VerivoltDev/test_board/modules/footprint/ESP32C3_super_mini.step

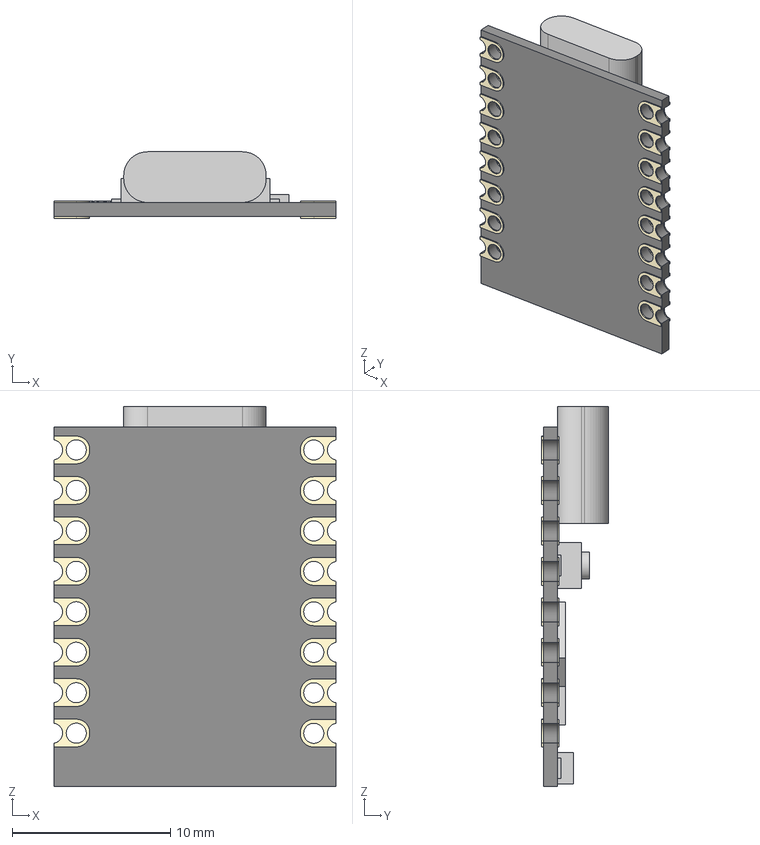
[picture p1: CAD file, 2025-04-20]
modules/footprint/ESP32C3_super_mini.step
17.8 x 4.20 x 24.0 mm
