VerivoltDev/test_board/modules/Symbol/ESP32-C3_SUPERMINI_TH.step

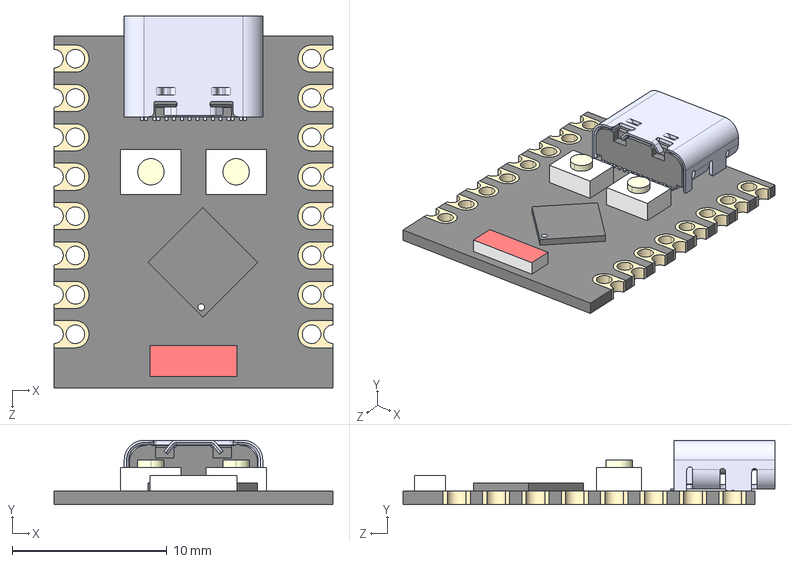
[picture p2: CAD file, 2025-04-15]
modules/Symbol/ESP32-C3_SUPERMINI_TH.step
18.0 x 4.16 x 24.0 mm
Board c3mini
USB C
components (other)^ESP32-C3 SuperMini
