VerivoltDev/test_board/test_board/kicad-modules/shapes3d/D3V3F8U9LP3810-7.stp

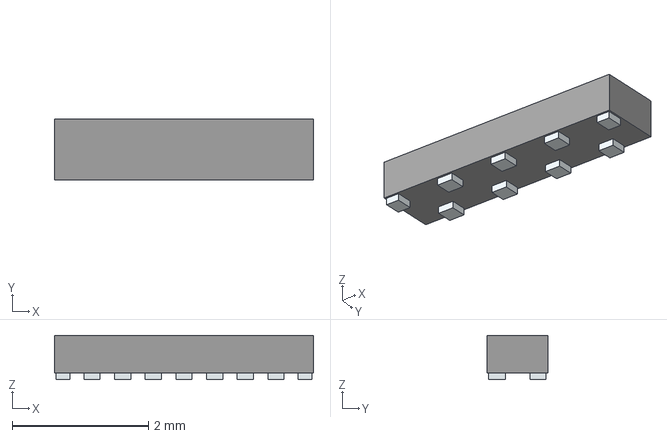
[picture p3: CAD file, 2025-04-15]
test_board/kicad-modules/shapes3d/D3V3F8U9LP3810-7.stp
3.80 x 0.9 x 0.65 mm
Pins
