VerivoltDev/test_board/modules/footprint/QFN50P450X350X100-21N.step

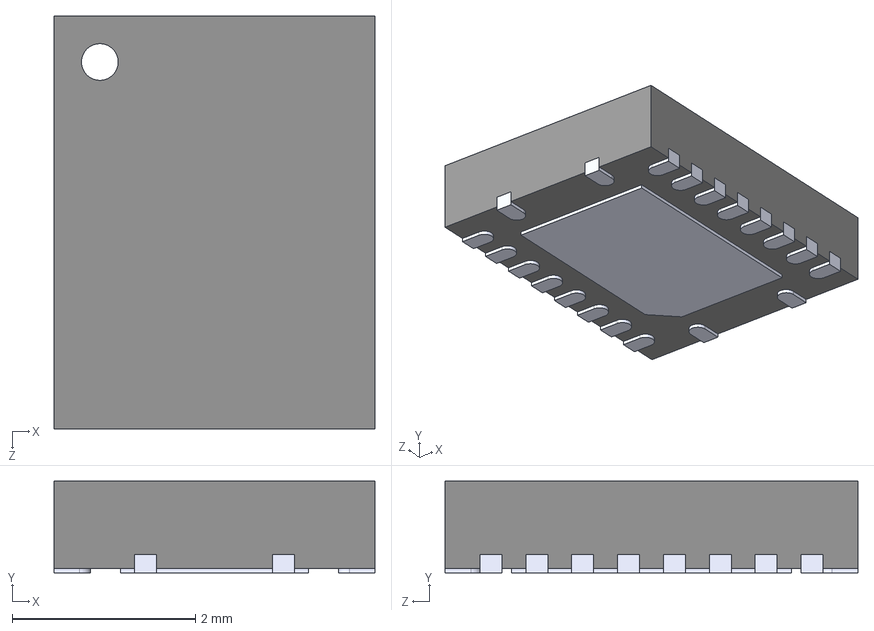
[picture p4: CAD file, 2025-04-15]
modules/footprint/QFN50P450X350X100-21N.step
3.50 x 1.00 x 4.50 mm
