VerivoltDev/test_board/test_board/kicad-modules/shapes3d/S_5_ADI.step

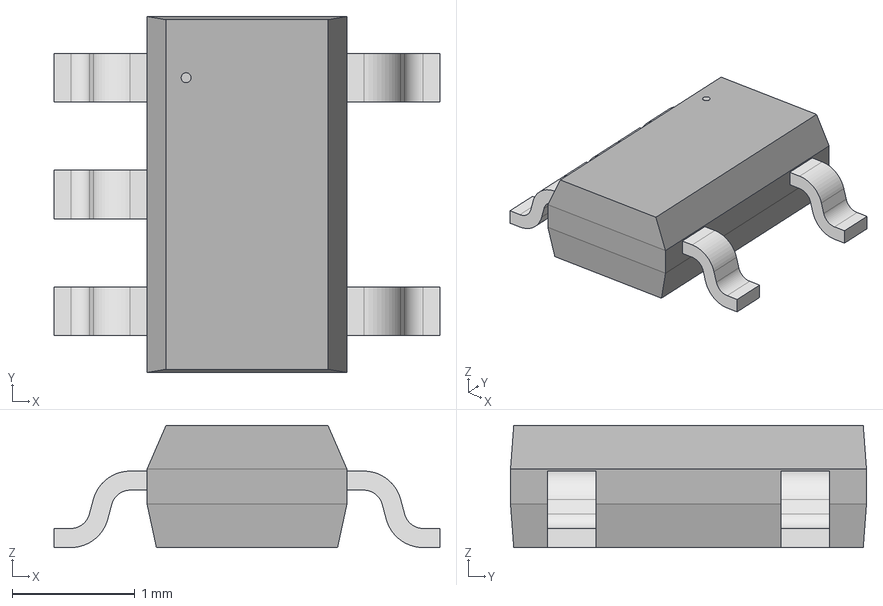
[picture p5: CAD file, 2025-04-15]
test_board/kicad-modules/shapes3d/S_5_ADI.step
3.14 x 2.90 x 0.993 mm
