VerivoltDev/test_board/modules/footprint/LPJ4011ABNL.STEP

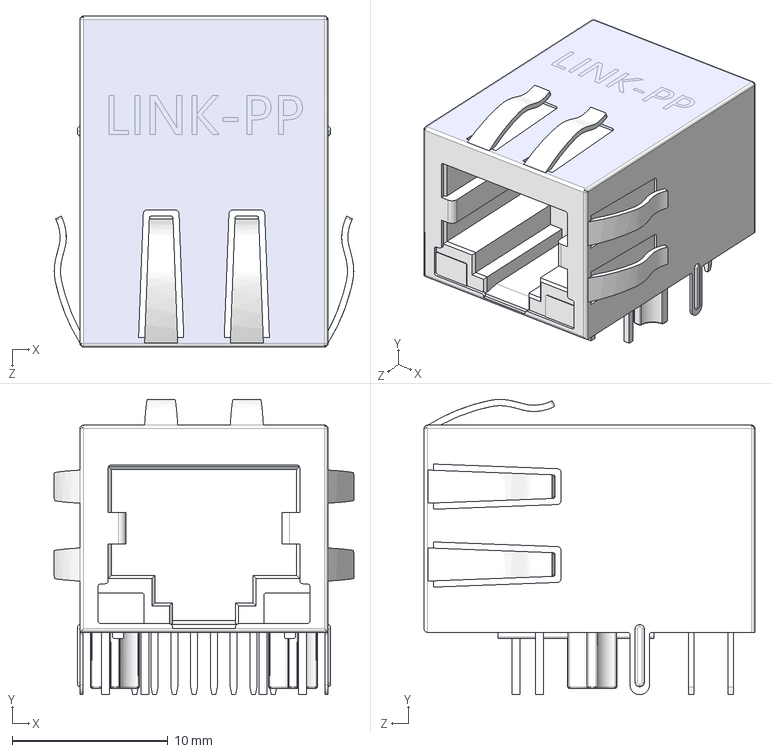
[picture p6: CAD file, 2025-04-15]
modules/footprint/LPJ4011ABNL.STEP
19.2 x 18.9 x 21.3 mm
