VerivoltDev/test_board/test_board/kicad-modules/shapes3d/PWP0020A_LM5116MH.stp

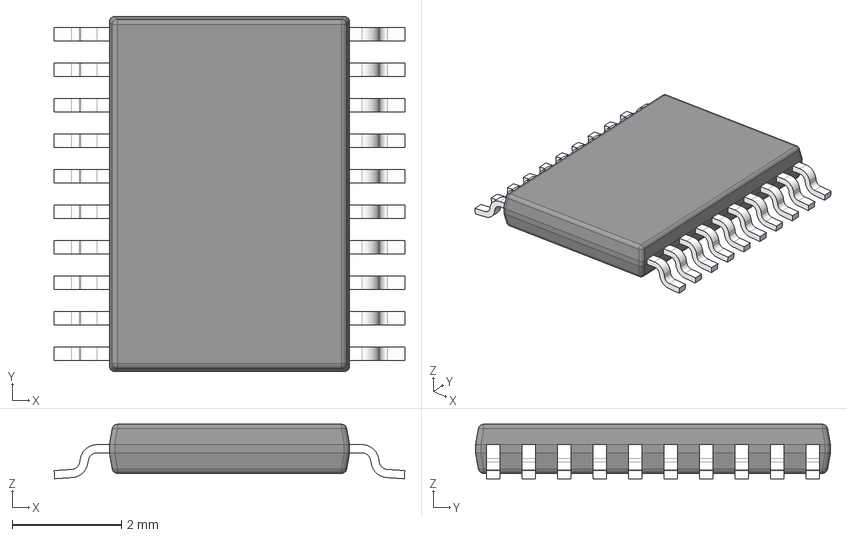
[picture p7: CAD file, 2025-04-15]
test_board/kicad-modules/shapes3d/PWP0020A_LM5116MH.stp
6.42 x 6.50 x 1.00 mm
BODY-SO
LEAD-SO x 20
THERMALPAD-SO
PIN1-ID
