VerivoltDev/test_board/modules/footprint/HD3SS3212IRKSR.step

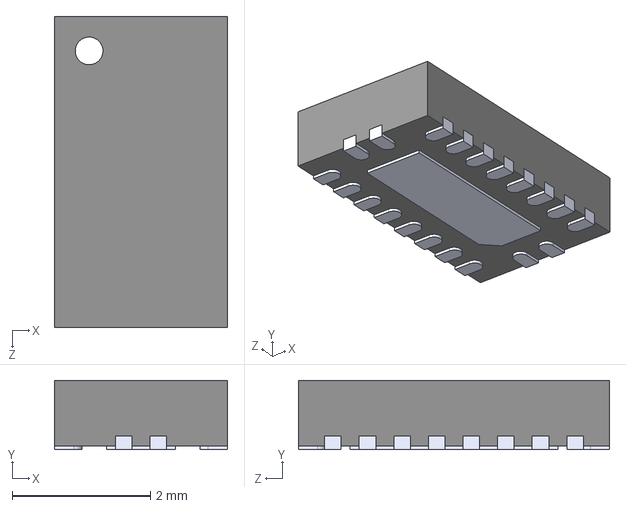
[picture p8: CAD file, 2025-04-15]
modules/footprint/HD3SS3212IRKSR.step
2.50 x 1.00 x 4.50 mm
