VerivoltDev/test_board/test_board/kicad-modules/shapes3d/PJS008U-3000-0.stp

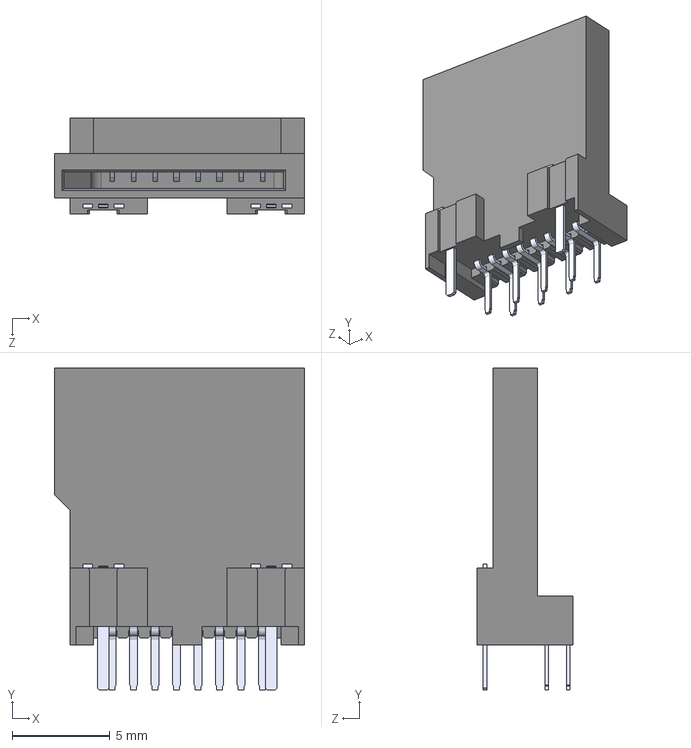
[picture p9: CAD file, 2025-04-15]
test_board/kicad-modules/shapes3d/PJS008U-3000-0.stp
12.8 x 16.5 x 4.90 mm
