VerivoltDev/test_board/test_board/kicad-modules/shapes3d/IND_MCZ1210AH_TDK.step

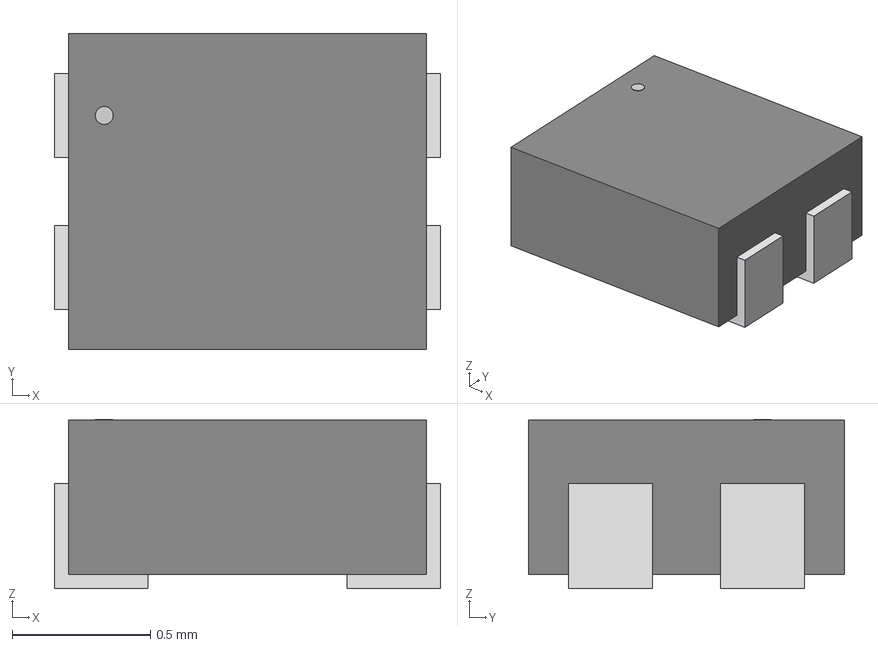
[picture p10: CAD file, 2025-04-15]
test_board/kicad-modules/shapes3d/IND_MCZ1210AH_TDK.step
1.40 x 1.14 x 0.612 mm
