VerivoltDev/test_board/modules/footprint/NX3225SA v2.step

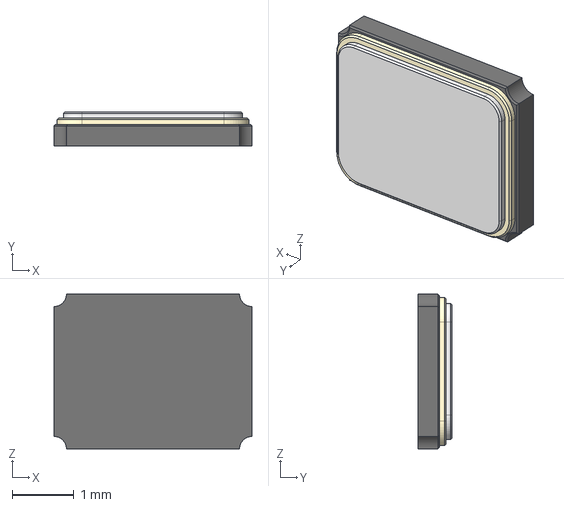
[picture p11: CAD file, 2025-04-15]
modules/footprint/NX3225SA v2.step
3.20 x 0.55 x 2.50 mm
