VerivoltDev/test_board/test_board/kicad-modules/shapes3d/SWR204-NRTN-D02-ST-GA.STEP

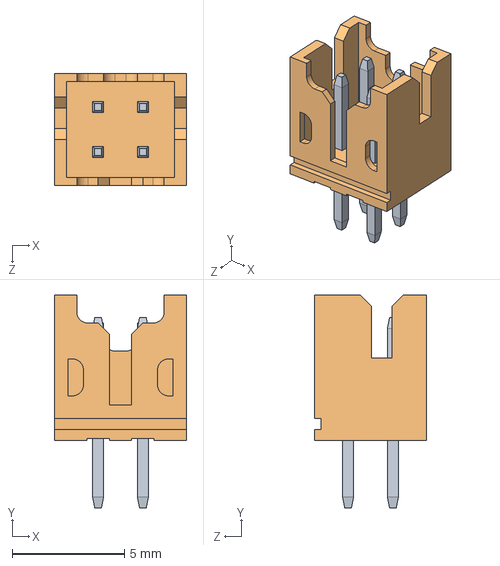
[picture p12: CAD file, 2025-04-15]
test_board/kicad-modules/shapes3d/SWR204-NRTN-D02-ST-GA.STEP
5.90 x 9.50 x 5.00 mm
