VerivoltDev/test_board/modules/footprint/SOT-23.step

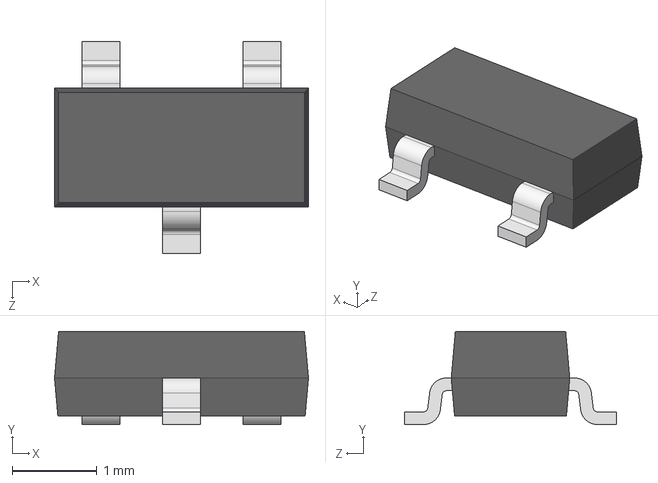
[picture p13: CAD file, 2025-04-15]
modules/footprint/SOT-23.step
3.00 x 1.10 x 2.50 mm
