VerivoltDev/test_board/test_board/kicad-modules/shapes3d/PJS008-2003-1.STEP

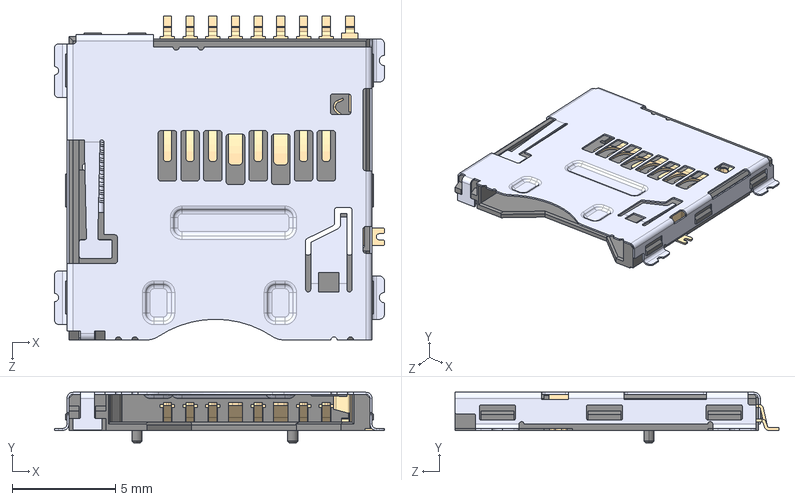
[picture p14: CAD file, 2025-04-15]
test_board/kicad-modules/shapes3d/PJS008-2003-1.STEP
16.0 x 2.45 x 15.7 mm
