VerivoltDev/test_board/modules/footprint/QFN-88_L9.0-W9.0-P0.35.step

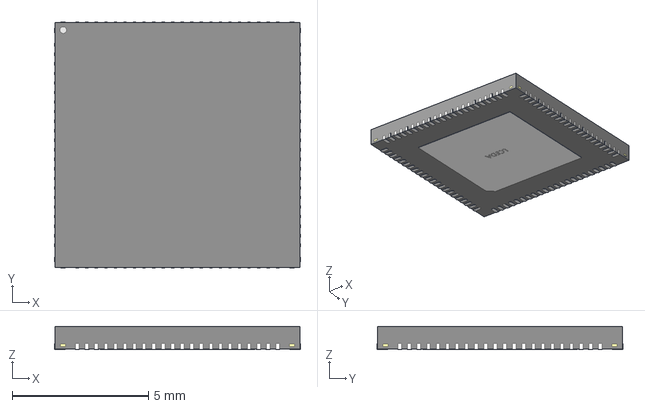
[picture p15: CAD file, 2025-04-15]
modules/footprint/QFN-88_L9.0-W9.0-P0.35.step
9.02 x 9.02 x 0.85 mm
