VerivoltDev/test_board/test_board/kicad-modules/shapes3d/DVE0016A_UCC12050DVER.stp

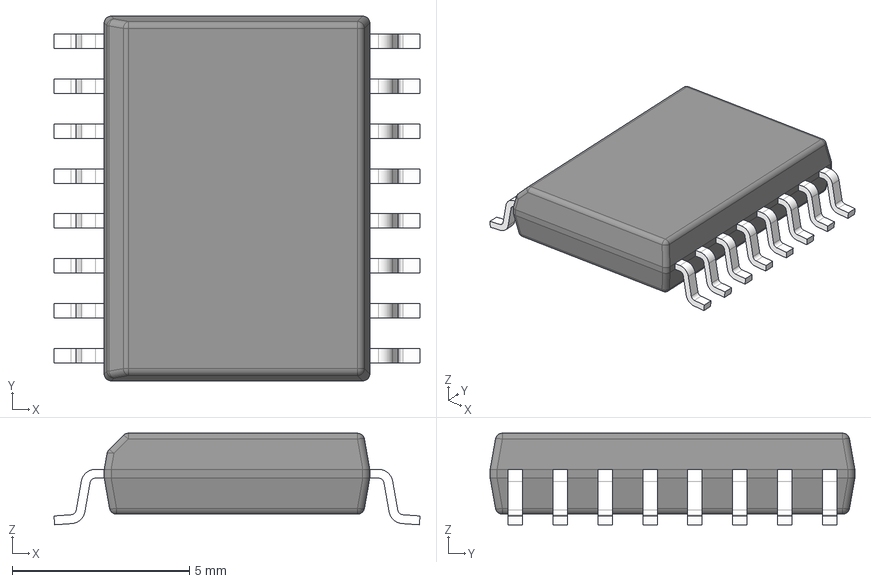
[picture p16: CAD file, 2025-04-15]
test_board/kicad-modules/shapes3d/DVE0016A_UCC12050DVER.stp
10.3 x 10.3 x 2.59 mm
BODY-DVE0016A
LEAD-DVE0016A x 16
