VerivoltDev/test_board/test_board/kicad-modules/shapes3d/2604-1101_000-023.stp

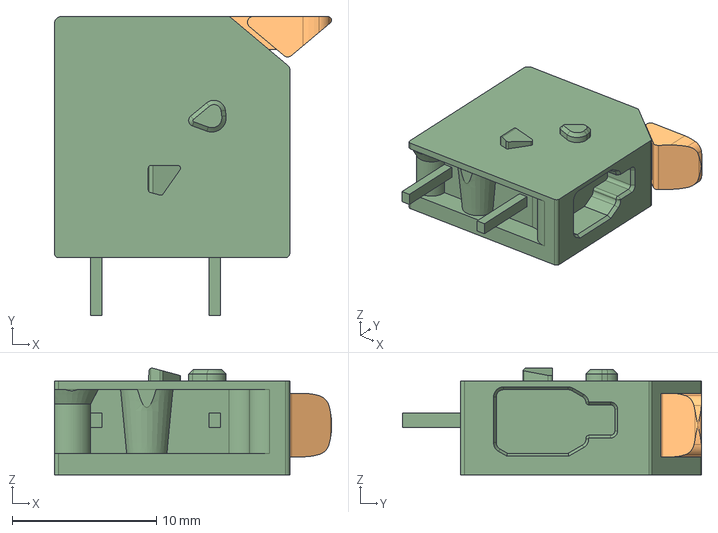
[picture p17: CAD file, 2025-04-15]
test_board/kicad-modules/shapes3d/2604-1101_000-023.stp
19.2 x 20.7 x 7.40 mm
