VerivoltDev/test_board/modules/footprint/JXS32.step

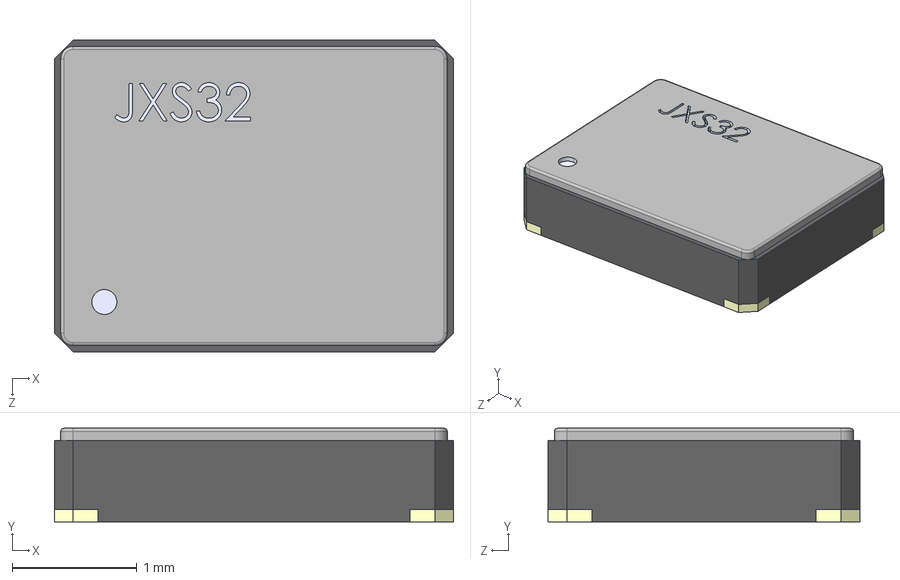
[picture p18: CAD file, 2025-04-15]
modules/footprint/JXS32.step
3.20 x 0.75 x 2.50 mm
