VerivoltDev/test_board/test_board/kicad-modules/shapes3d/WFBGA49_DDP_WIN.step

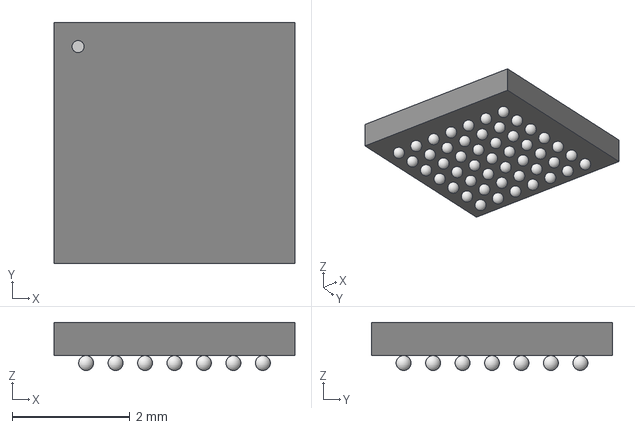
[picture p19: CAD file, 2025-04-15]
test_board/kicad-modules/shapes3d/WFBGA49_DDP_WIN.step
4.09 x 4.09 x 0.815 mm
