VerivoltDev/test_board/test_board/kicad-modules/shapes3d/VLP1-D-3.stp

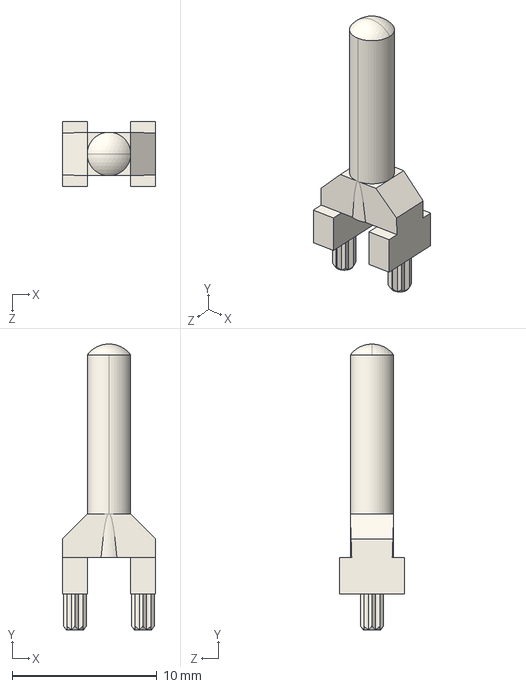
[picture p20: CAD file, 2025-04-15]
test_board/kicad-modules/shapes3d/VLP1-D-3.stp
6.40 x 19.8 x 4.50 mm
