VerivoltDev/test_board/test_board/kicad-modules/shapes3d/DFN-12_DD_LIT.step

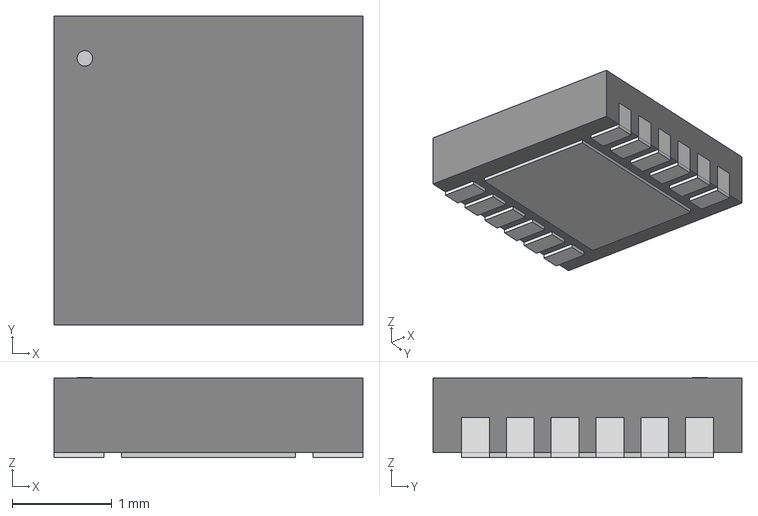
[picture p21: CAD file, 2025-04-15]
test_board/kicad-modules/shapes3d/DFN-12_DD_LIT.step
3.10 x 3.10 x 0.803 mm
