VerivoltDev/test_board/test_board/kicad-modules/shapes3d/Coilcraft-LPD5030V.STEP

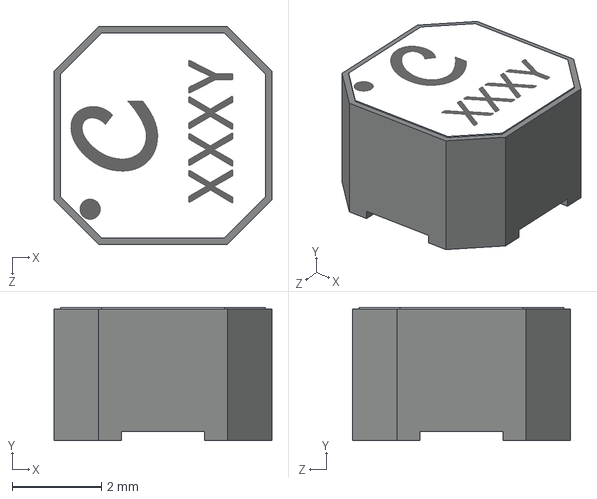
[picture p22: CAD file, 2025-04-15]
test_board/kicad-modules/shapes3d/Coilcraft-LPD5030V.STEP
4.88 x 2.98 x 4.88 mm
