VerivoltDev/test_board/test_board/kicad-modules/shapes3d/BGA38_11P25X9_ADI.step

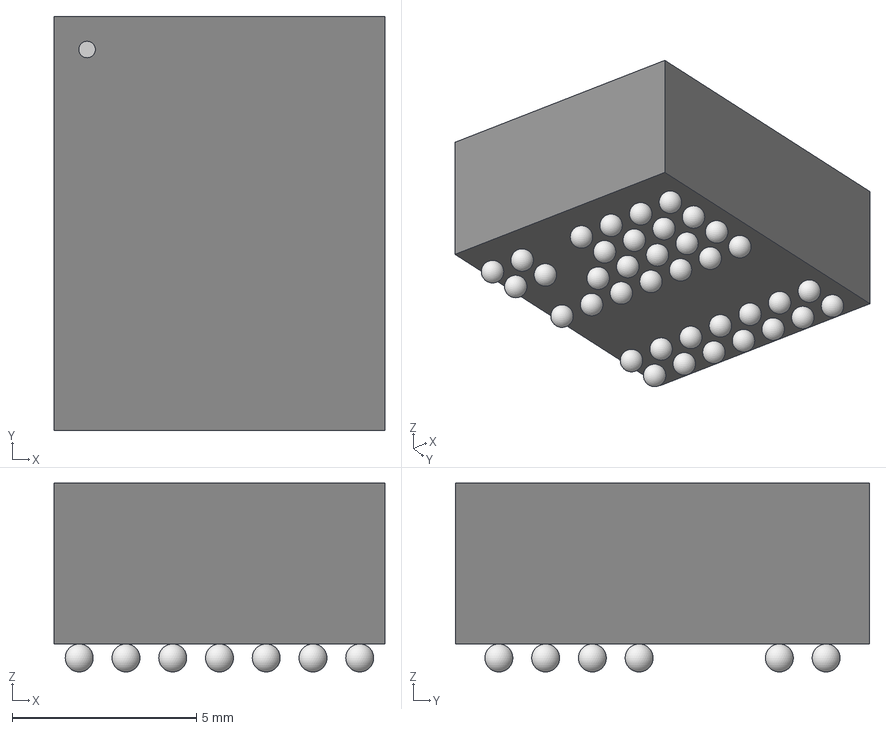
[picture p23: CAD file, 2025-04-15]
test_board/kicad-modules/shapes3d/BGA38_11P25X9_ADI.step
8.99 x 11.3 x 5.13 mm
