VerivoltDev/test_board/test_board/kicad-modules/shapes3d/SIS407DN-T1-GE3.STEP

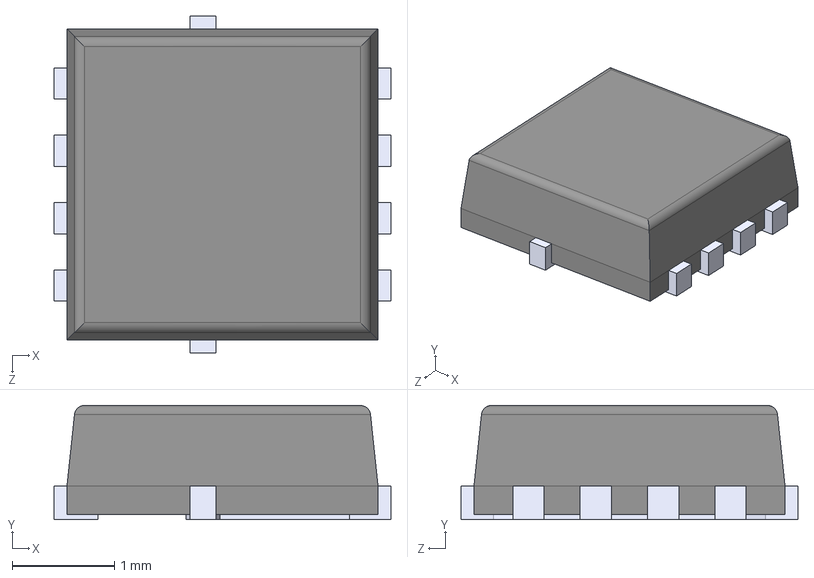
[picture p24: CAD file, 2025-04-15]
test_board/kicad-modules/shapes3d/SIS407DN-T1-GE3.STEP
3.30 x 1.12 x 3.30 mm
