VerivoltDev/test_board/test_board/kicad-modules/shapes3d/ECS-2520MV-480-BN-TR.step

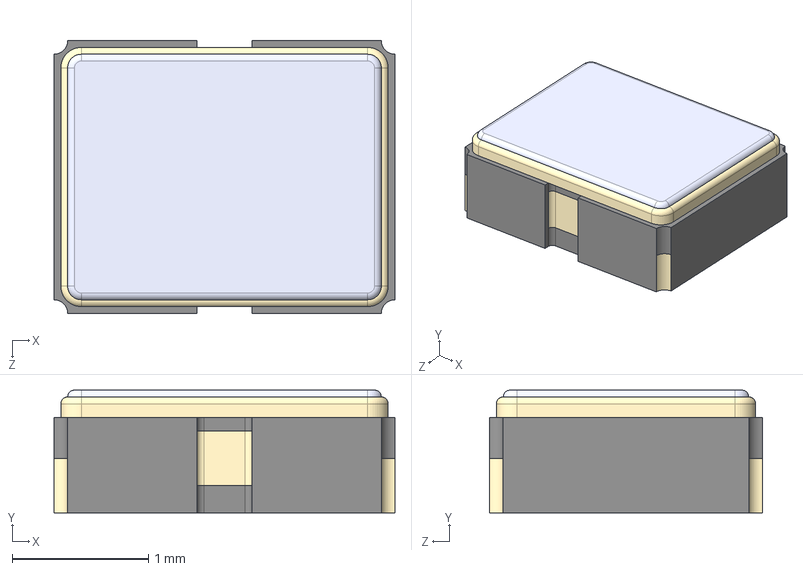
[picture p25: CAD file, 2025-04-15]
test_board/kicad-modules/shapes3d/ECS-2520MV-480-BN-TR.step
2.50 x 0.9 x 2.00 mm
