VerivoltDev/test_board/test_board/kicad-modules/shapes3d/TDA01H0SB1R.step

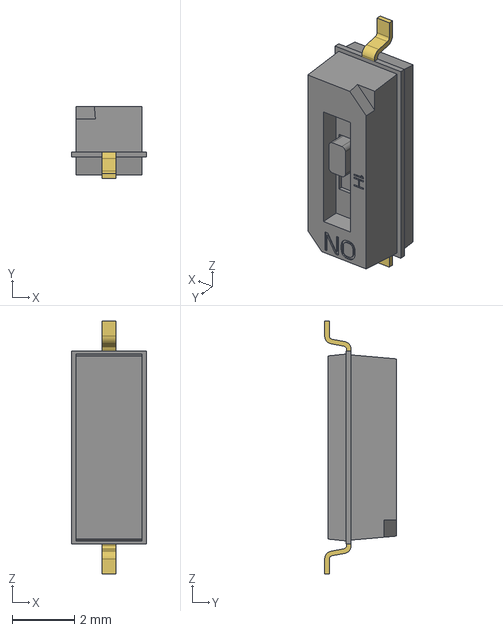
[picture p26: CAD file, 2025-04-15]
test_board/kicad-modules/shapes3d/TDA01H0SB1R.step
2.40 x 2.30 x 8.12 mm
