VerivoltDev/test_board/test_board/kicad-modules/shapes3d/c-2438987-1-1-USB_A.stp

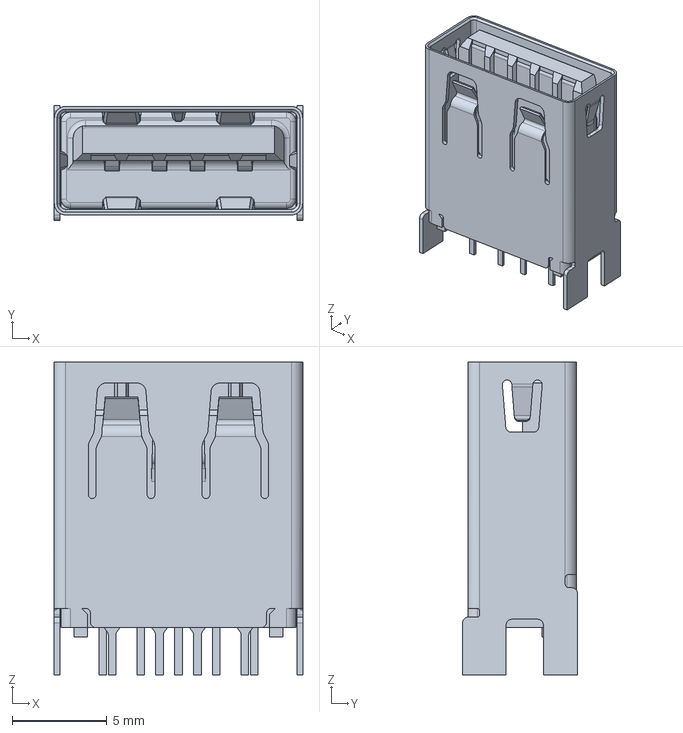
[picture p27: CAD file, 2025-04-15]
test_board/kicad-modules/shapes3d/c-2438987-1-1-USB_A.stp
13.1 x 6.06 x 16.5 mm
