VerivoltDev/test_board/test_board/kicad-modules/shapes3d/RGE0024C.stp

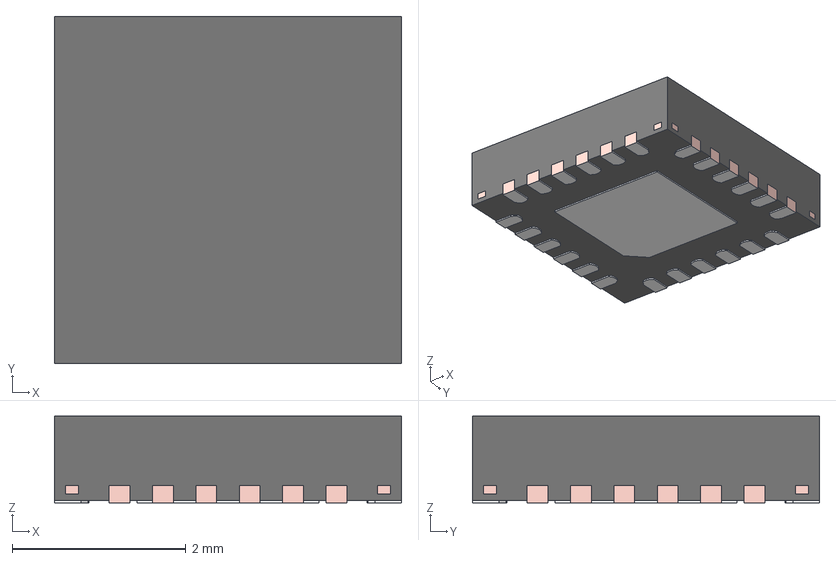
[picture p28: CAD file, 2025-04-15]
test_board/kicad-modules/shapes3d/RGE0024C.stp
4.00 x 4.00 x 1.00 mm
FRAME
