VerivoltDev/test_board/test_board/kicad-modules/shapes3d/TL7702BCDR.stp

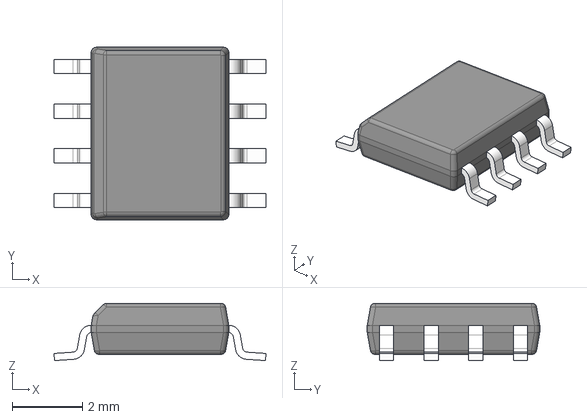
[picture p29: CAD file, 2025-04-15]
test_board/kicad-modules/shapes3d/TL7702BCDR.stp
6.02 x 4.90 x 1.63 mm
BODY-SO
LEAD-D0008A x 8
