VerivoltDev/test_board/test_board/kicad-modules/shapes3d/NGU0008B.stp

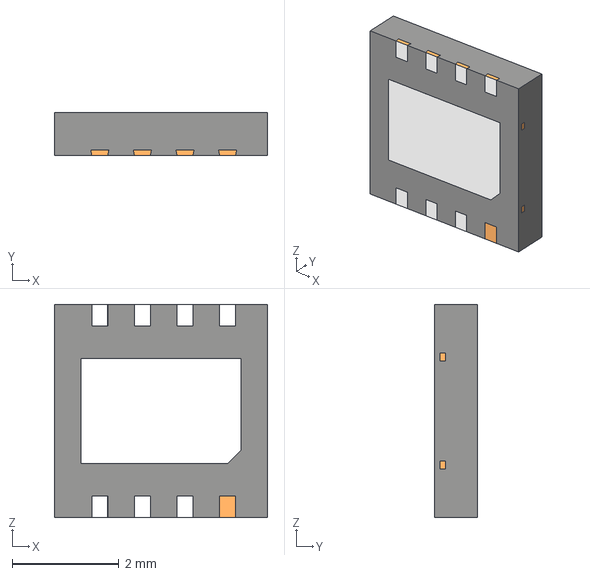
[picture p30: CAD file, 2025-04-15]
test_board/kicad-modules/shapes3d/NGU0008B.stp
4.00 x 0.8 x 4.00 mm
BODY_SDC08B
FRAME_SDC08B
