VerivoltDev/test_board/test_board/kicad-modules/shapes3d/QTH-040-04-X-D-DP-A.step

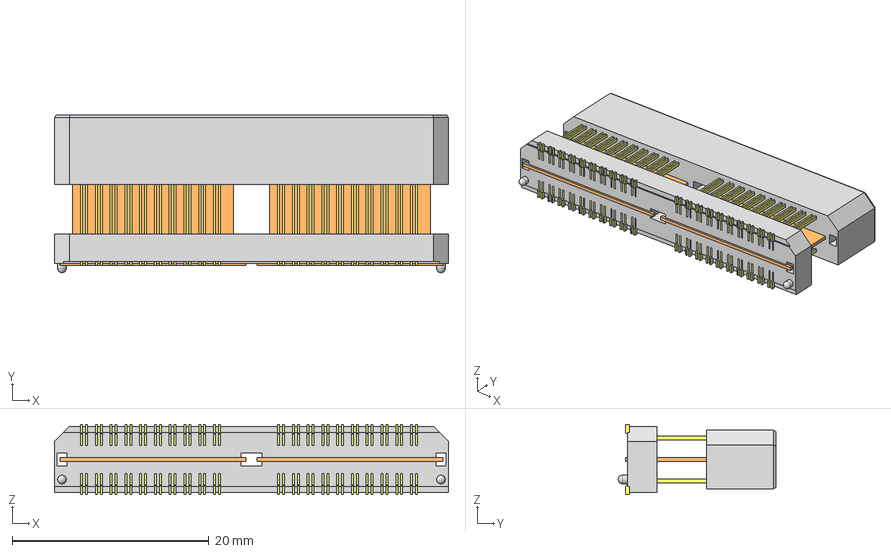
[picture p31: CAD file, 2025-04-15]
test_board/kicad-modules/shapes3d/QTH-040-04-X-D-DP-A.step
40.0 x 16.0 x 7.11 mm
LTQTH-040-04-L-D-DP-A_lower_terminal
T-1G1-04_imp x 2
T-1S60-04(-040-04-D-DP)_pin x 2
TQTH-040-04-L-D-DP-A_terminal
