VerivoltDev/test_board/test_board/kicad-modules/shapes3d/User Library-Countersunk_M2,5x12_H_real_thread.step

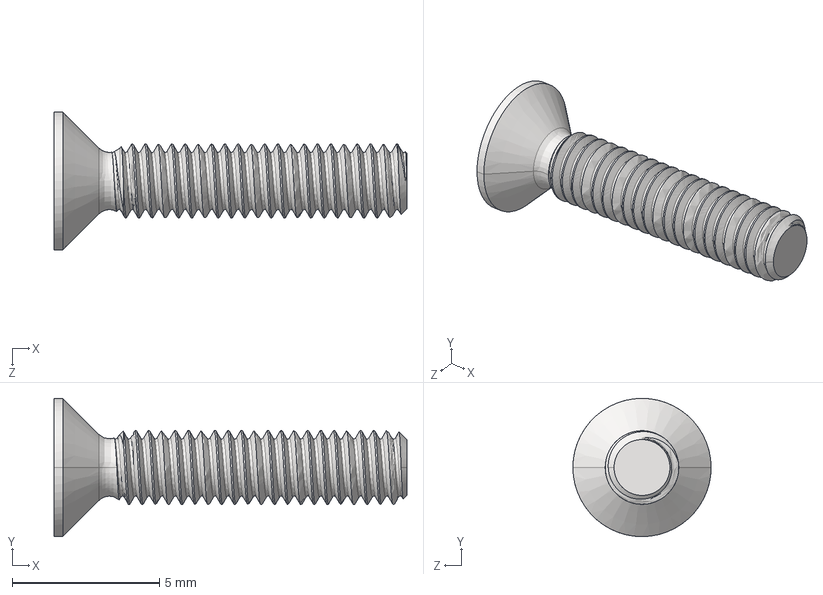
[picture p32: CAD file, 2025-04-15]
test_board/kicad-modules/shapes3d/User Library-Countersunk_M2,5x12_H_real_thread.step
12.0 x 4.70 x 4.70 mm
