VerivoltDev/test_board/test_board/kicad-modules/shapes3d/SCMR14C474PRBA0.stp

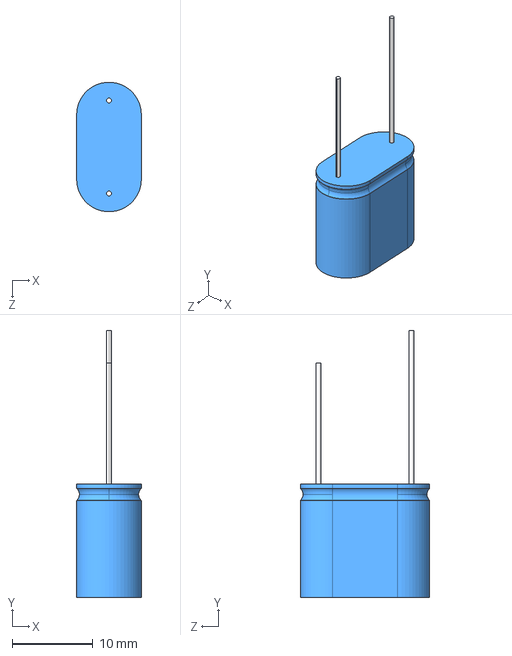
[picture p33: CAD file, 2025-04-15]
test_board/kicad-modules/shapes3d/SCMR14C474PRBA0.stp
8.00 x 33.0 x 16.0 mm
