VerivoltDev/test_board/test_board/kicad-modules/shapes3d/PDQE20-Q24-S5-D.step

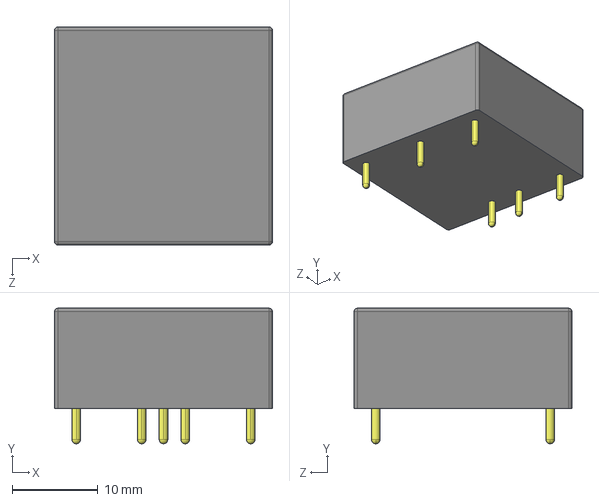
[picture p34: CAD file, 2025-04-15]
test_board/kicad-modules/shapes3d/PDQE20-Q24-S5-D.step
25.4 x 15.8 x 25.4 mm
