VerivoltDev/test_board/test_board/kicad-modules/shapes3d/ARJ-146.STEP

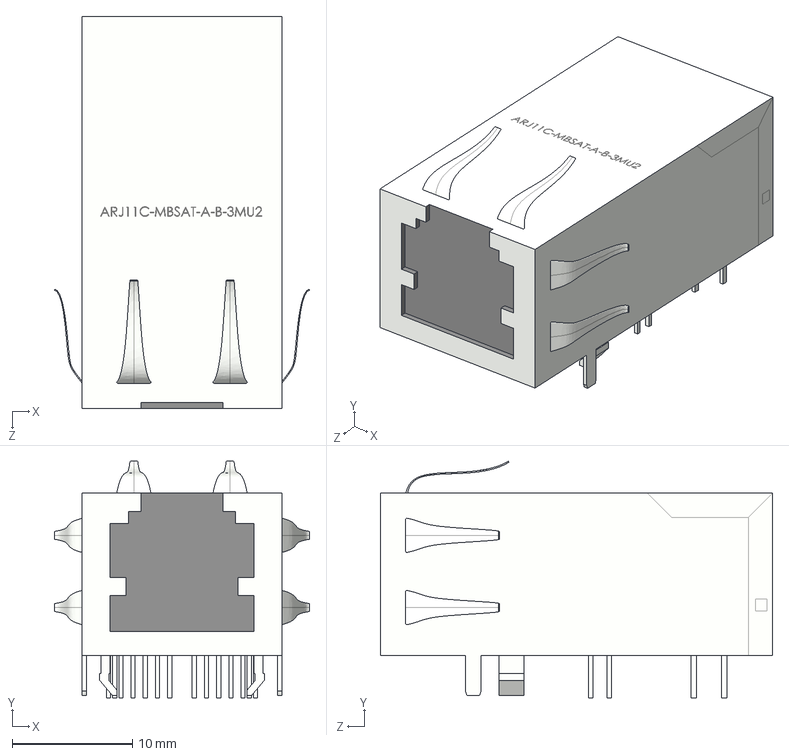
[picture p35: CAD file, 2025-04-15]
test_board/kicad-modules/shapes3d/ARJ-146.STEP
21.2 x 19.7 x 32.6 mm
