VerivoltDev/test_board/test_board/kicad-modules/shapes3d/RCU-0C.step

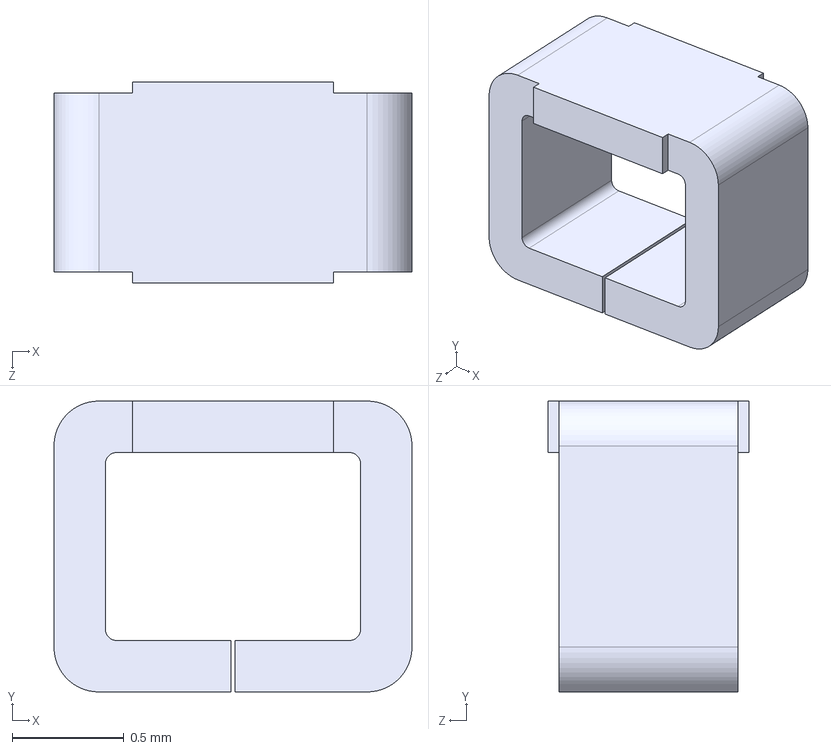
[picture p36: CAD file, 2025-04-15]
test_board/kicad-modules/shapes3d/RCU-0C.step
1.60 x 1.30 x 0.9 mm
