VerivoltDev/test_board/test_board/kicad-modules/shapes3d/B8B-PHDSS(LF)(SN).stp

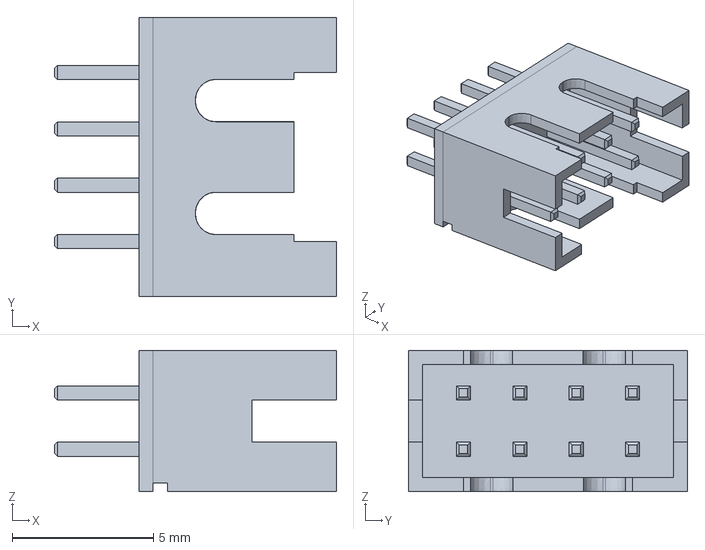
[picture p37: CAD file, 2025-04-15]
test_board/kicad-modules/shapes3d/B8B-PHDSS(LF)(SN).stp
10.0 x 9.90 x 5.00 mm
