VerivoltDev/test_board/test_board/kicad-modules/shapes3d/BGA-25_6P25X6P25_LIT.step

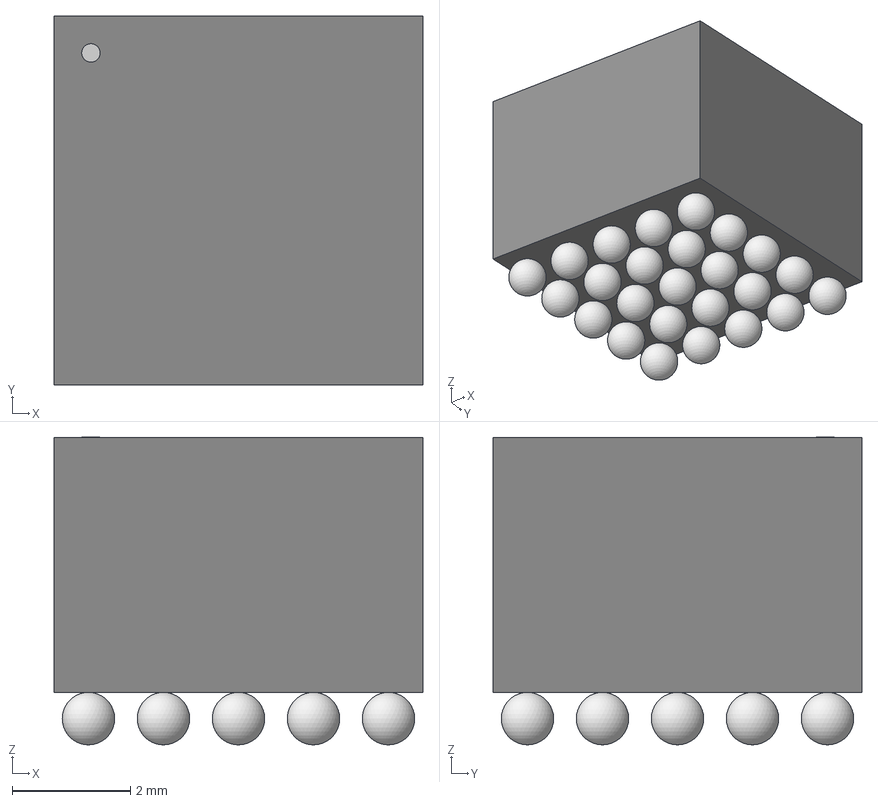
[picture p38: CAD file, 2025-04-15]
test_board/kicad-modules/shapes3d/BGA-25_6P25X6P25_LIT.step
6.25 x 6.25 x 5.21 mm
