VerivoltDev/test_board/test_board/kicad-modules/shapes3d/DFN_2PU50R_STM.step

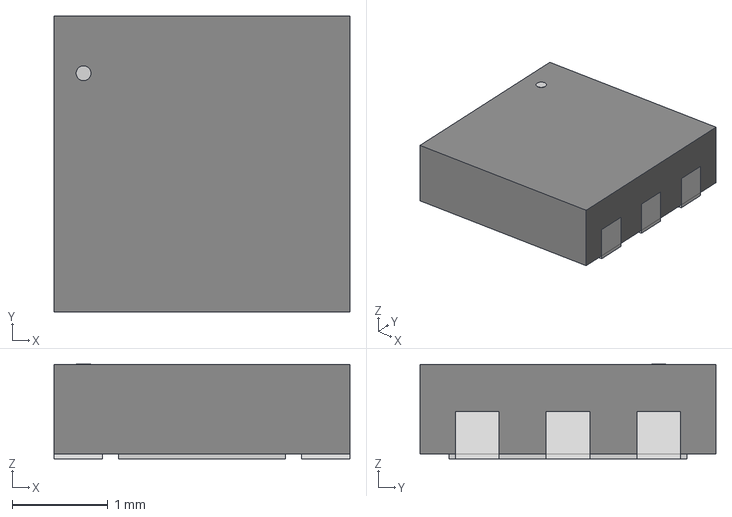
[picture p39: CAD file, 2025-04-15]
test_board/kicad-modules/shapes3d/DFN_2PU50R_STM.step
3.10 x 3.10 x 0.993 mm
