VerivoltDev/test_board/test_board/kicad-modules/shapes3d/WA-SMSI_9774XXX243.step

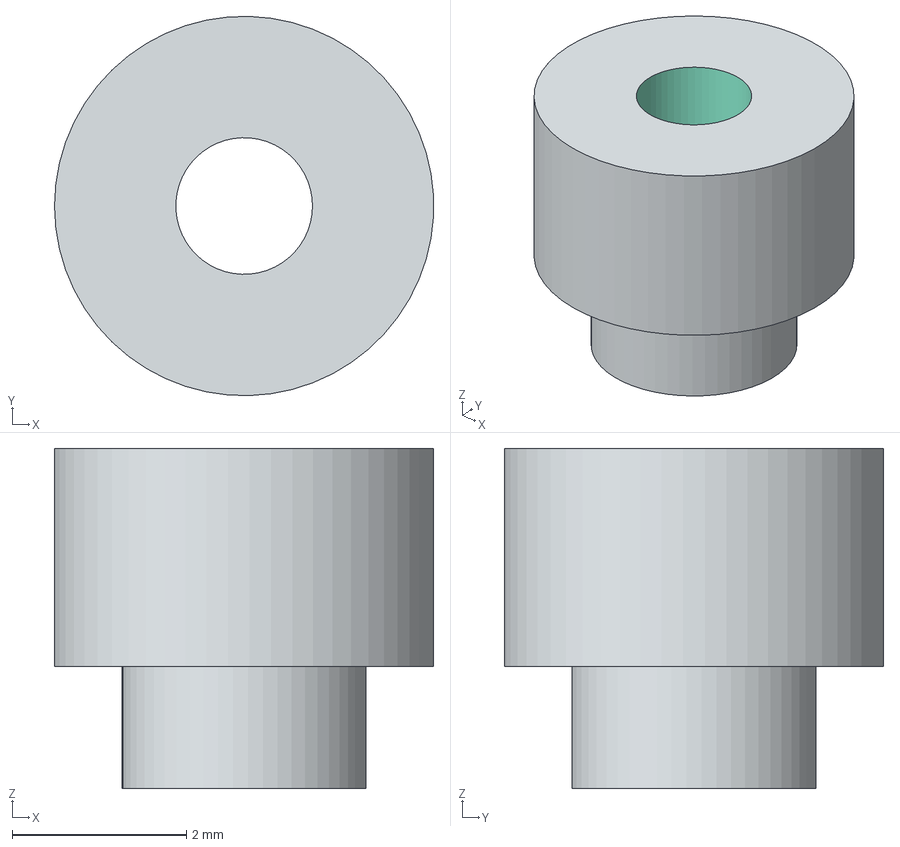
[picture p40: CAD file, 2025-04-15]
test_board/kicad-modules/shapes3d/WA-SMSI_9774XXX243.step
4.35 x 4.35 x 3.90 mm
