VerivoltDev/test_board/test_board/kicad-modules/shapes3d/ST_64_2_ADI.step

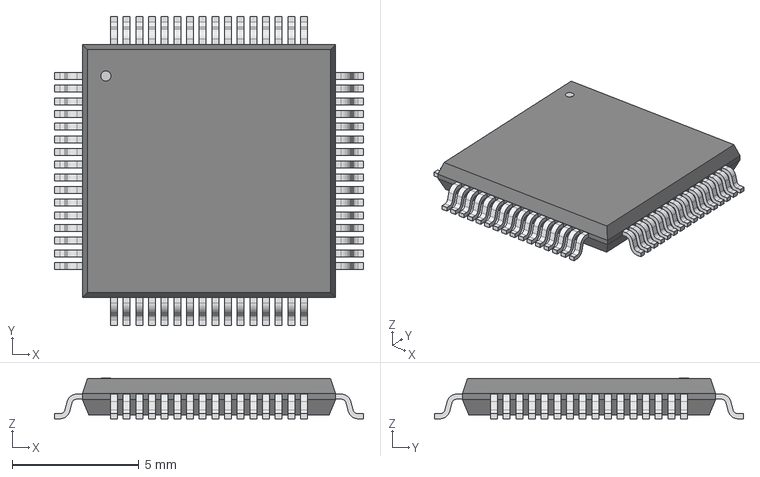
[picture p41: CAD file, 2025-04-15]
test_board/kicad-modules/shapes3d/ST_64_2_ADI.step
12.2 x 12.2 x 1.60 mm
