VerivoltDev/test_board/test_board/kicad-modules/shapes3d/RGZ0048B.stp

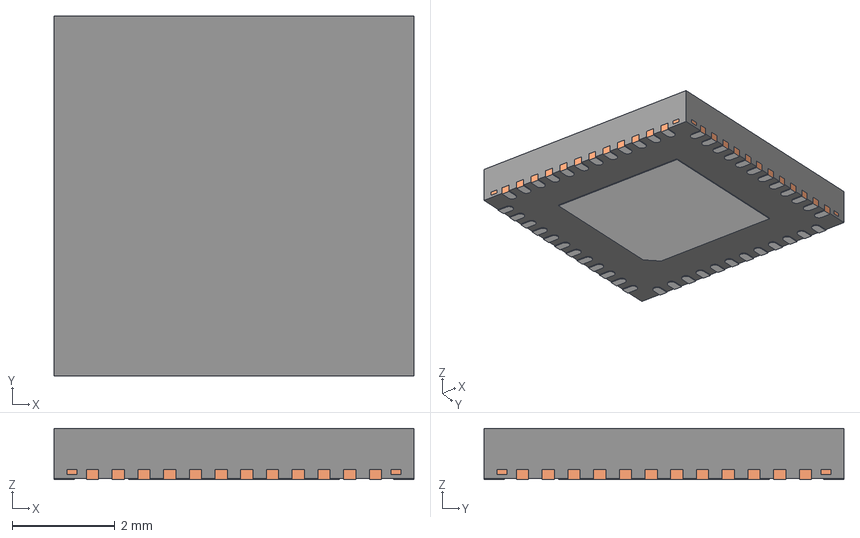
[picture p42: CAD file, 2025-04-15]
test_board/kicad-modules/shapes3d/RGZ0048B.stp
7.00 x 7.00 x 1.00 mm
BODY-QFN
FRAME-RGZ0048B
PIN1-ID
