VerivoltDev/test_board/test_board/kicad-modules/shapes3d/SKRTLAE010.STEP

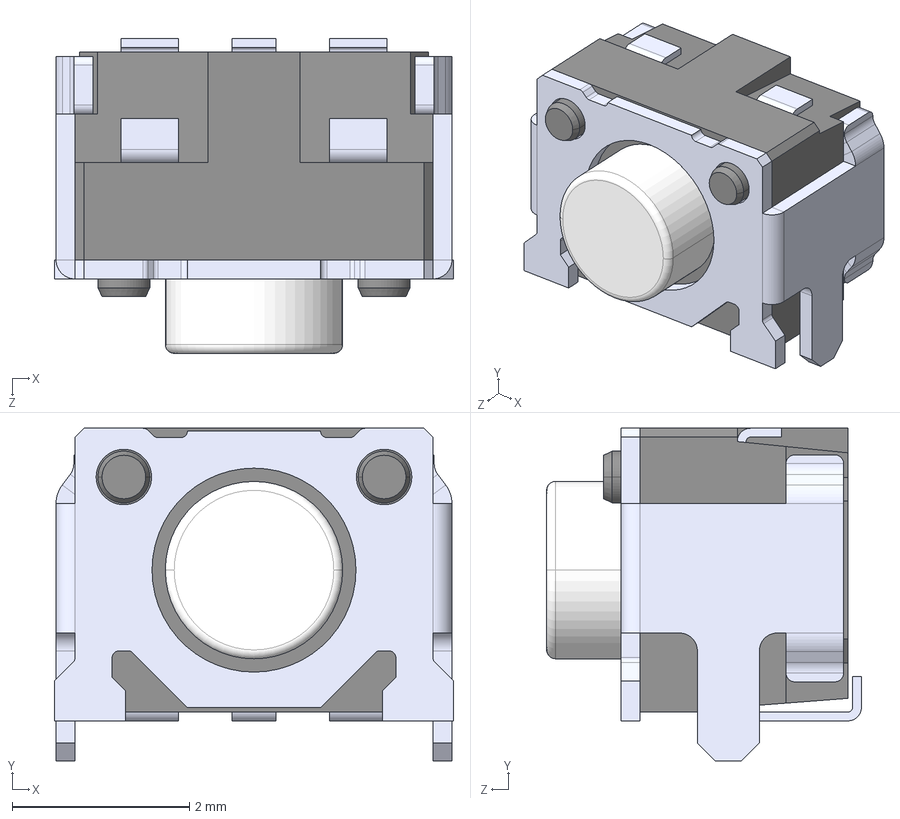
[picture p43: CAD file, 2025-04-15]
test_board/kicad-modules/shapes3d/SKRTLAE010.STEP
4.50 x 3.75 x 3.55 mm
