VerivoltDev/test_board/test_board/kicad-modules/shapes3d/2242_B_M.step

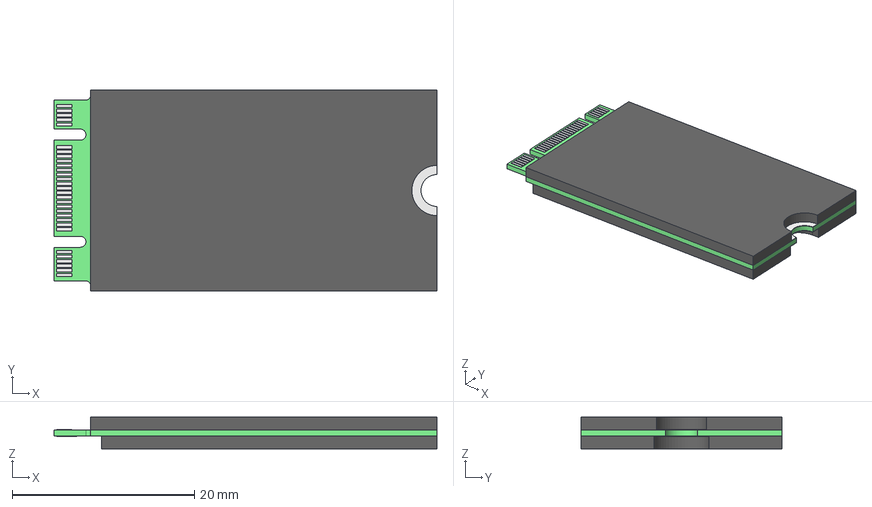
[picture p44: CAD file, 2025-04-15]
test_board/kicad-modules/shapes3d/2242_B_M.step
42.0 x 22.0 x 3.50 mm
PCB
Pin_TOP
GND_TOP
GND_BOTTOM
Pin_Bottom
Component_Area_TOP
Component_Area_BOTTOM
