VerivoltDev/test_board/test_board/kicad-modules/shapes3d/SMBJ6.0CA.step

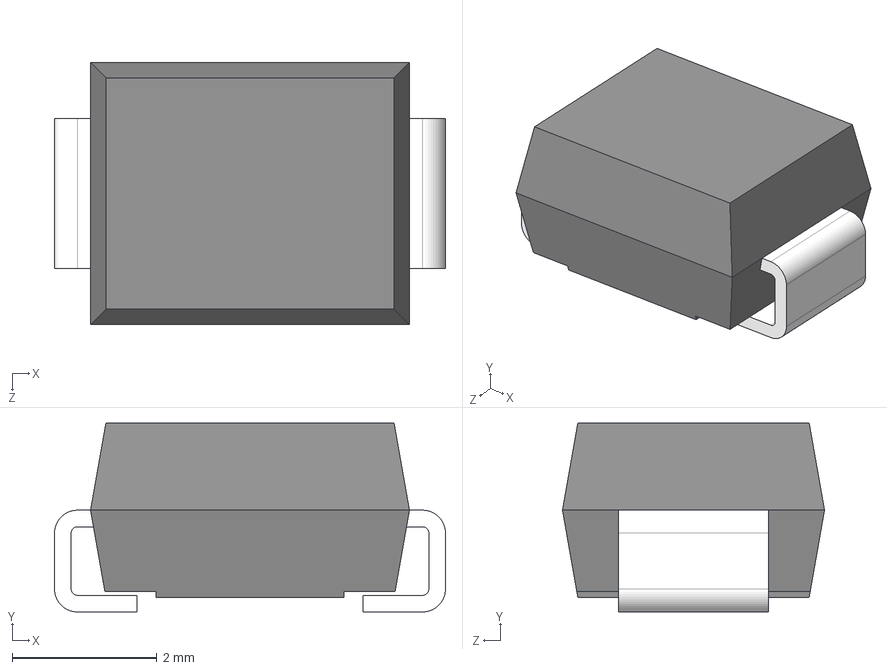
[picture p45: CAD file, 2025-04-15]
test_board/kicad-modules/shapes3d/SMBJ6.0CA.step
5.40 x 2.61 x 3.62 mm
