VerivoltDev/test_board/test_board/kicad-modules/shapes3d/cu_sbrio-9651.dxf

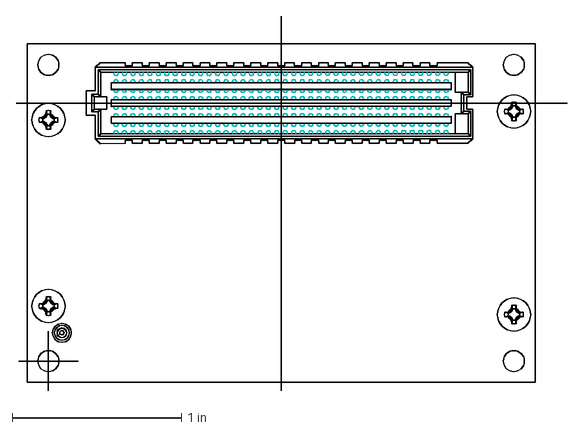
[picture p46: CAD file, 2025-04-15]
test_board/kicad-modules/shapes3d/cu_sbrio-9651.dxf
3.26 x 2.21 in
