VerivoltDev/test_board/test_board/kicad-modules/shapes3d/18_SIZE_CODE_K16.stp

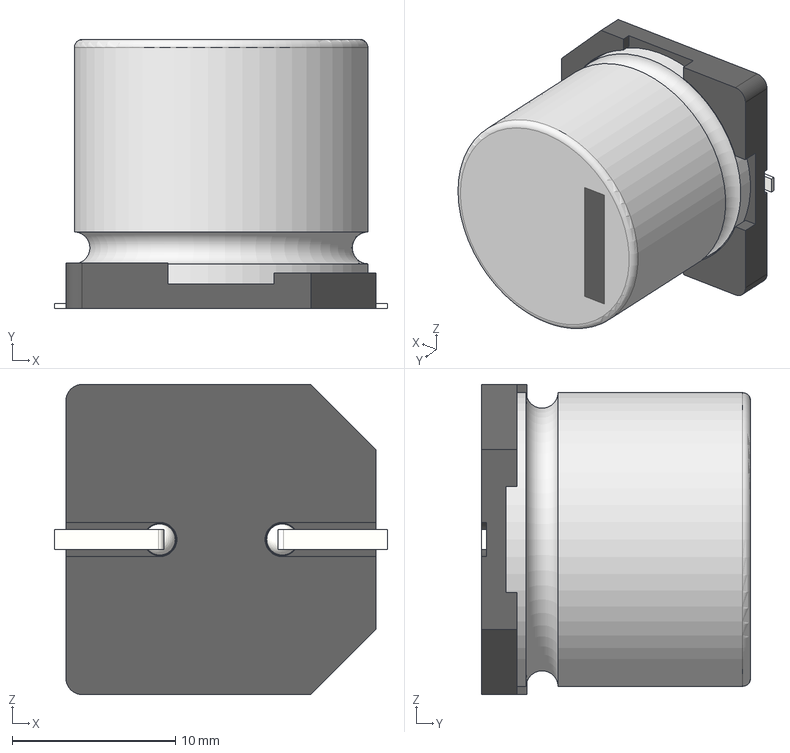
[picture p47: CAD file, 2025-04-15]
test_board/kicad-modules/shapes3d/18_SIZE_CODE_K16.stp
20.4 x 16.5 x 19.0 mm
標準品ケースΦ18x15L SIDE CODE K1 6
標準品座版Φ18 SIZE CODE K16
標準品リード線Φ18 SIZE CODE K1 6 x 2
