VerivoltDev/test_board/test_board/kicad-modules/shapes3d/070-6052 (rev1).STEP

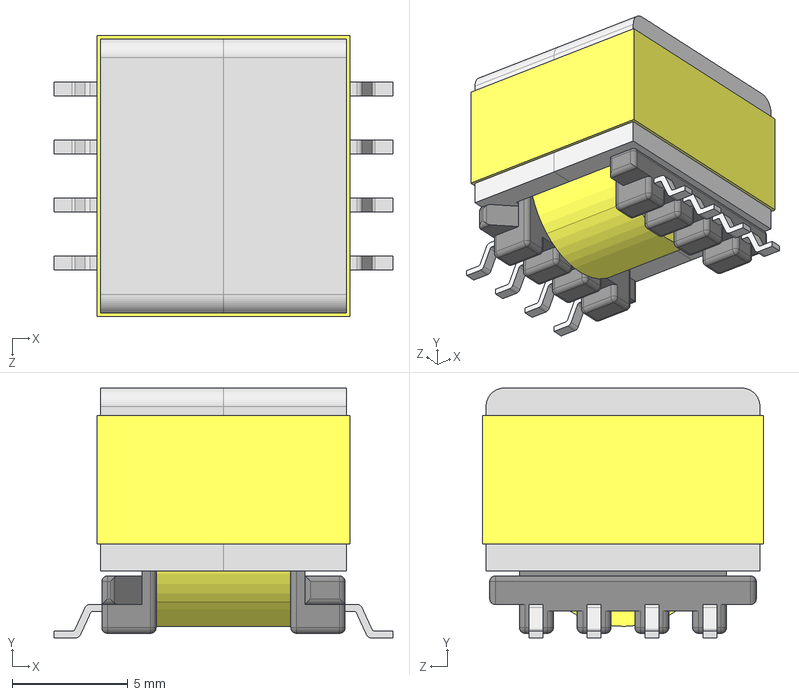
[picture p48: CAD file, 2025-04-15]
test_board/kicad-modules/shapes3d/070-6052 (rev1).STEP
14.6 x 10.8 x 12.1 mm
070-6052_6A
070-6052_coil
150-2361_6A x 2
