VerivoltDev/test_board/test_board/kicad-modules/shapes3d/QFN36_6X6_MCH.step

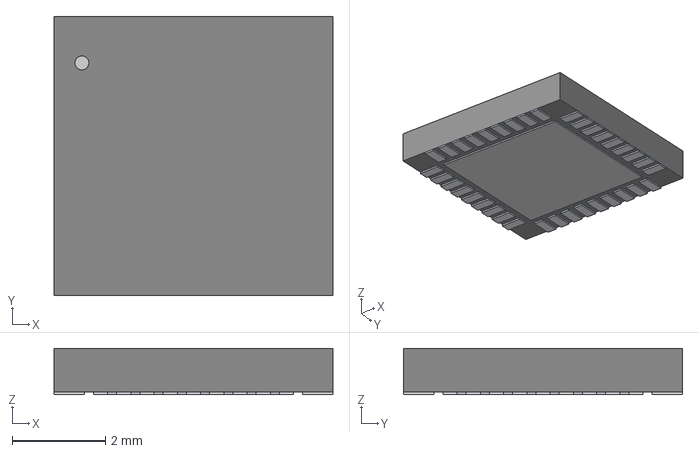
[picture p49: CAD file, 2025-04-15]
test_board/kicad-modules/shapes3d/QFN36_6X6_MCH.step
5.99 x 5.99 x 0.993 mm
