VerivoltDev/test_board/test_board/kicad-modules/shapes3d/QFN32_SLB9670VQ20FW785XTMA1_INF.step

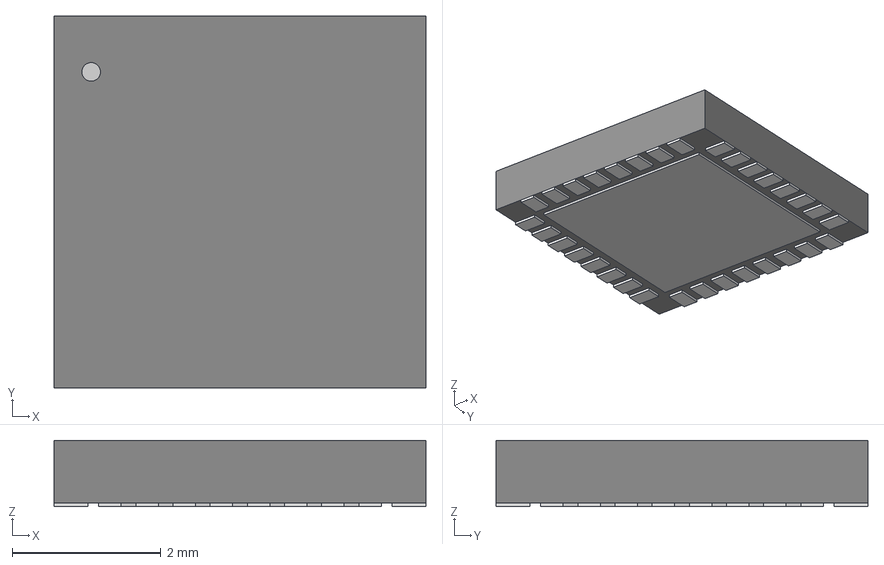
[picture p50: CAD file, 2025-04-15]
test_board/kicad-modules/shapes3d/QFN32_SLB9670VQ20FW785XTMA1_INF.step
5.00 x 5.00 x 0.892 mm
