VerivoltDev/test_board/test_board/kicad-modules/shapes3d/LTM8024EY#PBF.stp

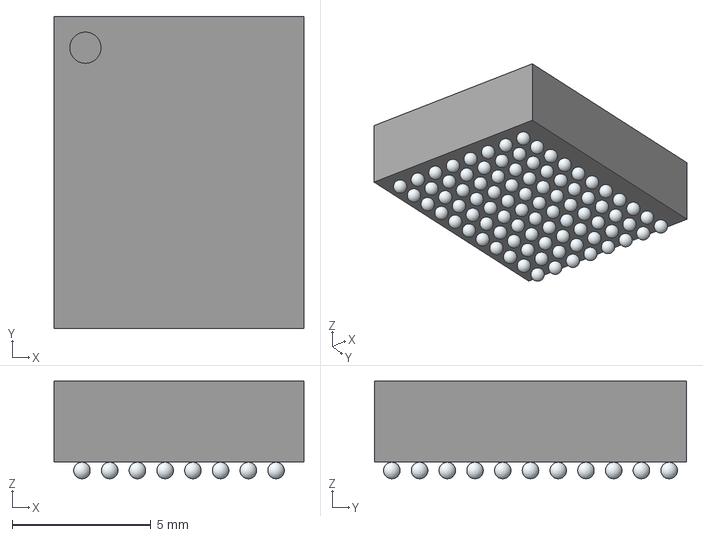
[picture p51: CAD file, 2025-04-15]
test_board/kicad-modules/shapes3d/LTM8024EY#PBF.stp
9.00 x 11.2 x 3.52 mm
