VerivoltDev/test_board/test_board/kicad-modules/shapes3d/USB4120-03-C_REVA.step

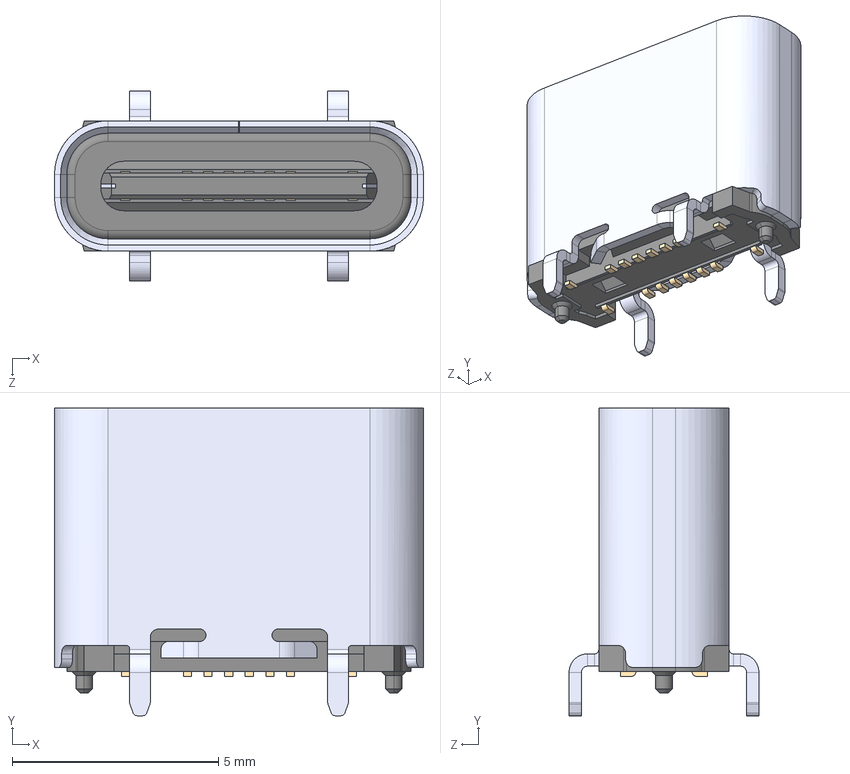
[picture p52: CAD file, 2025-04-15]
test_board/kicad-modules/shapes3d/USB4120-03-C_REVA.step
8.94 x 7.45 x 4.60 mm
