VerivoltDev/test_board/test_board/kicad-modules/shapes3d/SN74AUP1G32DPWR.stp

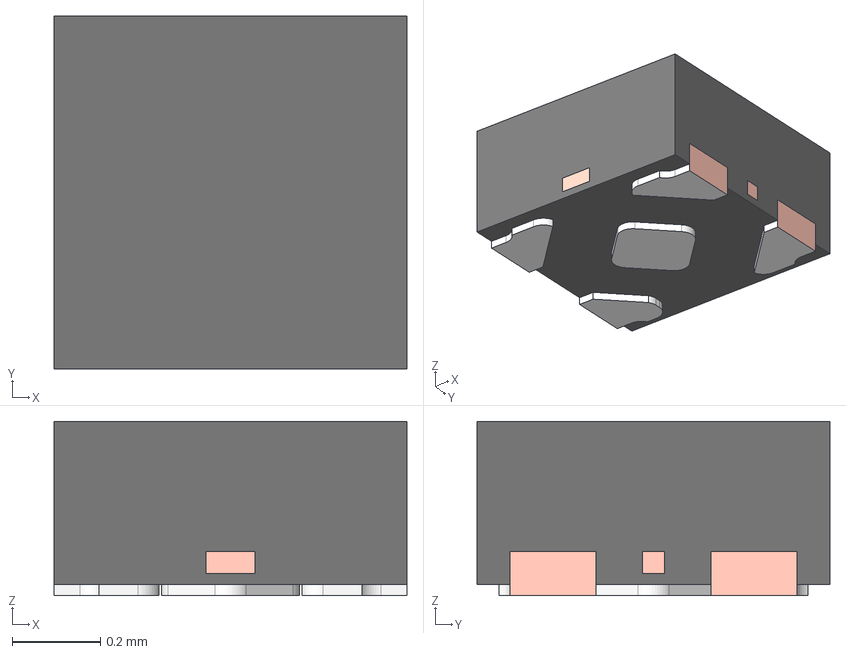
[picture p53: CAD file, 2025-04-15]
test_board/kicad-modules/shapes3d/SN74AUP1G32DPWR.stp
0.8 x 0.8 x 0.395 mm
BODY-SON
FRAME-DPW0005A
PIN1-ID
