VerivoltDev/test_board/test_board/kicad-modules/shapes3d/DBV0005A.stp

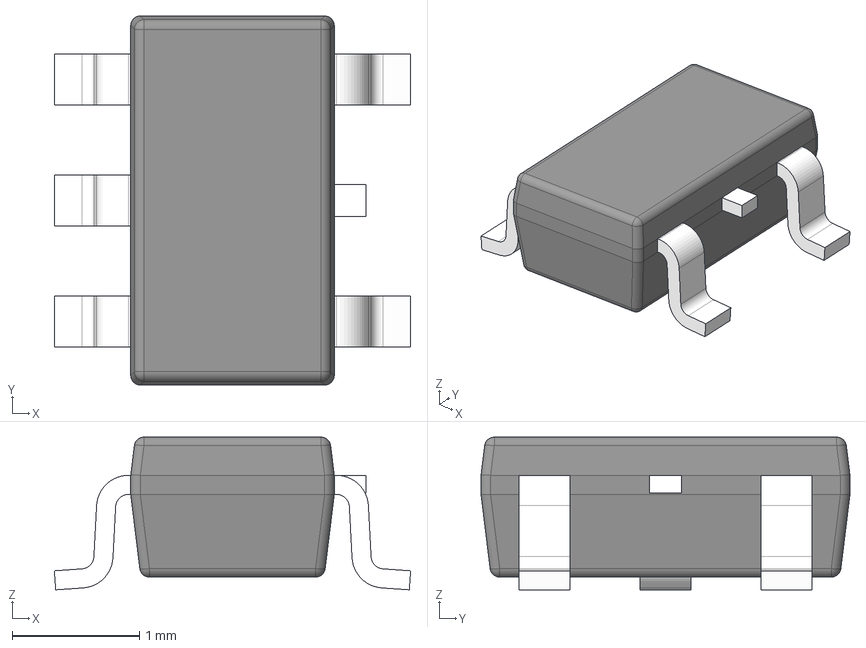
[picture p54: CAD file, 2025-04-15]
test_board/kicad-modules/shapes3d/DBV0005A.stp
2.80 x 2.90 x 1.20 mm
BODY-SOT
LEAD-SOT x 5
LEAD-DUMMY
