VerivoltDev/test_board/test_board/kicad-modules/shapes3d/EMI8142MUTAG.step

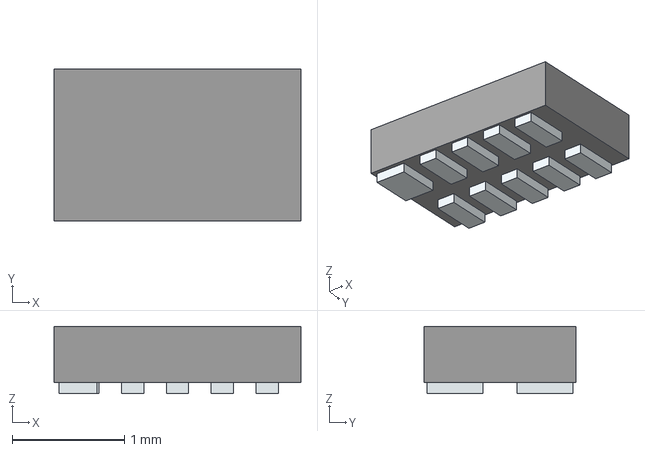
[picture p55: CAD file, 2025-04-15]
test_board/kicad-modules/shapes3d/EMI8142MUTAG.step
2.20 x 1.35 x 0.6 mm
Pins
