VerivoltDev/test_board/test_board/kicad-modules/shapes3d/pxc_1149611_00_01_CUC-SP-J1ST-S-R4LT-SMD_3D.stp

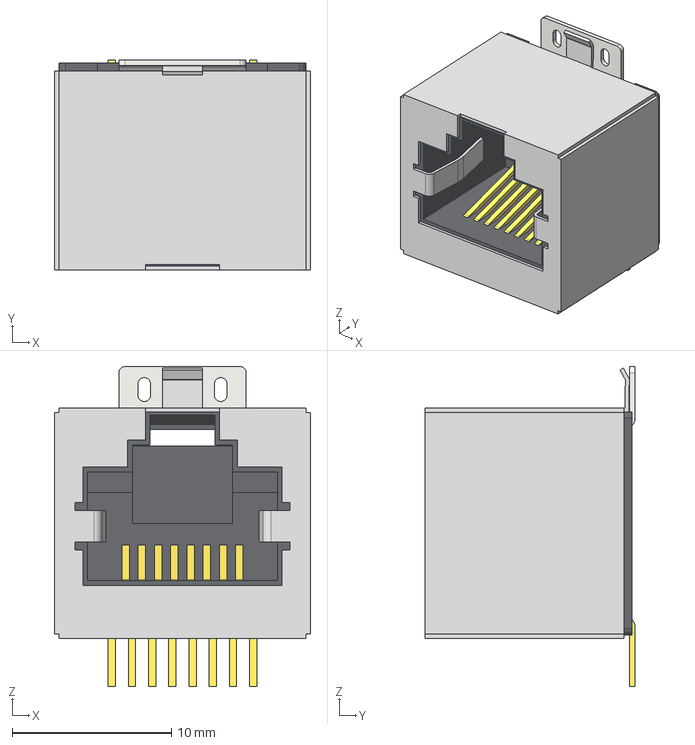
[picture p56: CAD file, 2025-04-15]
test_board/kicad-modules/shapes3d/pxc_1149611_00_01_CUC-SP-J1ST-S-R4LT-SMD_3D.stp
16.1 x 13.2 x 20.1 mm
