VerivoltDev/test_board/test_board/kicad-modules/shapes3d/pxc_1149871_00_00_CUC-SP-J1ST-S-R4LT-LED_3D.stp

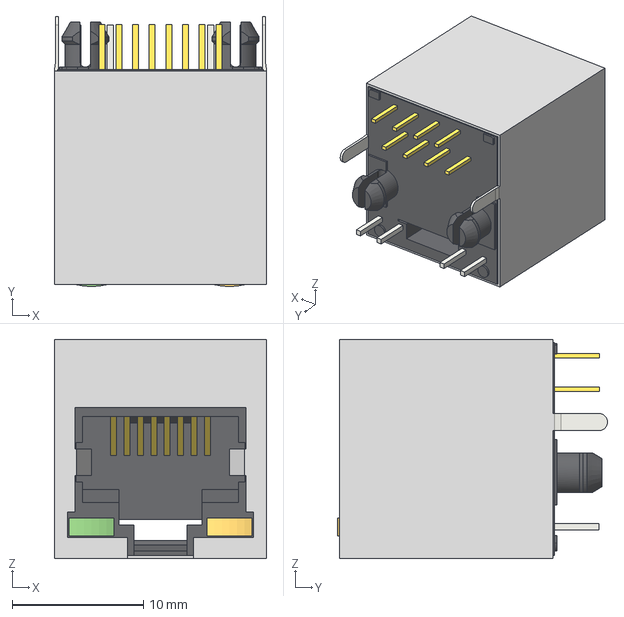
[picture p57: CAD file, 2025-04-15]
test_board/kicad-modules/shapes3d/pxc_1149871_00_00_CUC-SP-J1ST-S-R4LT-LED_3D.stp
16.2 x 20.6 x 16.7 mm
