VerivoltDev/test_board/test_board/kicad-modules/shapes3d/DFN6_2X2X0P5_STM.step

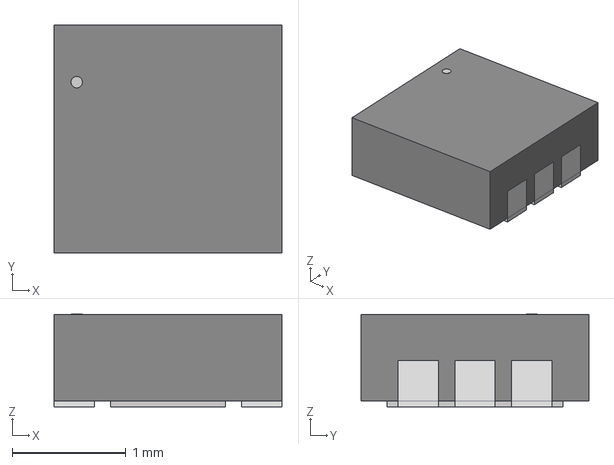
[picture p58: CAD file, 2025-04-15]
test_board/kicad-modules/shapes3d/DFN6_2X2X0P5_STM.step
2.01 x 2.01 x 0.815 mm
