VerivoltDev/test_board/test_board/kicad-modules/shapes3d/BM02B-SURS-TF_LF__SN_.stp

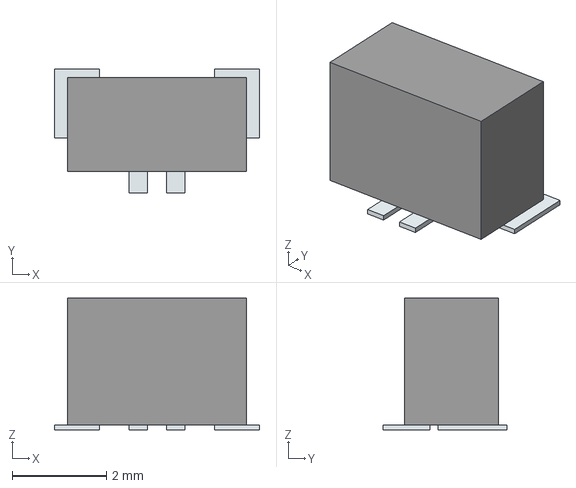
[picture p59: CAD file, 2025-04-15]
test_board/kicad-modules/shapes3d/BM02B-SURS-TF_LF__SN_.stp
4.36 x 2.63 x 2.80 mm
Pins
