VerivoltDev/test_board/test_board/kicad-modules/shapes3d/DHVQFN24_3P5X5P5_NEX.step

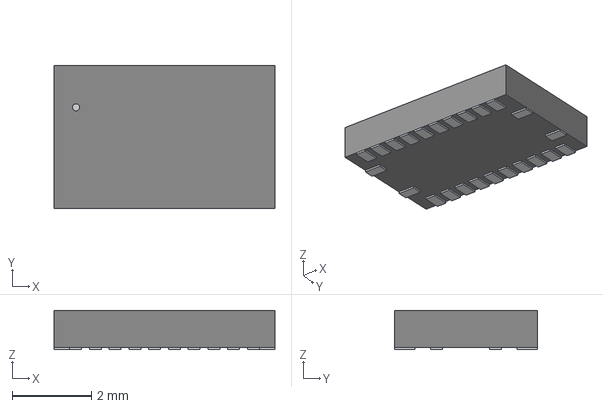
[picture p60: CAD file, 2025-04-15]
test_board/kicad-modules/shapes3d/DHVQFN24_3P5X5P5_NEX.step
5.59 x 3.61 x 0.993 mm
