VerivoltDev/test_board/test_board/kicad-modules/shapes3d/Q24.0-JXS32-8-10_15-T1-FU-WA-LF.stp

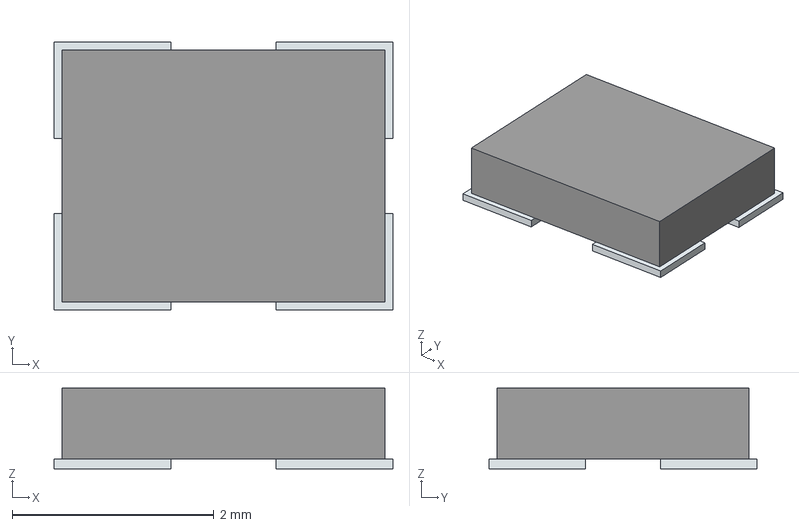
[picture p61: CAD file, 2025-04-15]
test_board/kicad-modules/shapes3d/Q24.0-JXS32-8-10_15-T1-FU-WA-LF.stp
3.36 x 2.66 x 0.8 mm
Pins
