VerivoltDev/test_board/test_board/kicad-modules/shapes3d/PCA9535RGER.step

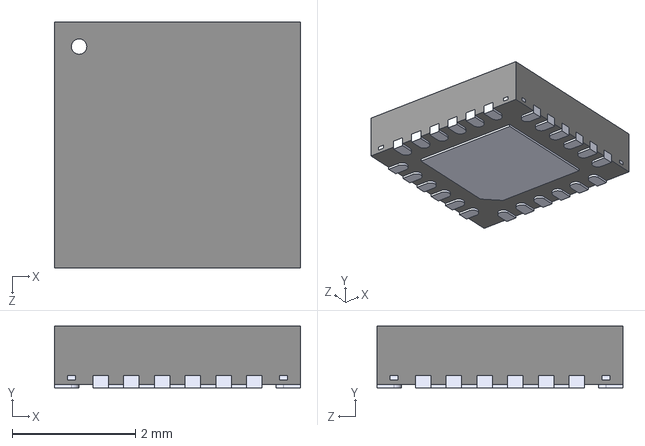
[picture p62: CAD file, 2025-04-15]
test_board/kicad-modules/shapes3d/PCA9535RGER.step
4.00 x 1.00 x 4.00 mm
