VerivoltDev/test_board/test_board/kicad-modules/shapes3d/RCT-0C.step

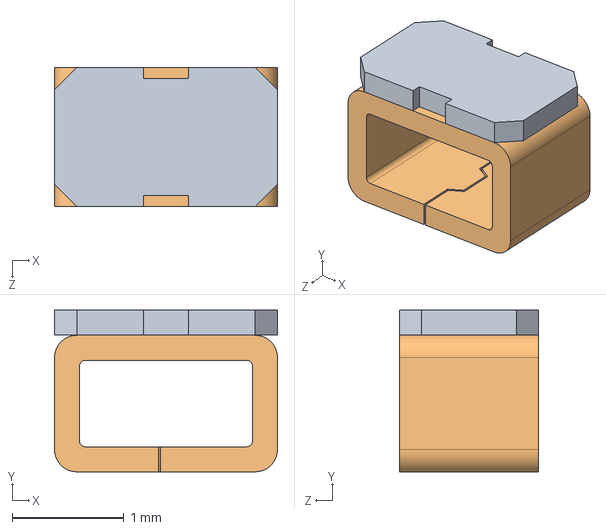
[picture p63: CAD file, 2025-04-15]
test_board/kicad-modules/shapes3d/RCT-0C.step
2.00 x 1.45 x 1.25 mm
