VerivoltDev/test_board/test_board/kicad-modules/shapes3d/SOT23-3-L_3P04X1P4X1P9_STM.step

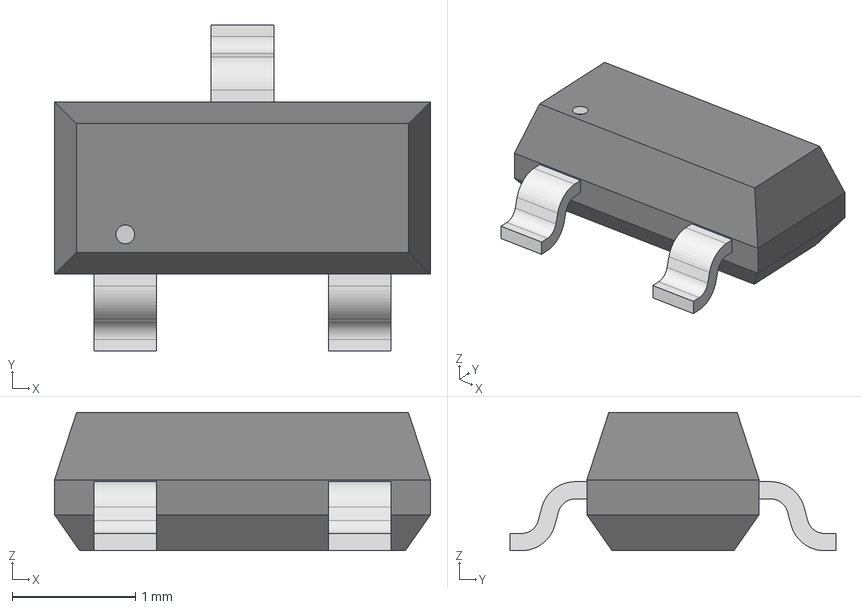
[picture p64: CAD file, 2025-04-15]
test_board/kicad-modules/shapes3d/SOT23-3-L_3P04X1P4X1P9_STM.step
3.05 x 2.64 x 1.12 mm
