VerivoltDev/test_board/test_board/kicad-modules/shapes3d/SMD4_ECS-3225MV_ECS.step

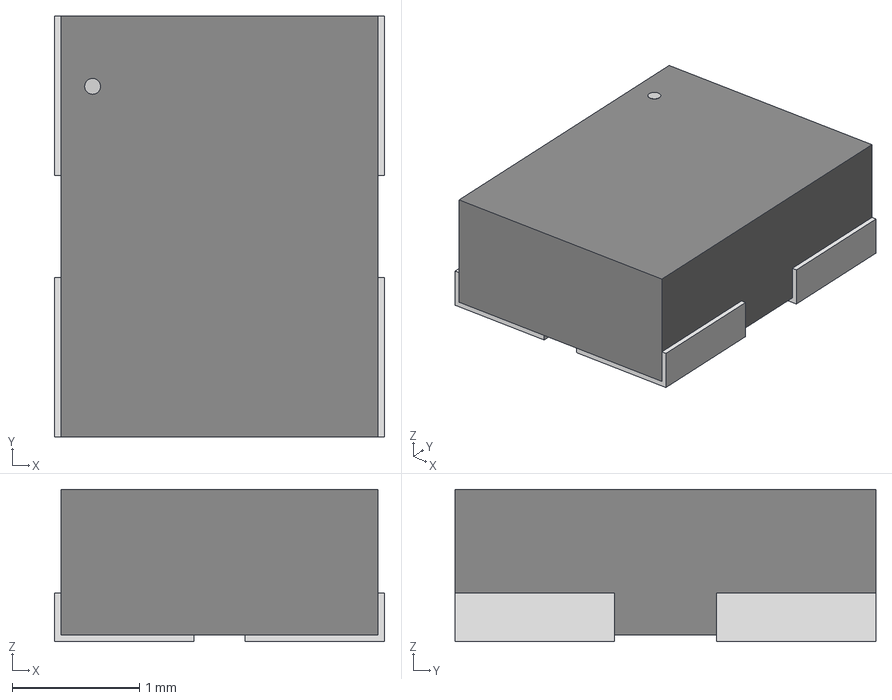
[picture p65: CAD file, 2025-04-15]
test_board/kicad-modules/shapes3d/SMD4_ECS-3225MV_ECS.step
2.59 x 3.30 x 1.20 mm
