VerivoltDev/test_board/test_board/kicad-modules/shapes3d/CS-4-12XTA.stp

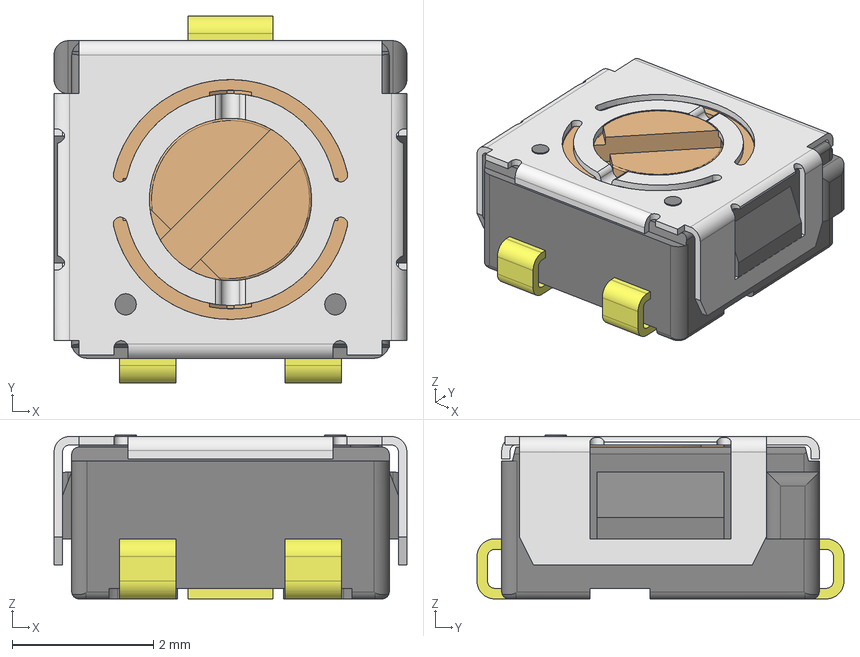
[picture p66: CAD file, 2025-04-15]
test_board/kicad-modules/shapes3d/CS-4-12XTA.stp
5.00 x 5.20 x 2.32 mm
CS-4-12XA1 Dial
CS-4-12XA Body
