VerivoltDev/test_board/test_board/kicad-modules/shapes3d/NV24M01MUW3VTBG.stp

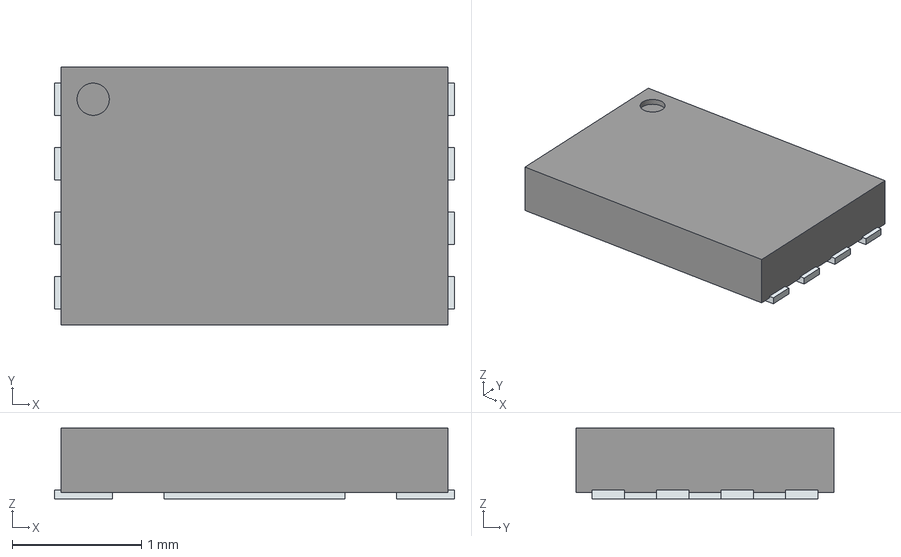
[picture p67: CAD file, 2025-04-15]
test_board/kicad-modules/shapes3d/NV24M01MUW3VTBG.stp
3.10 x 2.00 x 0.55 mm
ThermalPin
PinsArrayLR
