VerivoltDev/test_board/test_board/kicad-modules/shapes3d/SOIC16W.stp

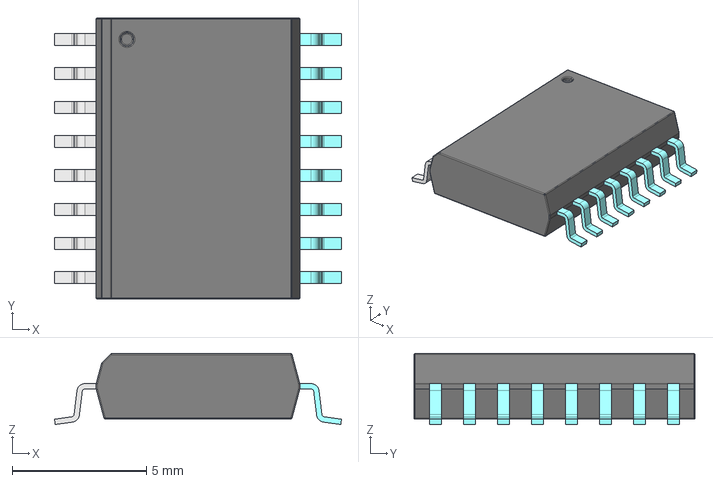
[picture p68: CAD file, 2025-04-15]
test_board/kicad-modules/shapes3d/SOIC16W.stp
10.7 x 10.5 x 2.65 mm
