VerivoltDev/test_board/test_board/kicad-modules/shapes3d/DG9422EDV-T1-GE3.stp

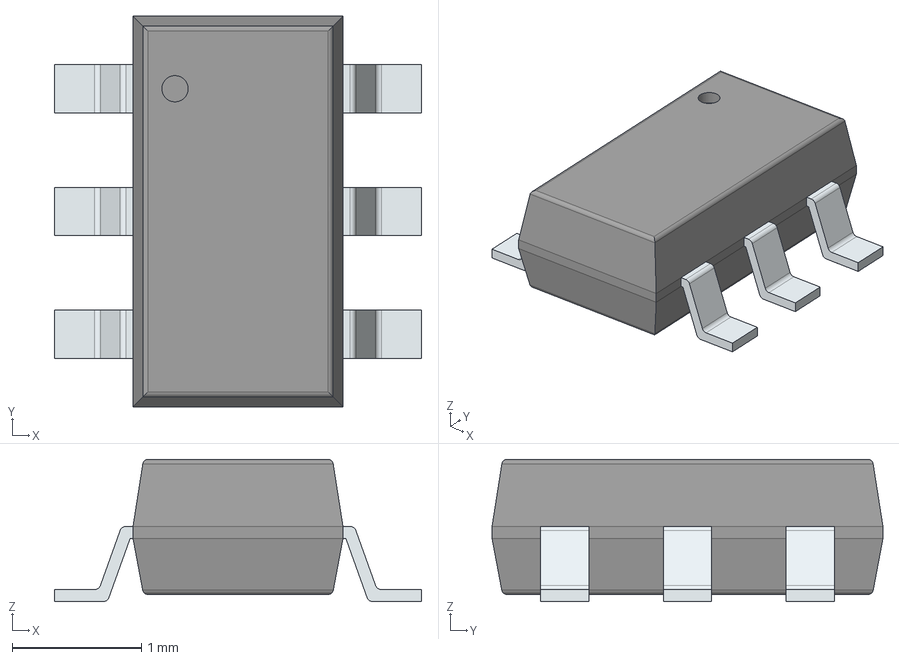
[picture p69: CAD file, 2025-04-15]
test_board/kicad-modules/shapes3d/DG9422EDV-T1-GE3.stp
2.84 x 3.02 x 1.10 mm
PinsArrayLR
