VerivoltDev/test_board/test_board/kicad-modules/shapes3d/SON4_CD-HD2004_BRN.step

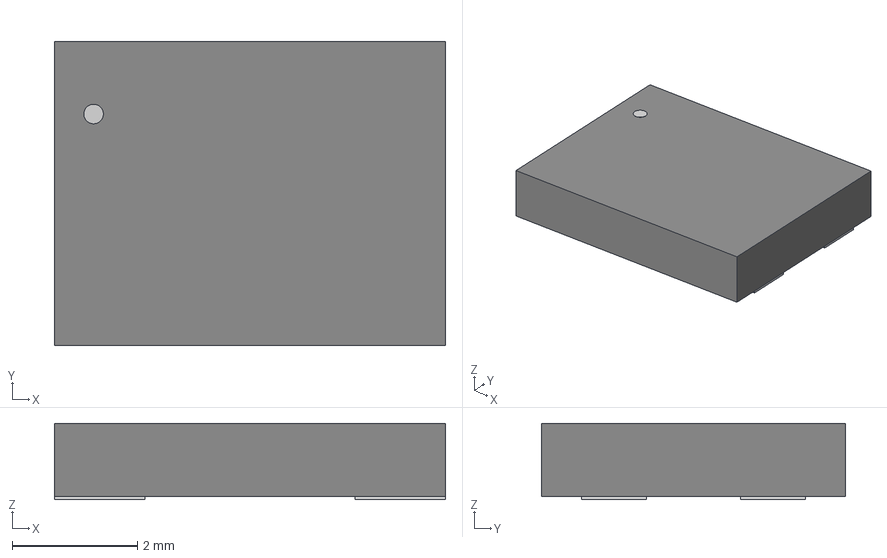
[picture p70: CAD file, 2025-04-15]
test_board/kicad-modules/shapes3d/SON4_CD-HD2004_BRN.step
6.25 x 4.85 x 1.22 mm
