VerivoltDev/test_board/test_board/kicad-modules/shapes3d/PCM-072_1565-1_heatsink_v1-0.step

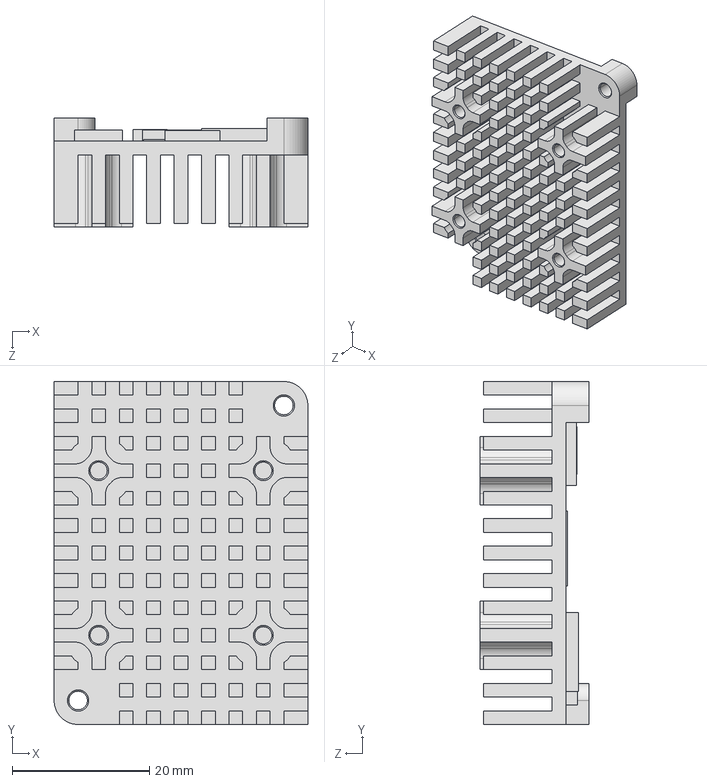
[picture p71: CAD file, 2025-04-15]
test_board/kicad-modules/shapes3d/PCM-072_1565-1_heatsink_v1-0.step
37.0 x 50.0 x 15.8 mm
