VerivoltDev/test_board/test_board/kicad-modules/shapes3d/BTH-070-02-L-D-A-TR.stp

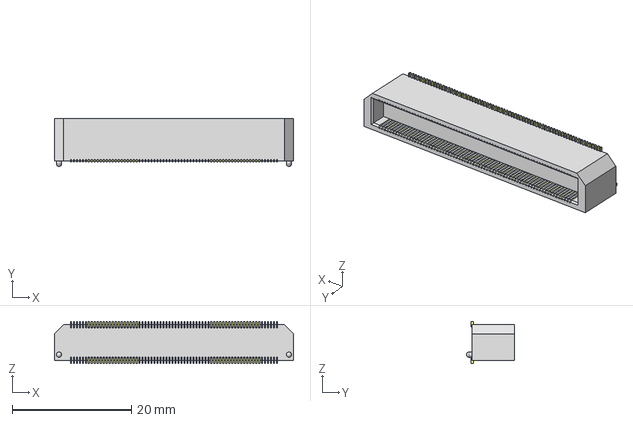
[picture p72: CAD file, 2025-04-15]
test_board/kicad-modules/shapes3d/BTH-070-02-L-D-A-TR.stp
40.0 x 8.02 x 7.11 mm
T-1S59-02-070
BTH-070-02-D-A_terminal
