VerivoltDev/test_board/test_board/kicad-modules/shapes3d/CAP_A750-MV_KEM.step

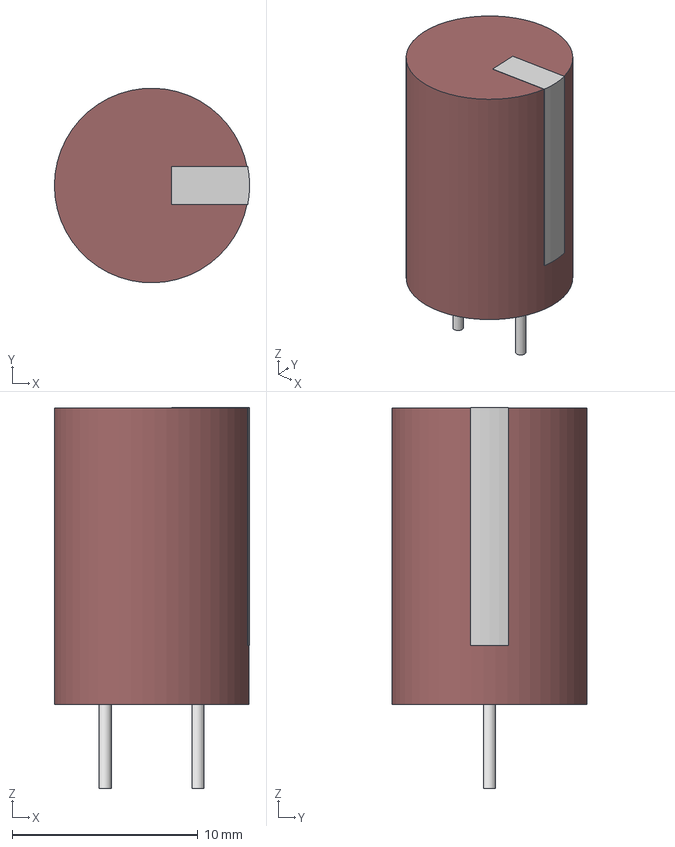
[picture p73: CAD file, 2025-04-15]
test_board/kicad-modules/shapes3d/CAP_A750-MV_KEM.step
10.5 x 10.5 x 20.5 mm
