VerivoltDev/test_board/test_board/kicad-modules/shapes3d/IND_7332_WE-PD_SHIELDED_SMT_WRE.step

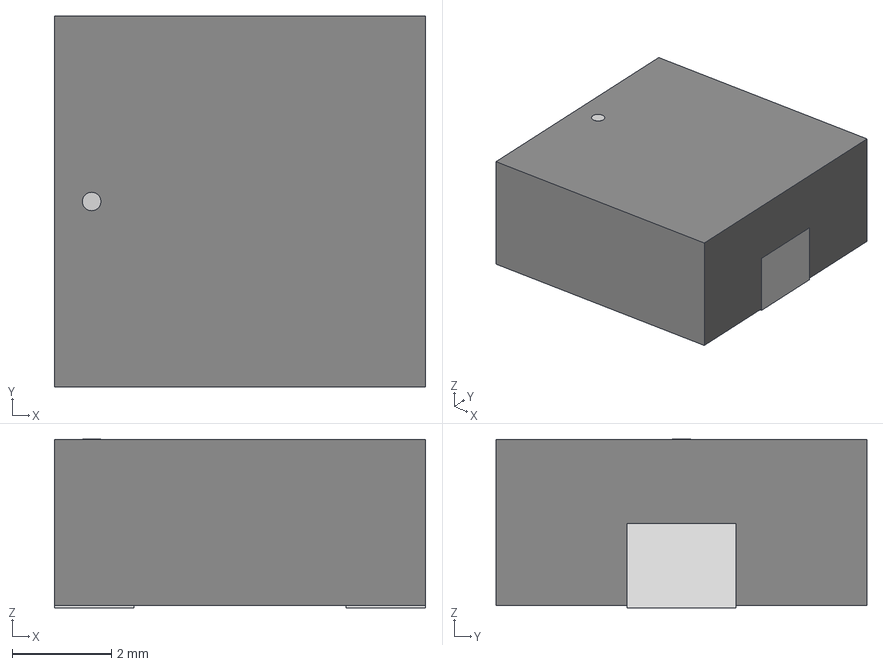
[picture p74: CAD file, 2025-04-15]
test_board/kicad-modules/shapes3d/IND_7332_WE-PD_SHIELDED_SMT_WRE.step
7.49 x 7.49 x 3.41 mm
