VerivoltDev/test_board/test_board/kicad-modules/shapes3d/QTH-060-04-X-D-DP-A.step

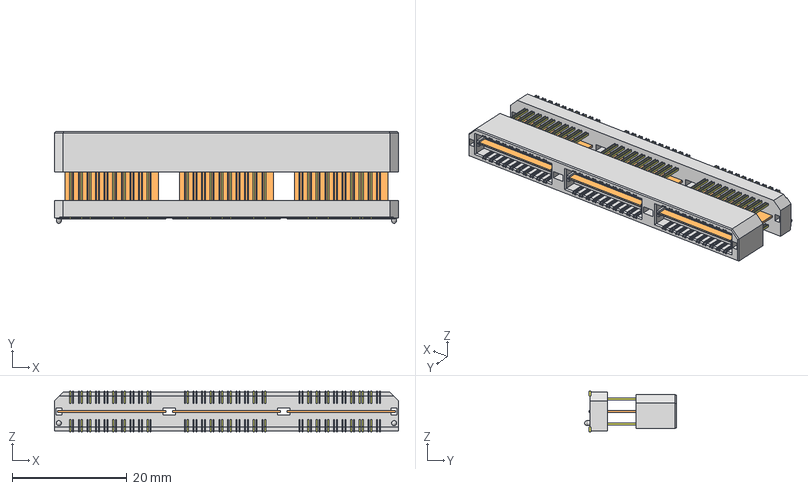
[picture p75: CAD file, 2025-04-15]
test_board/kicad-modules/shapes3d/QTH-060-04-X-D-DP-A.step
60.0 x 16.0 x 7.11 mm
LTQTH-060-04-L-D-DP-A_lower_terminal
T-1G1-04_imp x 3
T-1S60-04(-060-04-D-DP)_pin x 3
TQTH-060-04-L-D-DP-A_terminal
