VerivoltDev/test_board/test_board/kicad-modules/shapes3d/PW0008A.stp

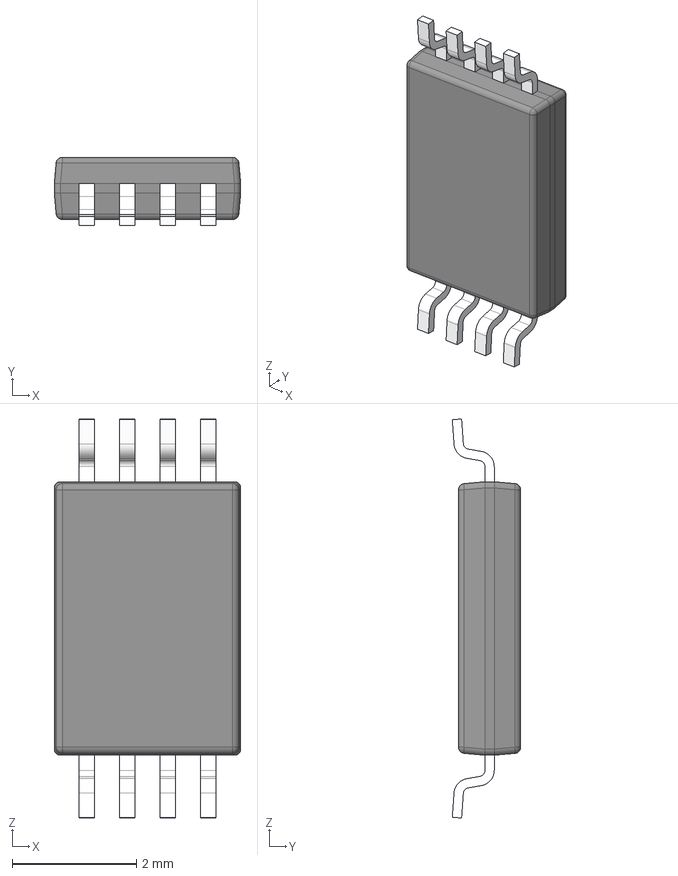
[picture p76: CAD file, 2025-04-15]
test_board/kicad-modules/shapes3d/PW0008A.stp
3.00 x 1.10 x 6.42 mm
BODY-SO
LEAD-SO x 8
PIN1-ID
