VerivoltDev/test_board/test_board/kicad-modules/shapes3d/RGC0064G.stp

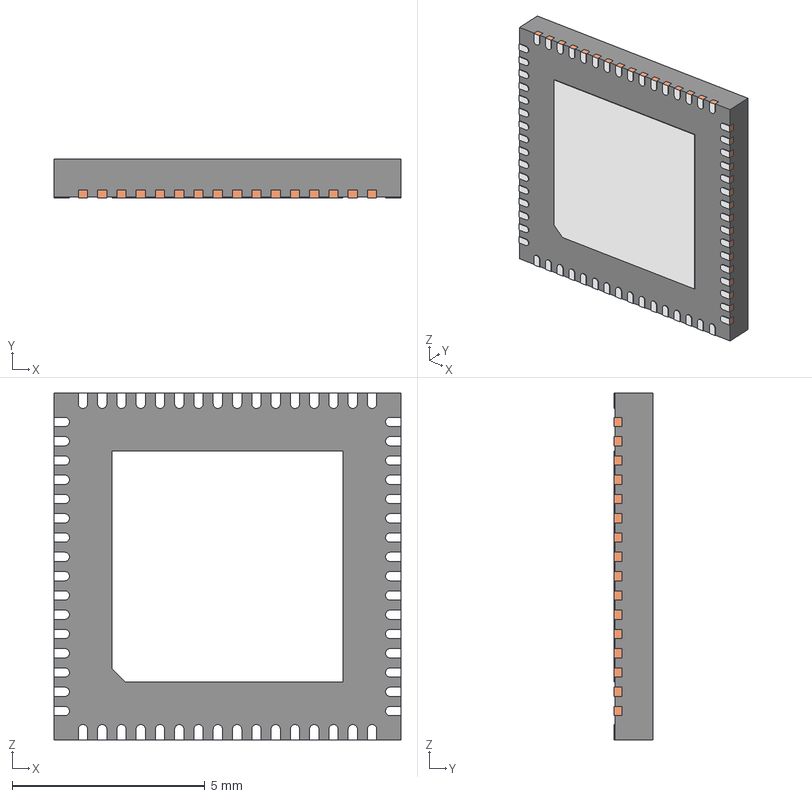
[picture p77: CAD file, 2025-04-15]
test_board/kicad-modules/shapes3d/RGC0064G.stp
9.00 x 1.00 x 9.00 mm
BODY-QFN
FRAME-AAA00XXA
PIN1-ID
