VerivoltDev/test_board/test_board/kicad-modules/shapes3d/1206SFF800F&slash_24-2.step

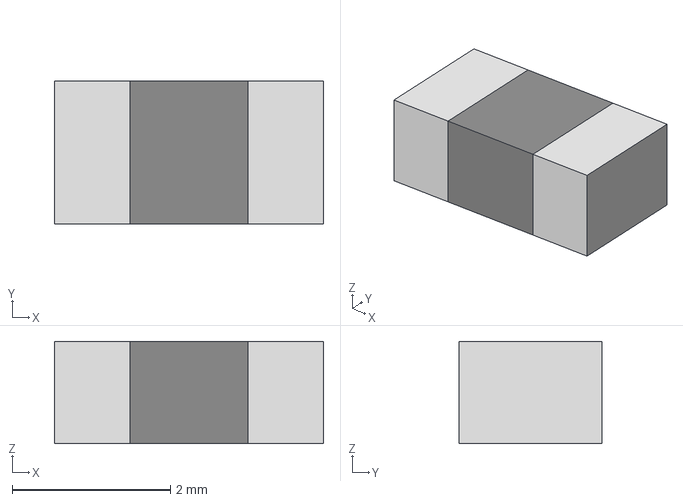
[picture p78: CAD file, 2025-04-15]
test_board/kicad-modules/shapes3d/1206SFF800F&slash_24-2.step
3.40 x 1.80 x 1.29 mm
