VerivoltDev/test_board/test_board/kicad-modules/shapes3d/SOIC8_DDA_TEX.step

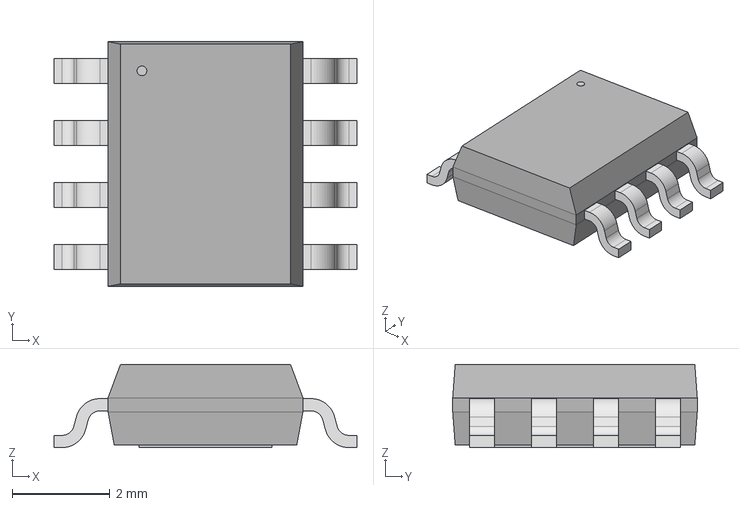
[picture p79: CAD file, 2025-04-15]
test_board/kicad-modules/shapes3d/SOIC8_DDA_TEX.step
6.20 x 5.00 x 1.70 mm
