VerivoltDev/test_board/test_board/kicad-modules/shapes3d/DIODE_DO214AA_SMBJ26CA.step

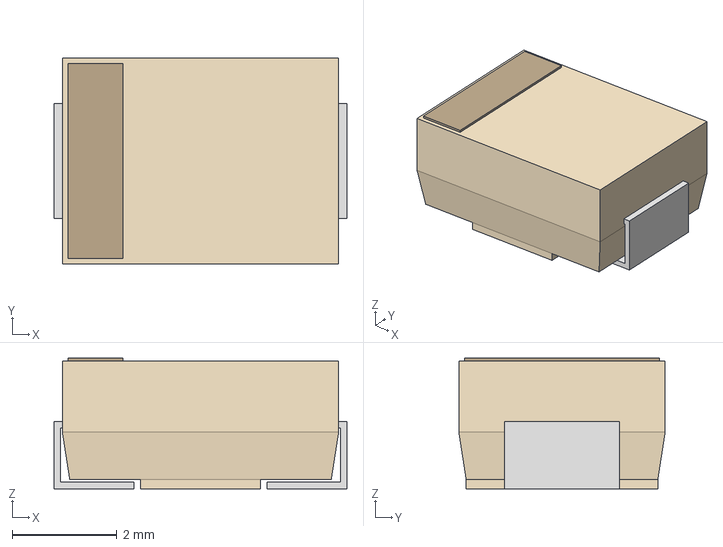
[picture p80: CAD file, 2025-04-15]
test_board/kicad-modules/shapes3d/DIODE_DO214AA_SMBJ26CA.step
5.59 x 3.94 x 2.49 mm
