VerivoltDev/test_board/test_board/kicad-modules/shapes3d/HD3SS3212IRKSR.stp

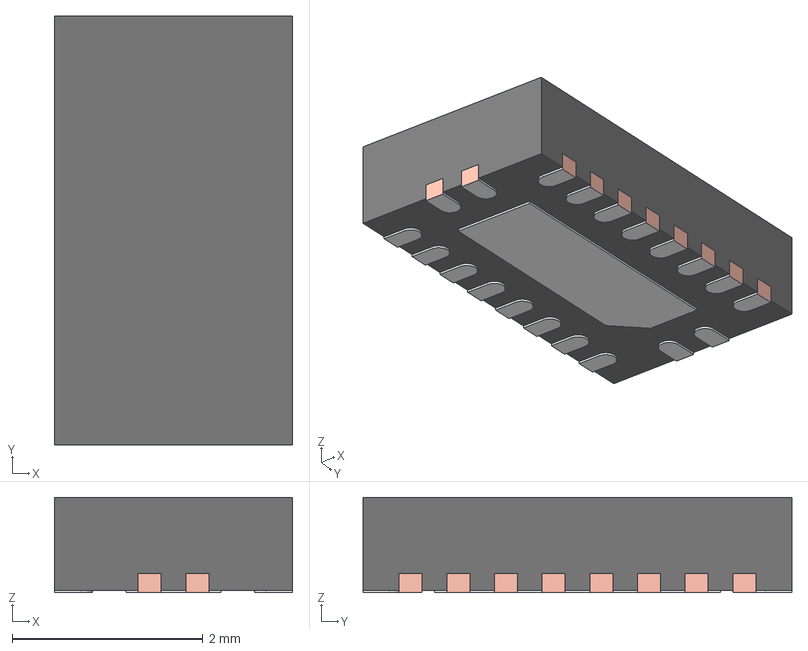
[picture p81: CAD file, 2025-04-15]
test_board/kicad-modules/shapes3d/HD3SS3212IRKSR.stp
2.50 x 4.50 x 1.00 mm
BODY-QFN
FRAME-RKS0020A
PIN1-ID
