VerivoltDev/test_board/test_board/kicad-modules/shapes3d/EDS224Z3R6H.stp

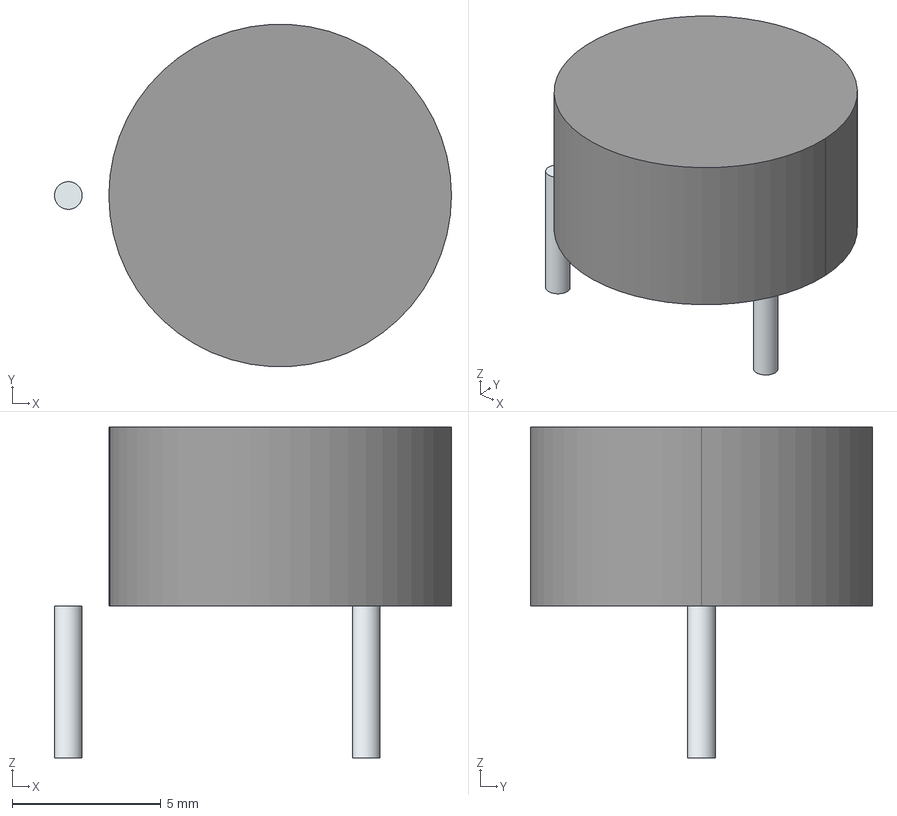
[picture p82: CAD file, 2025-04-15]
test_board/kicad-modules/shapes3d/EDS224Z3R6H.stp
13.3 x 11.5 x 11.1 mm
Leads x 2
