VerivoltDev/test_board/test_board/kicad-modules/shapes3d/conn_sd_47219-2001.step

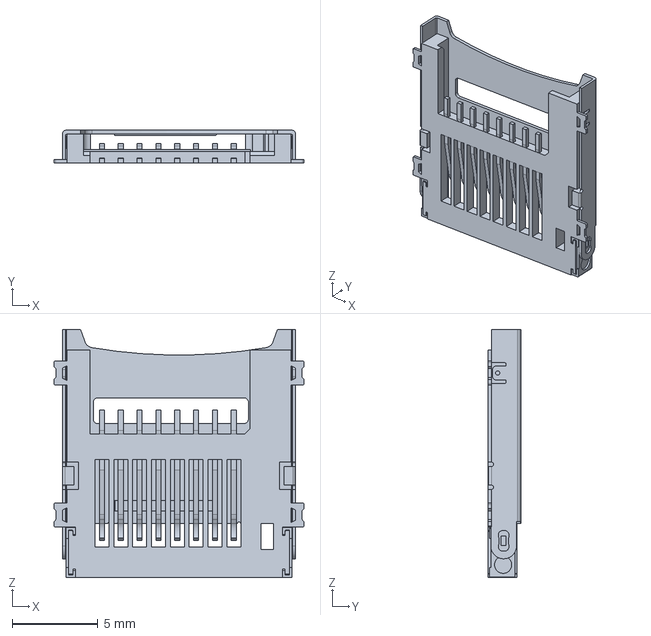
[picture p83: CAD file, 2025-04-15]
test_board/kicad-modules/shapes3d/conn_sd_47219-2001.step
14.6 x 1.90 x 14.5 mm
