VerivoltDev/test_board/test_board/kicad-modules/shapes3d/TDN_5-2419WI.step

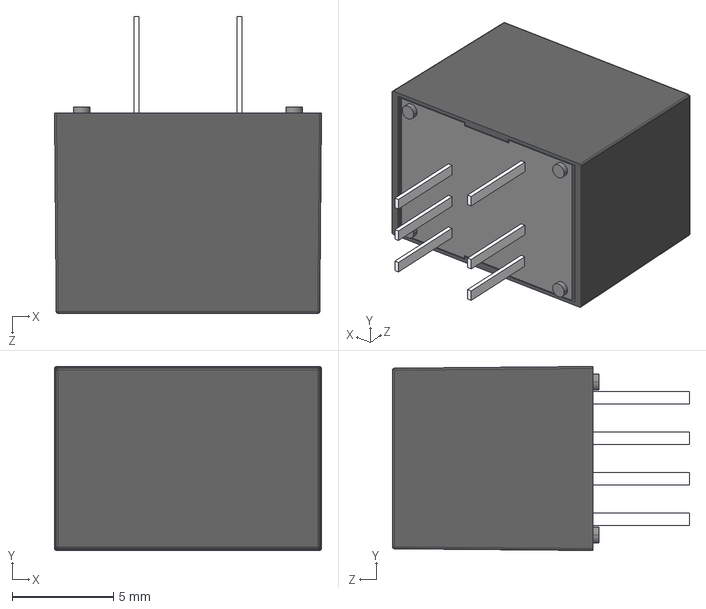
[picture p84: CAD file, 2025-04-15]
test_board/kicad-modules/shapes3d/TDN_5-2419WI.step
13.2 x 9.10 x 14.7 mm
