VerivoltDev/test_board/test_board/kicad-modules/shapes3d/USON8_3X2X0_45_GDV.step

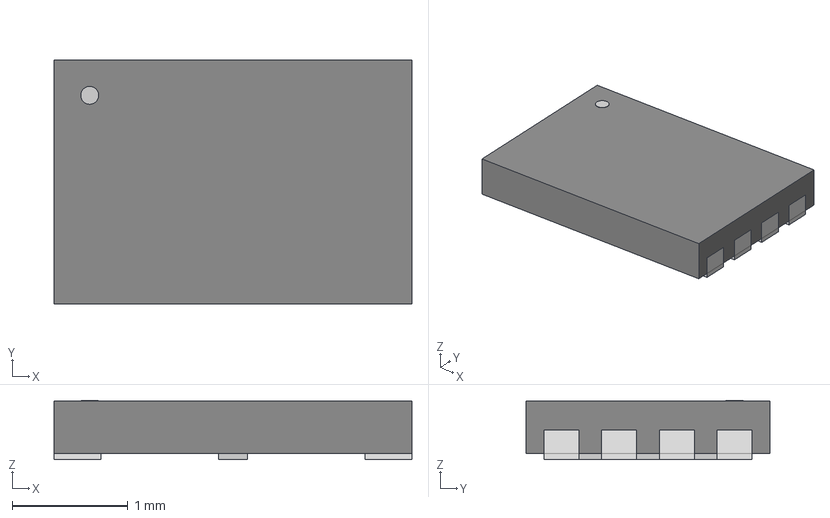
[picture p85: CAD file, 2025-04-15]
test_board/kicad-modules/shapes3d/USON8_3X2X0_45_GDV.step
3.10 x 2.11 x 0.511 mm
