VerivoltDev/test_board/test_board/kicad-modules/shapes3d/WE_Inductor_4020.STEP

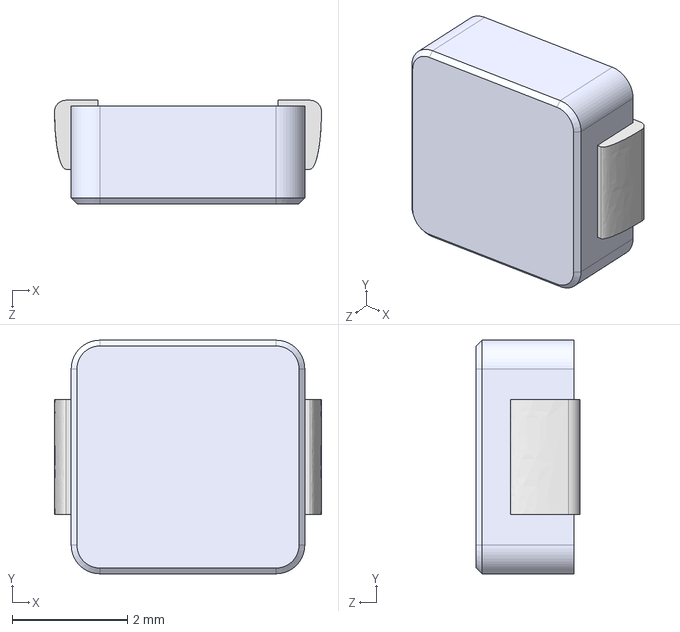
[picture p86: CAD file, 2025-04-15]
test_board/kicad-modules/shapes3d/WE_Inductor_4020.STEP
4.64 x 4.06 x 1.80 mm
