VerivoltDev/test_board/test_board/kicad-modules/shapes3d/VLP-600-R.IGS

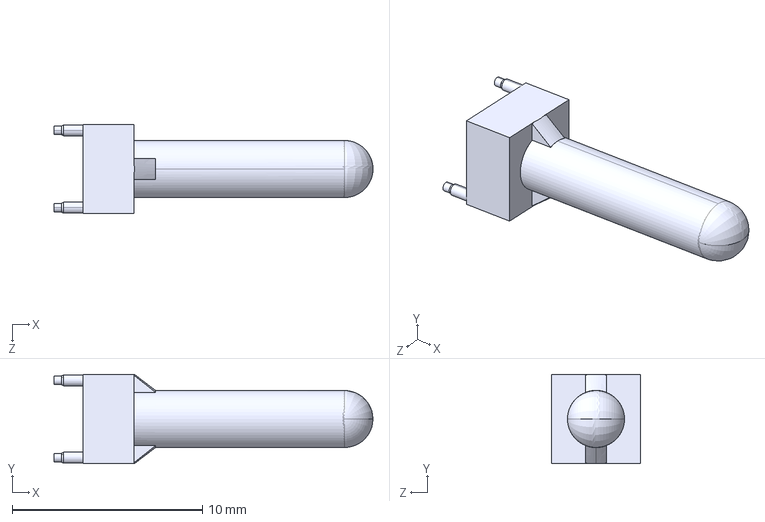
[picture p87: CAD file, 2025-04-15]
test_board/kicad-modules/shapes3d/VLP-600-R.IGS
16.8 x 4.70 x 4.70 mm
