VerivoltDev/test_board/test_board/kicad-modules/shapes3d/ZSS-112-02-L-D-540.stp

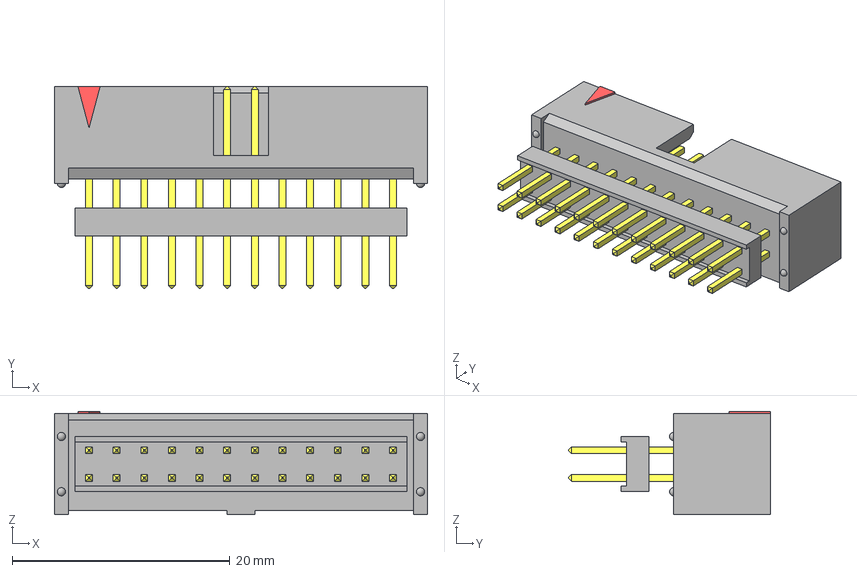
[picture p88: CAD file, 2025-04-15]
test_board/kicad-modules/shapes3d/ZSS-112-02-L-D-540.stp
34.3 x 18.5 x 9.47 mm
ZSS-112--D_indicator
ZSS-112-02-L-D-540_bsocket
ZSS-112-02-L-D-540_pins
ZSS-112-02-L-D-540_socket
