VerivoltDev/test_board/test_board/kicad-modules/shapes3d/MDT420E03001--3DModel-STEP-269445.STEP

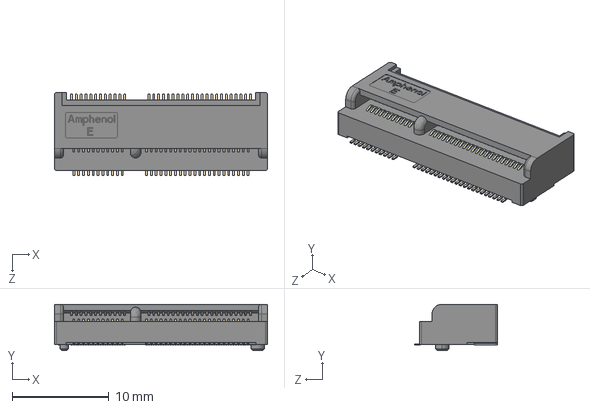
[picture p89: CAD file, 2025-04-15]
test_board/kicad-modules/shapes3d/MDT420E03001--3DModel-STEP-269445.STEP
22.0 x 4.80 x 8.55 mm
