VerivoltDev/test_board/test_board/kicad-modules/shapes3d/NCP1096PAR2G.stp

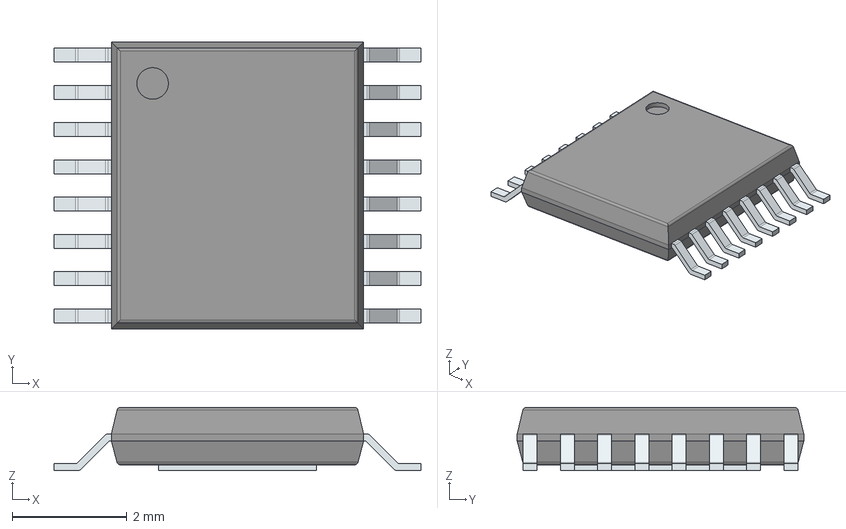
[picture p90: CAD file, 2025-04-15]
test_board/kicad-modules/shapes3d/NCP1096PAR2G.stp
6.40 x 5.00 x 1.10 mm
PinsArrayLR
ThermalPad
