VerivoltDev/test_board/test_board/kicad-modules/shapes3d/2601-1103.stp

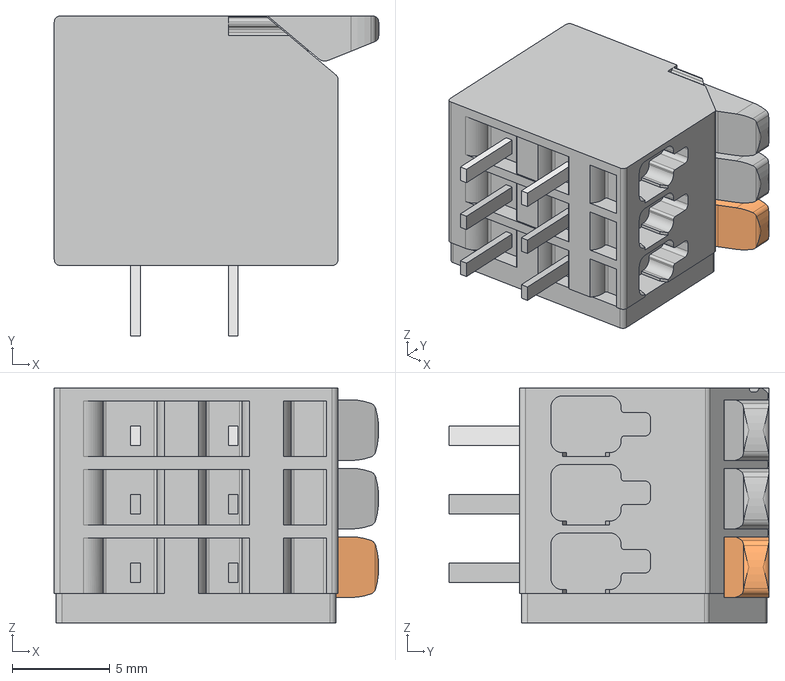
[picture p91: CAD file, 2025-04-15]
test_board/kicad-modules/shapes3d/2601-1103.stp
16.6 x 16.4 x 12.0 mm
