VerivoltDev/test_board/test_board/kicad-modules/shapes3d/QSH-060-01-L-D-DP-A-K-TR.stp

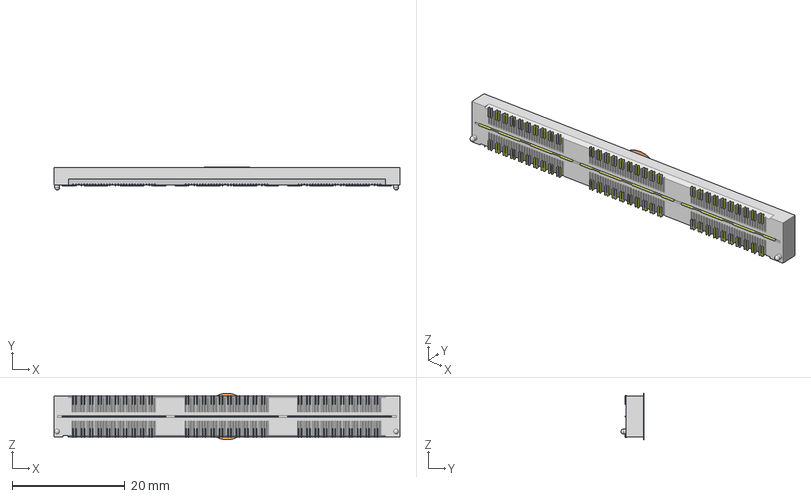
[picture p92: CAD file, 2025-04-15]
test_board/kicad-modules/shapes3d/QSH-060-01-L-D-DP-A-K-TR.stp
61.4 x 4.13 x 8.25 mm
QSHpolyimide_film
C-126-21-060-D-DP x 3
T-1G2-01-060 x 3
TQSH-060-01-D-DP-A_terminal
