VerivoltDev/test_board/test_board/kicad-modules/shapes3d/SOD123_DIO.step

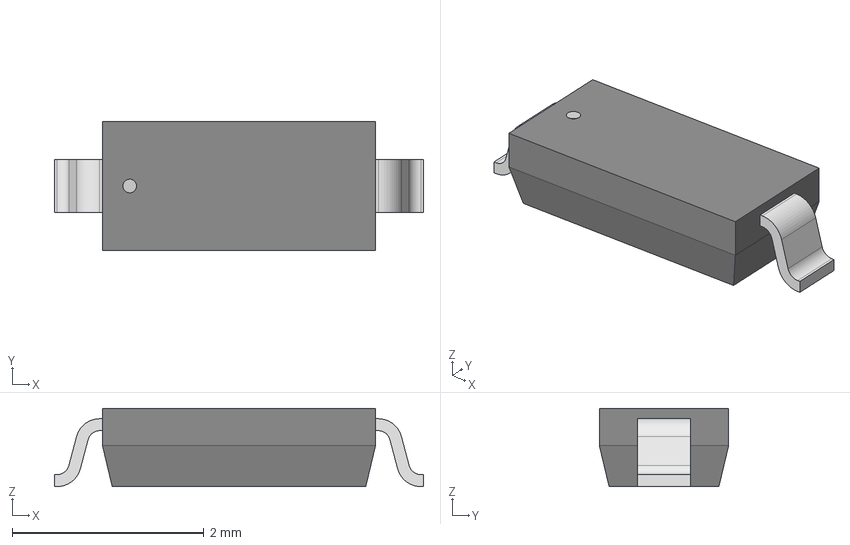
[picture p93: CAD file, 2025-04-15]
test_board/kicad-modules/shapes3d/SOD123_DIO.step
3.85 x 1.35 x 0.815 mm
