VerivoltDev/test_board/test_board/kicad-modules/shapes3d/TLV803EB42VDBZR.stp

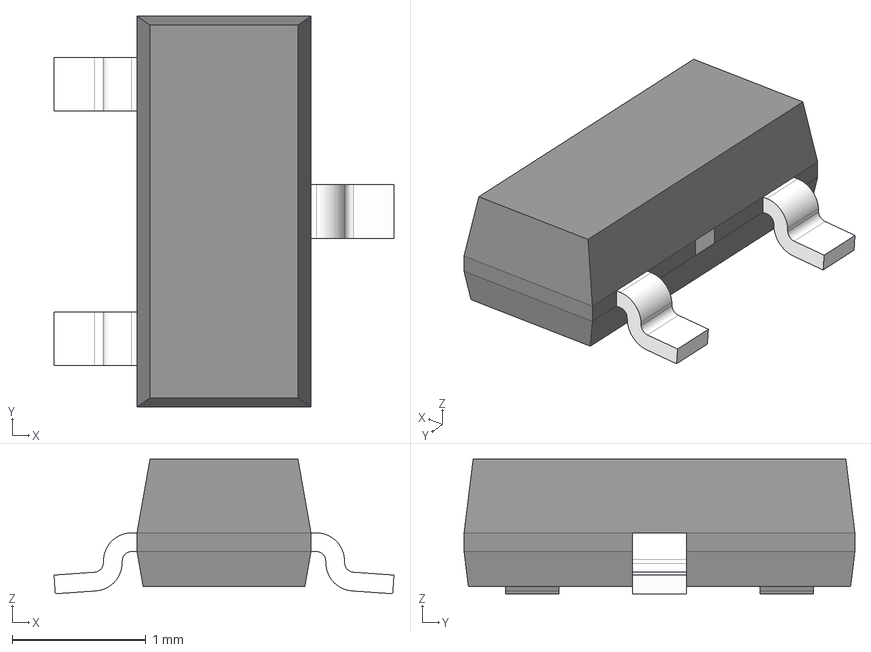
[picture p94: CAD file, 2025-04-15]
test_board/kicad-modules/shapes3d/TLV803EB42VDBZR.stp
2.54 x 2.92 x 1.01 mm
BODY-SOT
LEAD-SOT x 3
PIN1-ID
TIEBAR
