VerivoltDev/test_board/test_board/kicad-modules/shapes3d/SMBJ36A.STEP

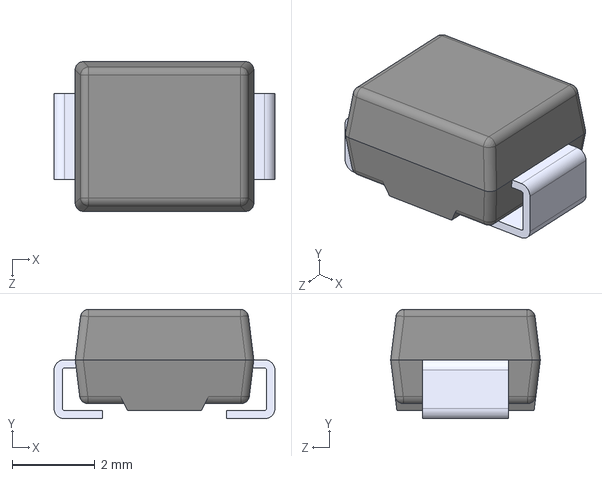
[picture p95: CAD file, 2025-04-15]
test_board/kicad-modules/shapes3d/SMBJ36A.STEP
5.35 x 2.65 x 3.63 mm
