VerivoltDev/test_board/test_board/kicad-modules/shapes3d/USB-C_UJ40-C-V-G-SMT-TR.step

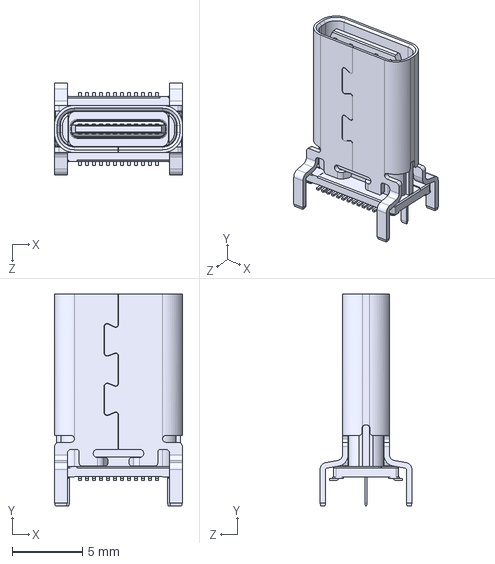
[picture p96: CAD file, 2025-04-15]
test_board/kicad-modules/shapes3d/USB-C_UJ40-C-V-G-SMT-TR.step
9.15 x 15.1 x 6.54 mm
