VerivoltDev/test_board/test_board/kicad-modules/shapes3d/MURATA_MYBSP0122BABFT.step

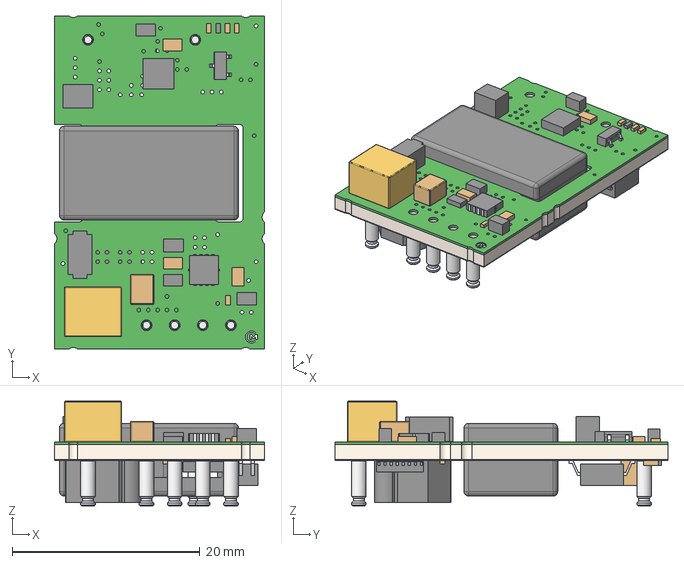
[picture p97: CAD file, 2025-04-15]
test_board/kicad-modules/shapes3d/MURATA_MYBSP0122BABFT.step
22.4 x 35.5 x 11.1 mm
