VerivoltDev/test_board/test_board/kicad-modules/shapes3d/SOT23-5_STM_TS391ILT.step

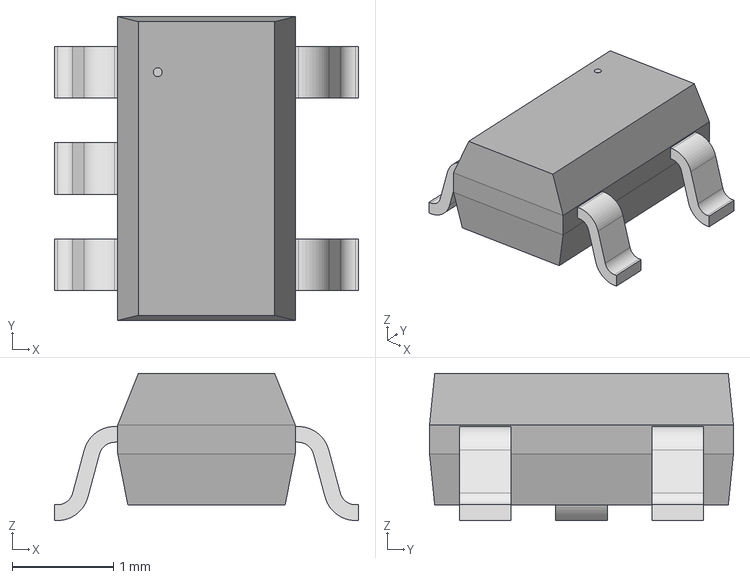
[picture p98: CAD file, 2025-04-15]
test_board/kicad-modules/shapes3d/SOT23-5_STM_TS391ILT.step
3.00 x 3.00 x 1.45 mm
