VerivoltDev/test_board/test_board/kicad-modules/shapes3d/c-5499206-5-c-3d.stp

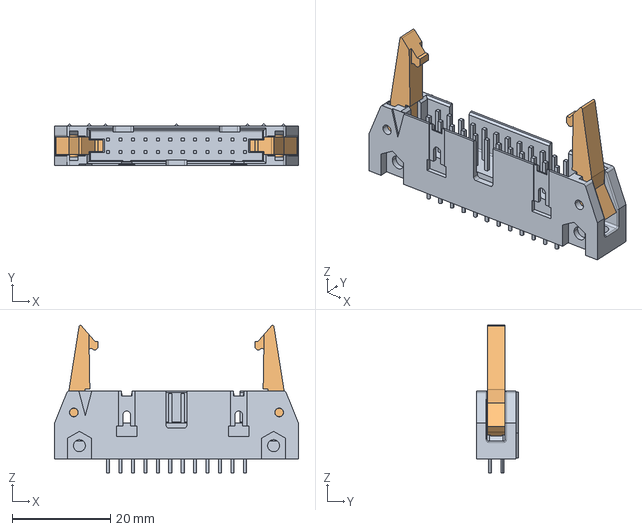
[picture p99: CAD file, 2025-04-15]
test_board/kicad-modules/shapes3d/c-5499206-5-c-3d.stp
49.8 x 8.53 x 30.1 mm
