VerivoltDev/test_board/test_board/kicad-modules/shapes3d/EXB-2HV103JV.step

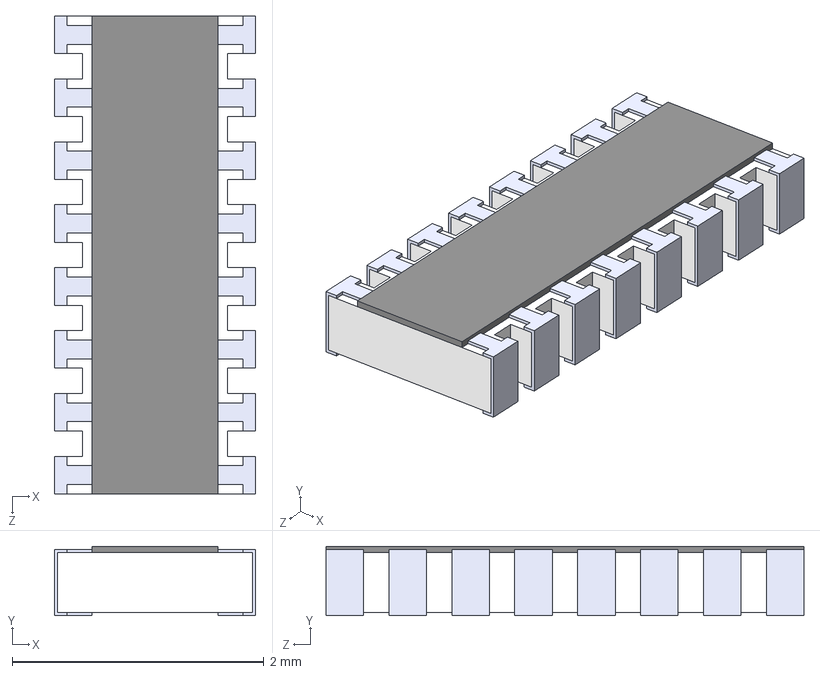
[picture p100: CAD file, 2025-04-15]
test_board/kicad-modules/shapes3d/EXB-2HV103JV.step
1.60 x 0.55 x 3.80 mm
