VerivoltDev/test_board/test_board/kicad-modules/shapes3d/LMK1C1103PWR.STEP

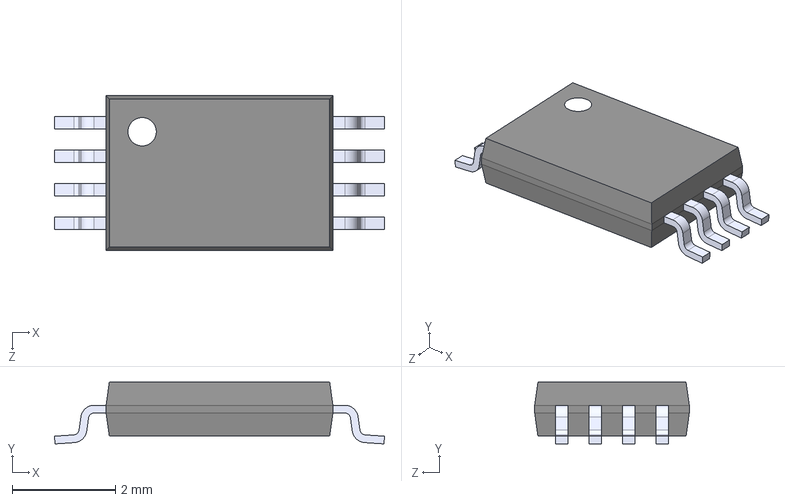
[picture p101: CAD file, 2025-04-15]
test_board/kicad-modules/shapes3d/LMK1C1103PWR.STEP
6.40 x 1.20 x 3.00 mm
