VerivoltDev/test_board/test_board/kicad-modules/shapes3d/alt4532m-201.step

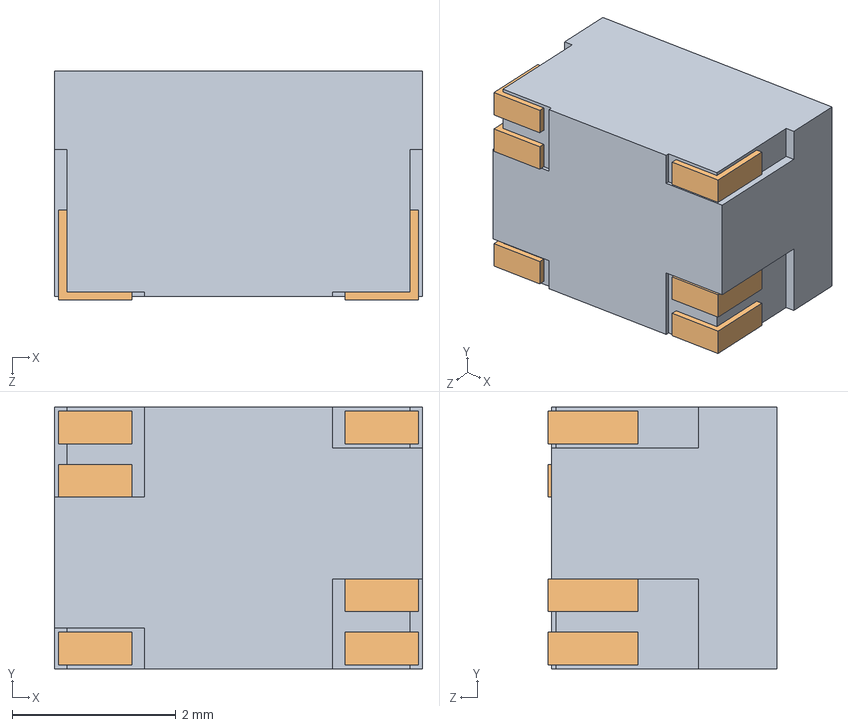
[picture p102: CAD file, 2025-04-15]
test_board/kicad-modules/shapes3d/alt4532m-201.step
4.50 x 3.20 x 2.80 mm
ALT4532M-201 DRコアブロック(typ size)
ALT4532M-201 端子ブロック(typ size) x 6
