VerivoltDev/test_board/test_board/kicad-modules/shapes3d/QFN-64_MCL.step

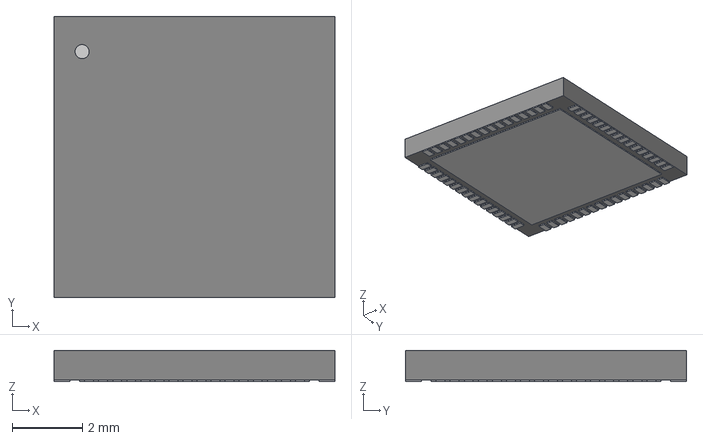
[picture p103: CAD file, 2025-04-15]
test_board/kicad-modules/shapes3d/QFN-64_MCL.step
8.00 x 8.00 x 0.892 mm
