VerivoltDev/test_board/test_board/kicad-modules/shapes3d/IND_BLM18_0603_MUR.step

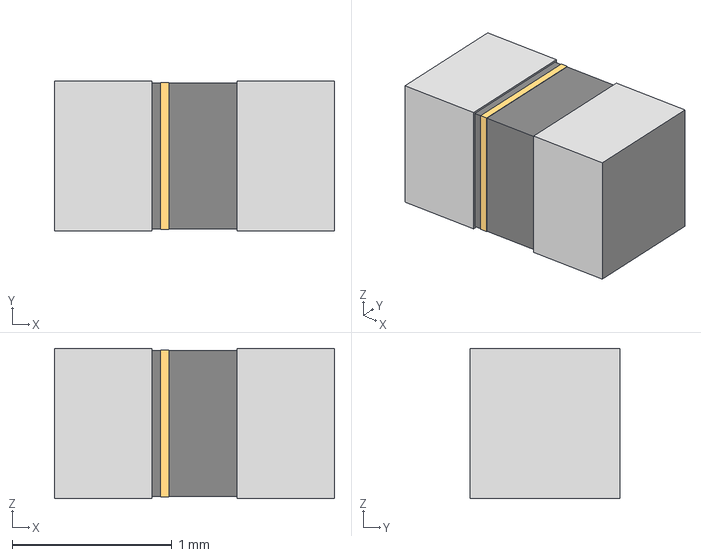
[picture p104: CAD file, 2025-04-15]
test_board/kicad-modules/shapes3d/IND_BLM18_0603_MUR.step
1.75 x 0.94 x 0.94 mm
