VerivoltDev/test_board/test_board/kicad-modules/shapes3d/DRB0008A.stp

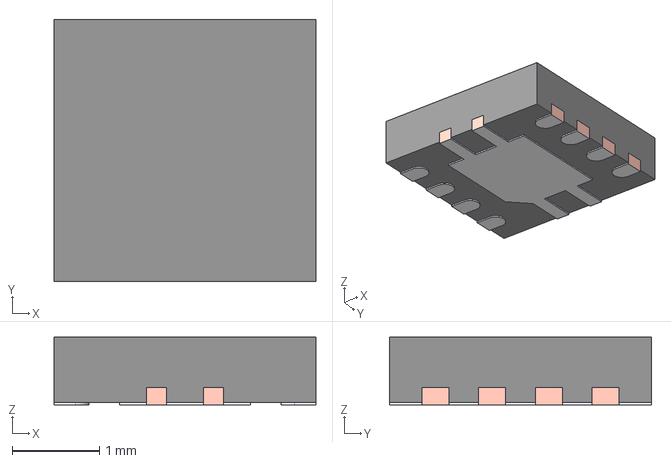
[picture p105: CAD file, 2025-04-15]
test_board/kicad-modules/shapes3d/DRB0008A.stp
3.00 x 3.00 x 0.775 mm
BODY-SON
FRAME-DRB0008A
