VerivoltDev/test_board/test_board/kicad-modules/shapes3d/MSOP8_MC_MCH.step

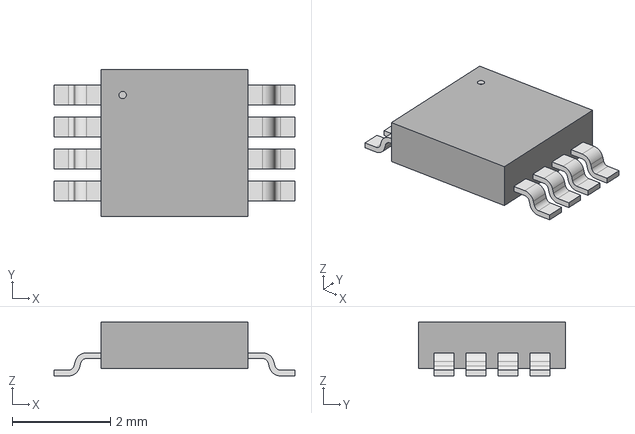
[picture p107: CAD file, 2025-04-15]
test_board/kicad-modules/shapes3d/MSOP8_MC_MCH.step
4.90 x 3.00 x 1.09 mm
