VerivoltDev/test_board/test_board/kicad-modules/shapes3d/PWP0016G.stp

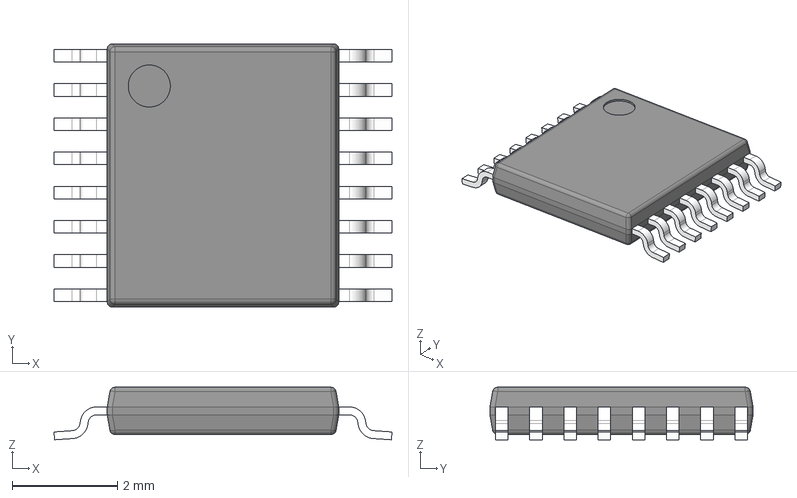
[picture p108: CAD file, 2025-04-15]
test_board/kicad-modules/shapes3d/PWP0016G.stp
6.42 x 5.00 x 1.00 mm
BODY-SO
LEAD-SO x 16
THERMALPAD-SO
