VerivoltDev/test_board/test_board/kicad-modules/shapes3d/Coilcraft-LPD8035V.STEP

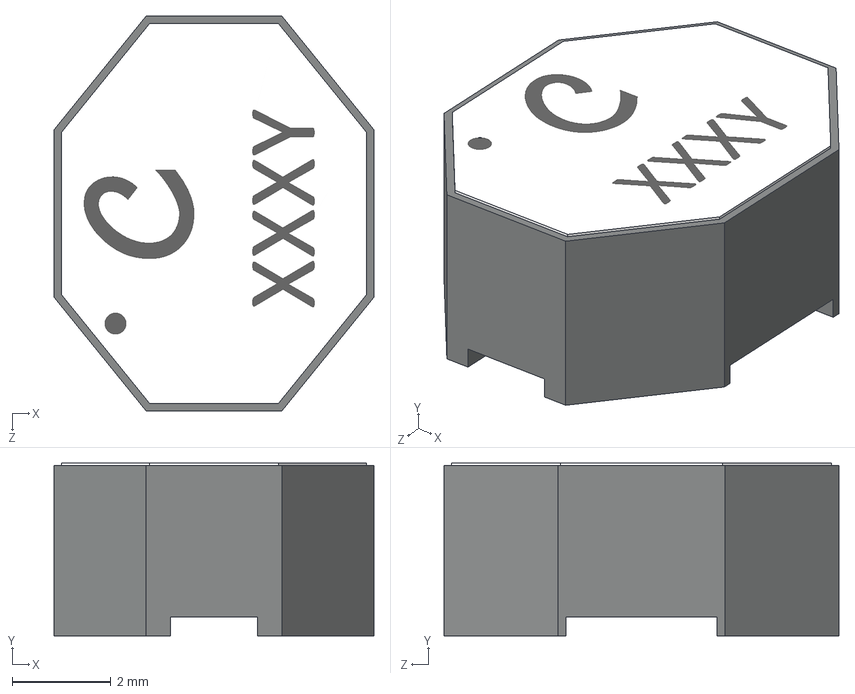
[picture p109: CAD file, 2025-04-15]
test_board/kicad-modules/shapes3d/Coilcraft-LPD8035V.STEP
6.48 x 3.50 x 8.00 mm
