VerivoltDev/test_board/test_board/kicad-modules/shapes3d/DFLS1150-7.stp

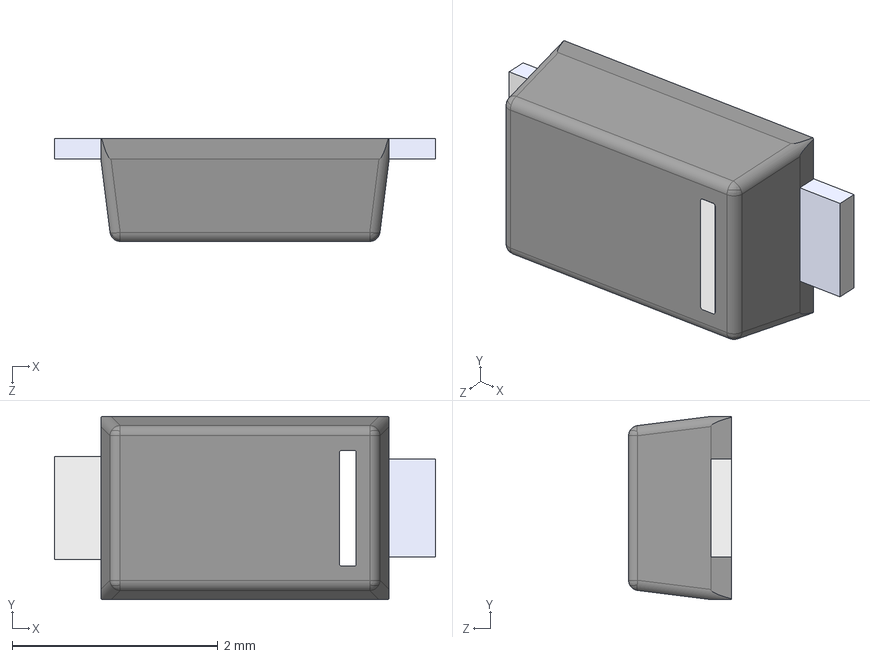
[picture p110: CAD file, 2025-04-15]
test_board/kicad-modules/shapes3d/DFLS1150-7.stp
3.70 x 1.78 x 1.00 mm
