VerivoltDev/test_board/test_board/kicad-modules/shapes3d/DCK0005A.stp

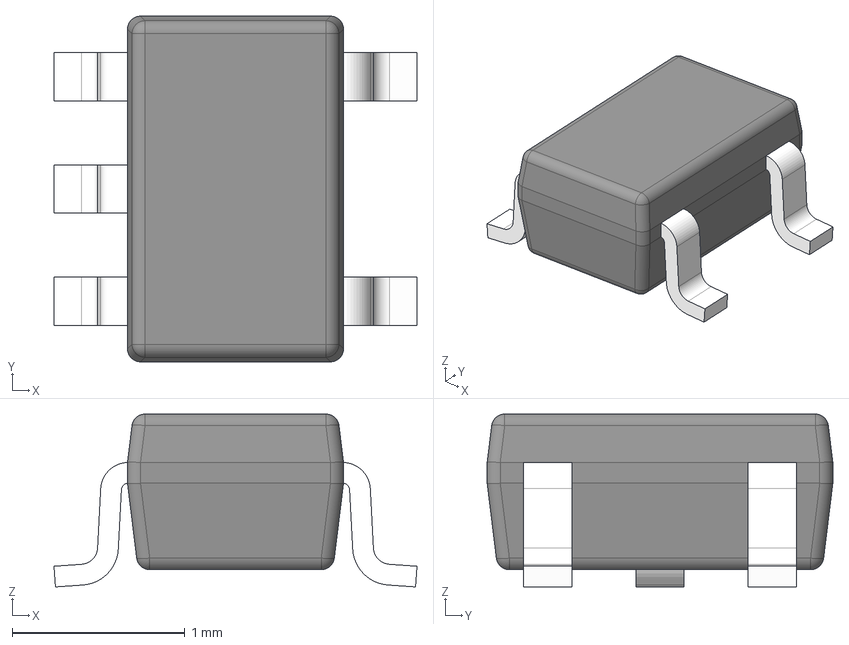
[picture p111: CAD file, 2025-04-15]
test_board/kicad-modules/shapes3d/DCK0005A.stp
2.10 x 2.00 x 1.00 mm
BODY-SOT
LEAD-SOT x 5
PIN1-ID
