VerivoltDev/test_board/test_board/kicad-modules/shapes3d/SN74LVC1G11DBVR.STEP

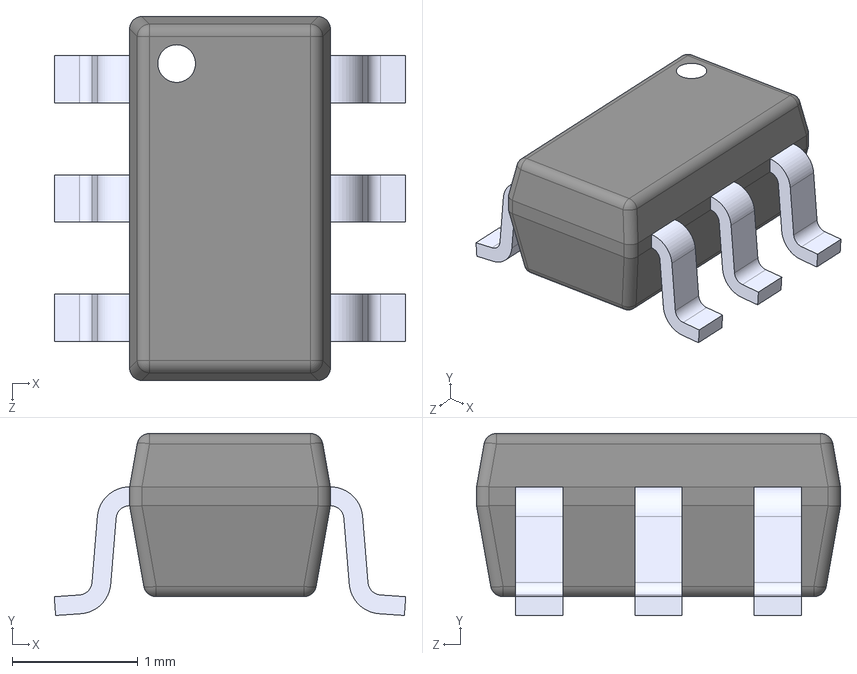
[picture p112: CAD file, 2025-04-15]
test_board/kicad-modules/shapes3d/SN74LVC1G11DBVR.STEP
2.80 x 1.45 x 2.90 mm
