VerivoltDev/test_board/test_board/kicad-modules/shapes3d/VLP-600-F.IGS

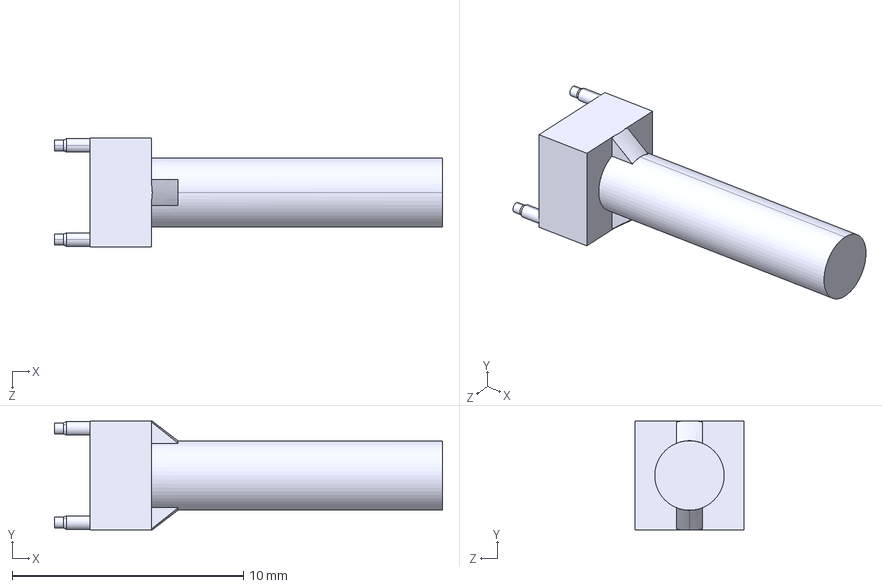
[picture p113: CAD file, 2025-04-15]
test_board/kicad-modules/shapes3d/VLP-600-F.IGS
16.8 x 4.70 x 4.70 mm
