VerivoltDev/test_board/test_board/kicad-modules/shapes3d/pxc_1792096_03_PLH-5-1-7-5_3D.stp

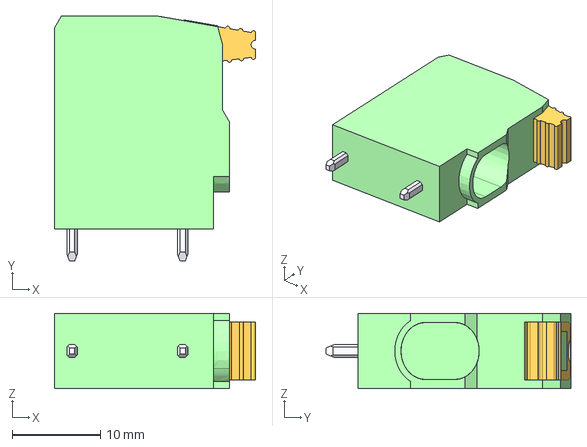
[picture p114: CAD file, 2025-04-15]
test_board/kicad-modules/shapes3d/pxc_1792096_03_PLH-5-1-7-5_3D.stp
22.8 x 27.7 x 8.50 mm
