VerivoltDev/test_board/test_board/kicad-modules/shapes3d/RLS-186.step

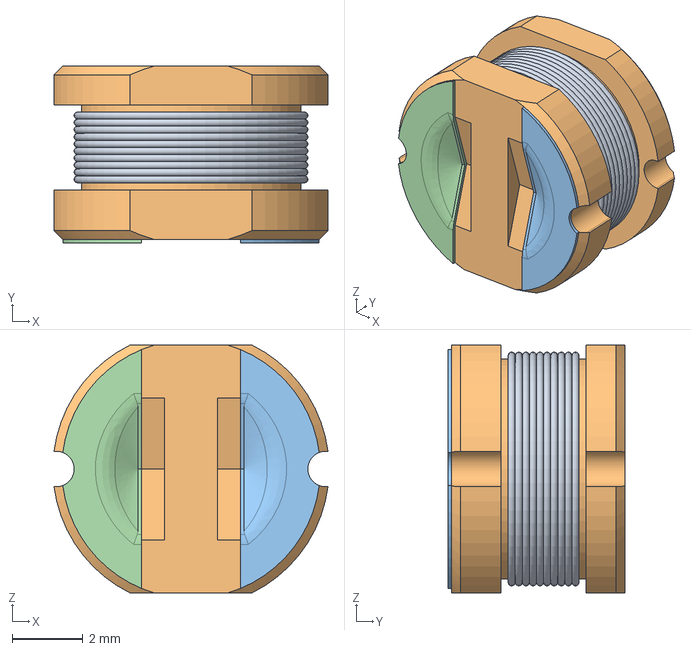
[picture p115: CAD file, 2025-04-15]
test_board/kicad-modules/shapes3d/RLS-186.step
7.74 x 5.00 x 7.00 mm
