VerivoltDev/test_board/test_board/kicad-modules/shapes3d/QFN24_4X4_SIL.step

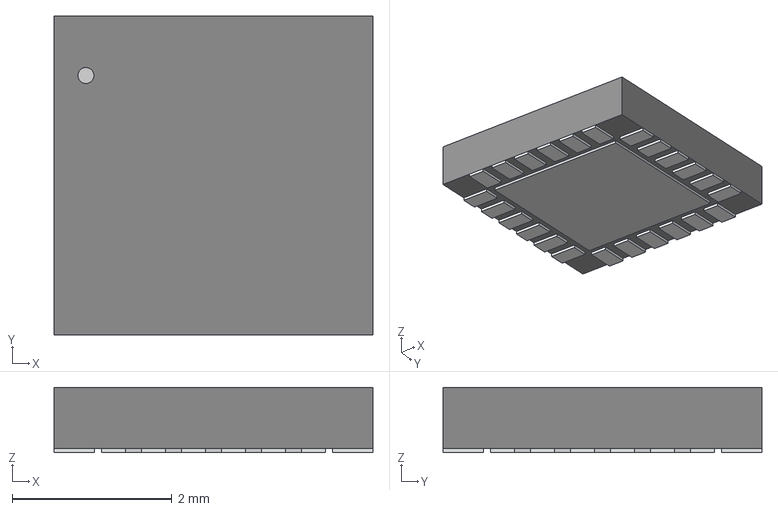
[picture p116: CAD file, 2025-04-15]
test_board/kicad-modules/shapes3d/QFN24_4X4_SIL.step
3.99 x 3.99 x 0.815 mm
