VerivoltDev/test_board/test_board/kicad-modules/shapes3d/MF-GSMF300_36X.STP

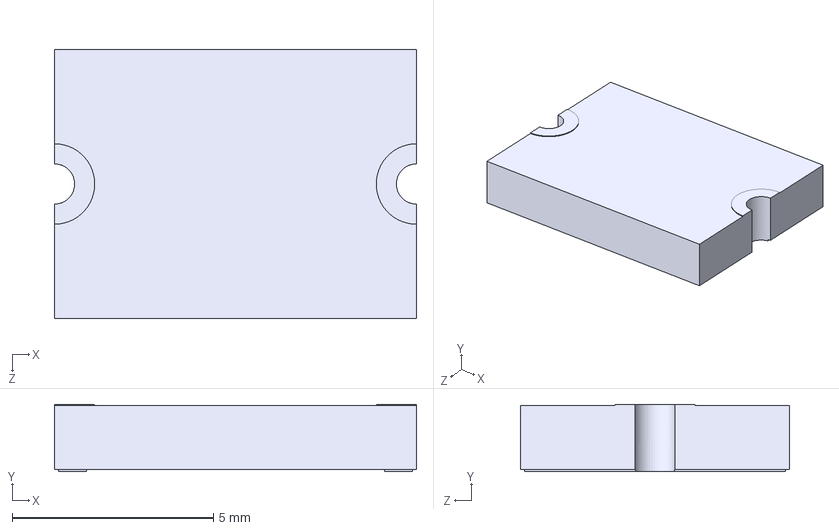
[picture p117: CAD file, 2025-04-15]
test_board/kicad-modules/shapes3d/MF-GSMF300_36X.STP
9.00 x 1.68 x 6.70 mm
