VerivoltDev/test_board/test_board/kicad-modules/shapes3d/DGK0008A.stp

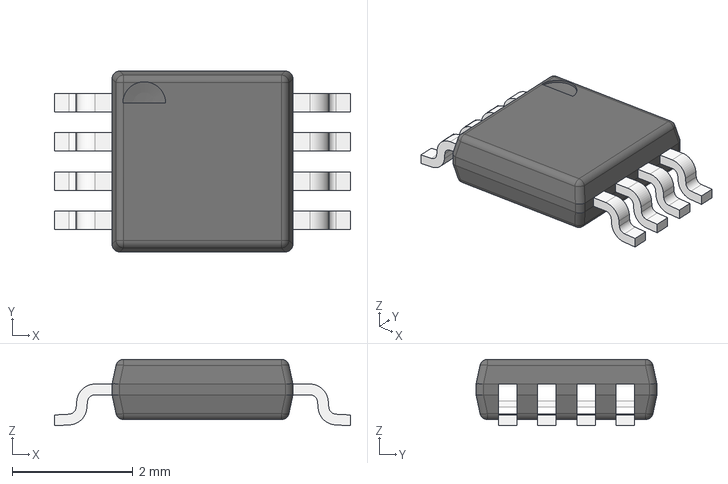
[picture p118: CAD file, 2025-04-15]
test_board/kicad-modules/shapes3d/DGK0008A.stp
4.90 x 3.00 x 1.10 mm
BODY_MUA08A
LEAD_MUA08A x 8
