VerivoltDev/test_board/test_board/kicad-modules/shapes3d/CON_505110-1692.stp

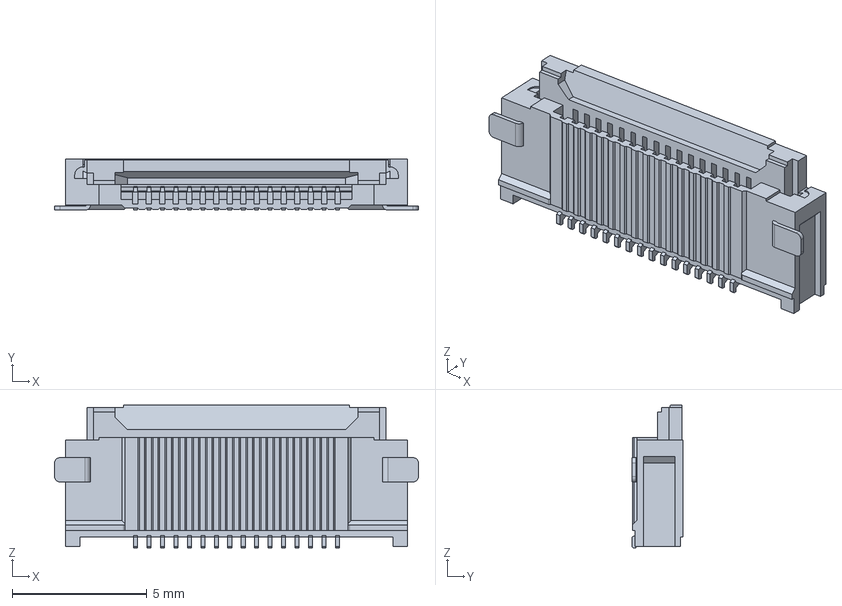
[picture p119: CAD file, 2025-04-15]
test_board/kicad-modules/shapes3d/CON_505110-1692.stp
13.5 x 1.90 x 5.30 mm
