VerivoltDev/test_board/test_board/kicad-modules/shapes3d/DMP4015SSSQ-13_SO8_DIO.step

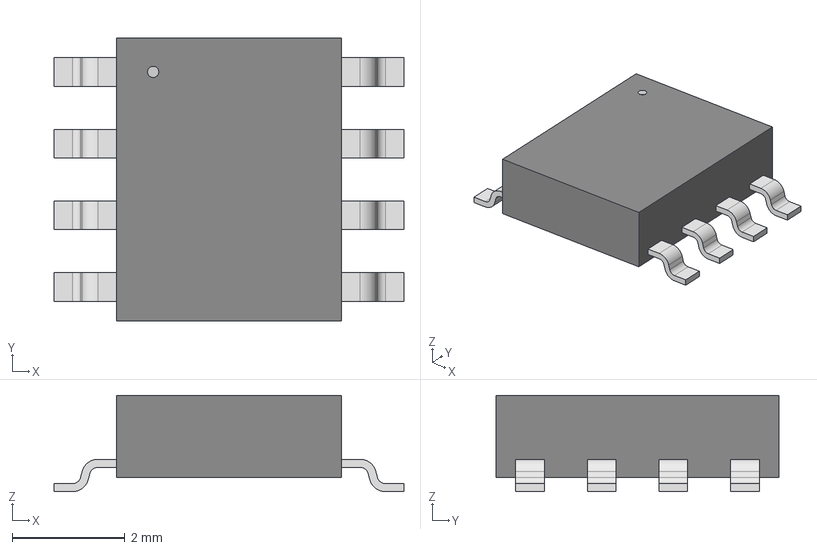
[picture p120: CAD file, 2025-04-15]
test_board/kicad-modules/shapes3d/DMP4015SSSQ-13_SO8_DIO.step
6.20 x 5.00 x 1.70 mm
