VerivoltDev/test_board/test_board/kicad-modules/shapes3d/FH12-16S-0.5SVA(54).STEP

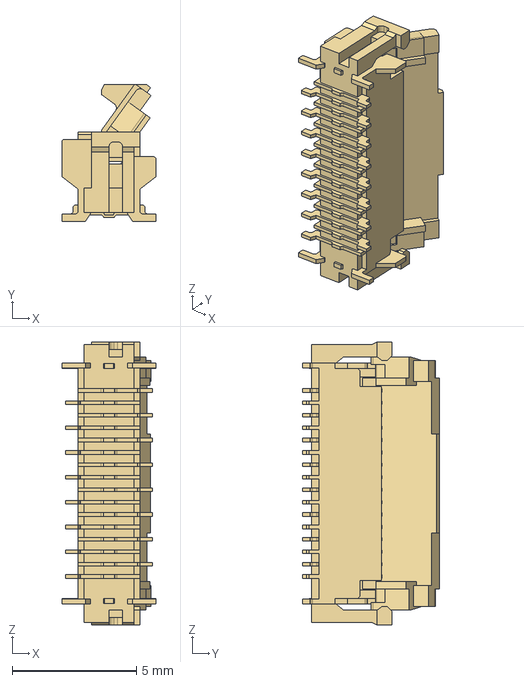
[picture p121: CAD file, 2025-04-15]
test_board/kicad-modules/shapes3d/FH12-16S-0.5SVA(54).STEP
3.80 x 5.50 x 11.4 mm
