VerivoltDev/test_board/test_board/kicad-modules/shapes3d/USB-A-S-X-X-VU.step

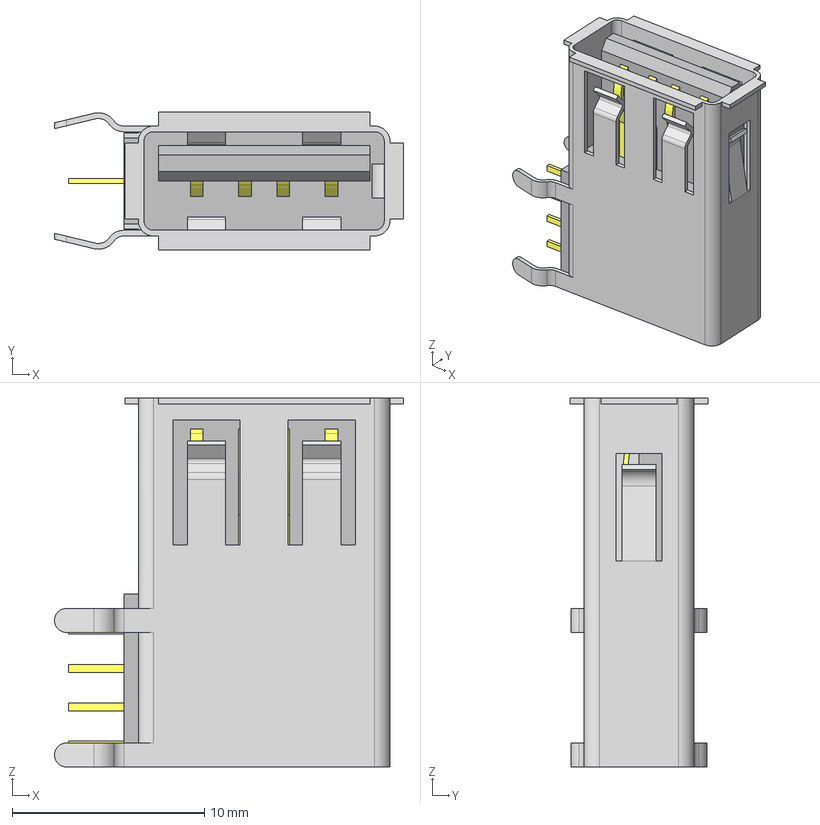
[picture p123: CAD file, 2025-04-15]
test_board/kicad-modules/shapes3d/USB-A-S-X-X-VU.step
18.2 x 7.20 x 19.2 mm
USB-A-S-VU_S
USB-A-S-B-VU_B
USB-A-S-VU_P
