VerivoltDev/test_board/test_board/kicad-modules/shapes3d/pxc_1844976_02_DMCV-0-5-12-G1-2-54-P20THR-R72_conn24p_3D.stp

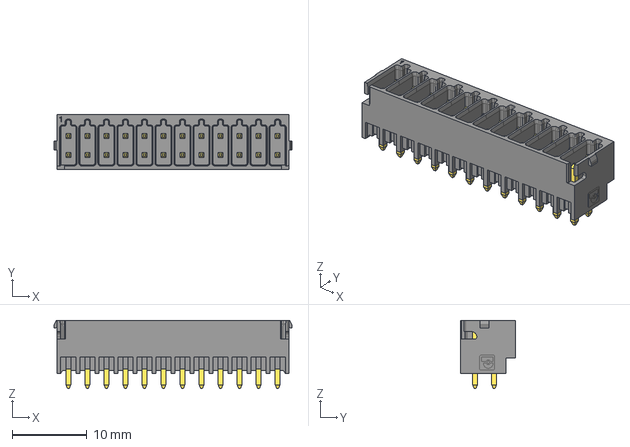
[picture p124: CAD file, 2025-04-15]
test_board/kicad-modules/shapes3d/pxc_1844976_02_DMCV-0-5-12-G1-2-54-P20THR-R72_conn24p_3D.stp
31.8 x 7.39 x 9.10 mm
