VerivoltDev/test_board/test_board/kicad-modules/shapes3d/USB Tipo C.stp

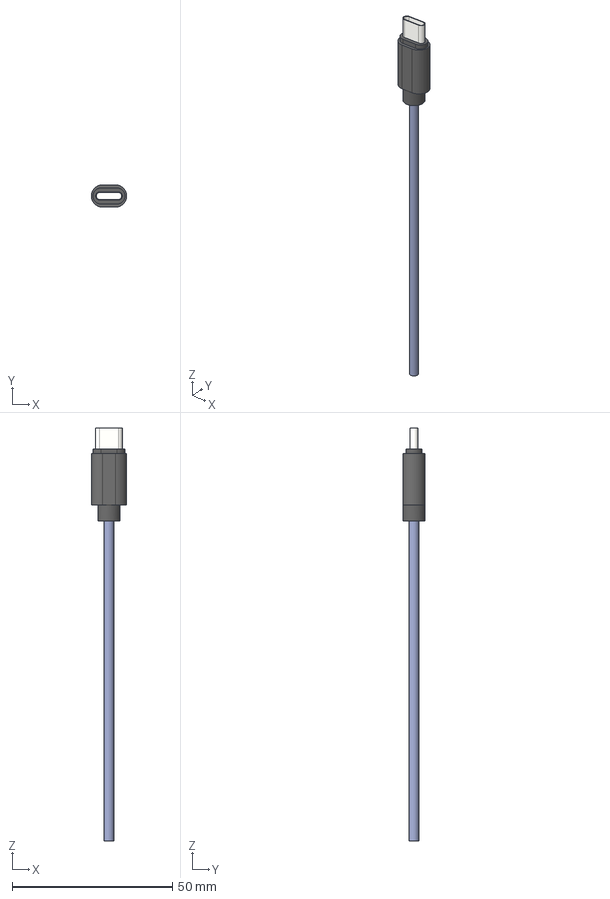
[picture p125: CAD file, 2025-04-15]
test_board/kicad-modules/shapes3d/USB Tipo C.stp
11.0 x 7.00 x 129.0 mm
