VerivoltDev/test_board/test_board/kicad-modules/shapes3d/0826-1K1T-43-F.stp

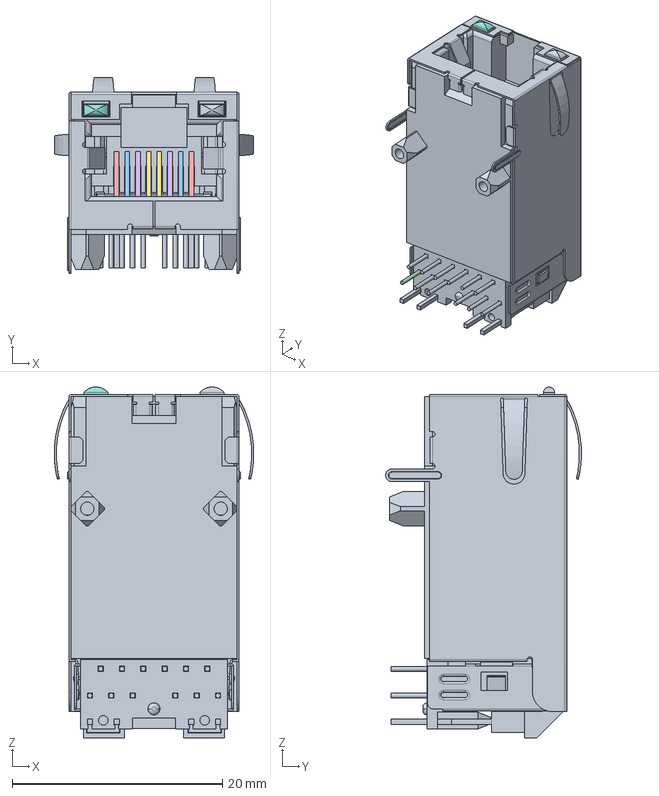
[picture p126: CAD file, 2025-04-15]
test_board/kicad-modules/shapes3d/0826-1K1T-43-F.stp
19.0 x 18.6 x 33.4 mm
0826-1K1T-43-F_PART1
0826-1K1T-43-F_PART2
0826-1K1T-43-F_PART3
0826-1K1T-43-F_PART4
0826-1K1T-43-F_PART5
0826-1K1T-43-F_PART6
0826-1K1T-43-F_PART7
0826-1K1T-43-F_PART8
0826-1K1T-43-F_PART9
0826-1K1T-43-F_PART10
0826-1K1T-43-F_PART11
0826-1K1T-43-F_PART12
0826-1K1T-43-F_PART13
0826-1K1T-43-F_PART14
0826-1K1T-43-F_PART15
0826-1K1T-43-F_PART16
0826-1K1T-43-F_PART17
0826-1K1T-43-F_PART18
0826-1K1T-43-F_PART19
0826-1K1T-43-F_PART20
0826-1K1T-43-F_PART21
