VerivoltDev/test_board/test_board/kicad-modules/shapes3d/TUSB8042AIRGCR.STEP

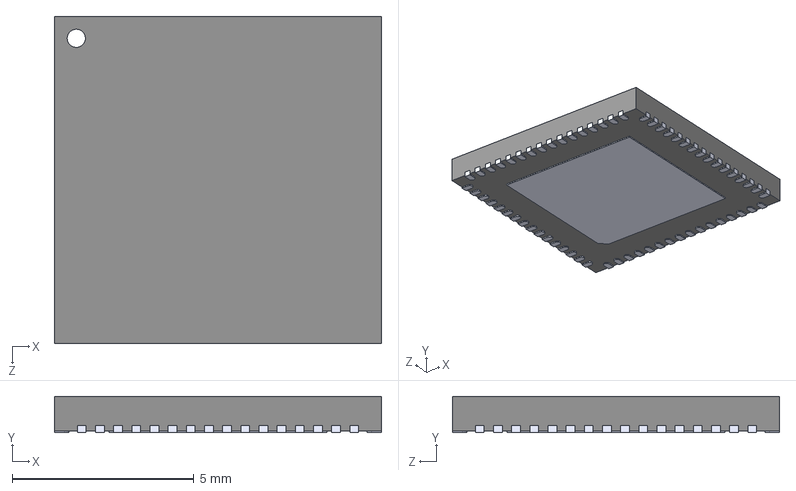
[picture p127: CAD file, 2025-04-15]
test_board/kicad-modules/shapes3d/TUSB8042AIRGCR.STEP
9.00 x 1.00 x 9.00 mm
