VerivoltDev/test_board/test_board/kicad-modules/shapes3d/RS12-2405SZ.step

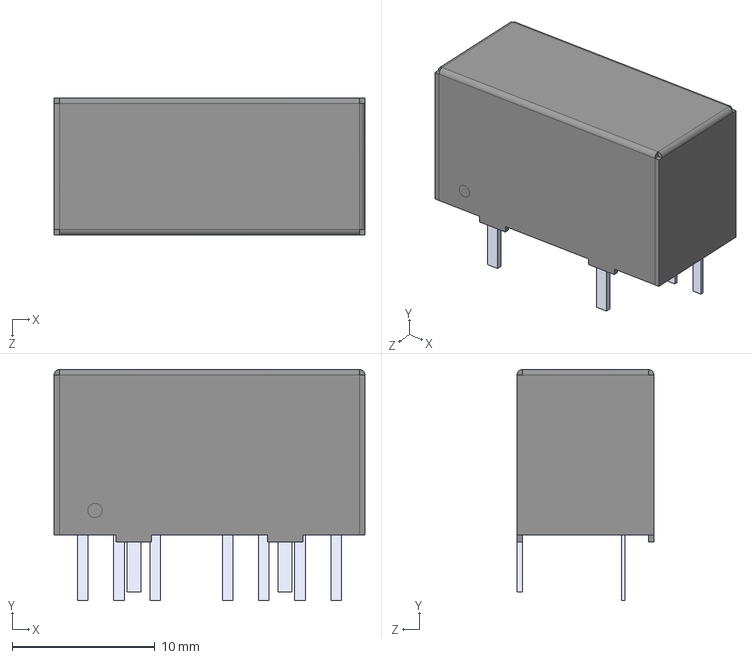
[picture p128: CAD file, 2025-04-15]
test_board/kicad-modules/shapes3d/RS12-2405SZ.step
21.8 x 16.2 x 9.60 mm
