VerivoltDev/test_board/test_board/kicad-modules/shapes3d/CP_8_5_ADI.step

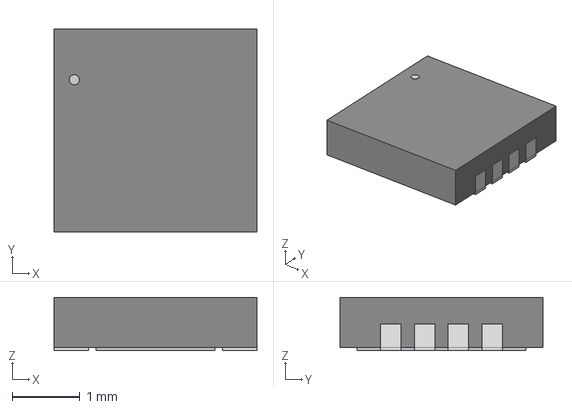
[picture p129: CAD file, 2025-04-15]
test_board/kicad-modules/shapes3d/CP_8_5_ADI.step
3.00 x 3.00 x 0.79 mm
