VerivoltDev/test_board/test_board/kicad-modules/shapes3d/Texas_S-PVSON-N8.step

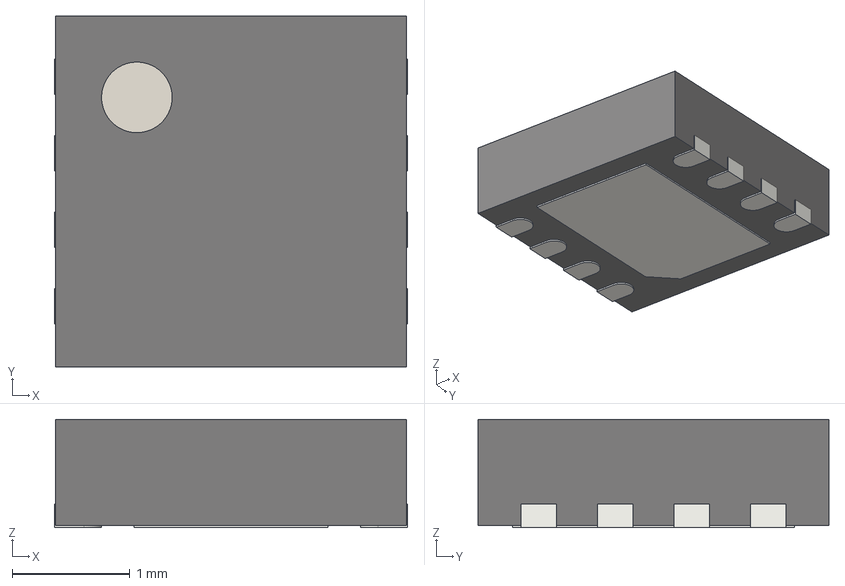
[picture p130: CAD file, 2025-04-15]
test_board/kicad-modules/shapes3d/Texas_S-PVSON-N8.step
3.00 x 2.98 x 0.92 mm
