VerivoltDev/test_board/test_board/kicad-modules/shapes3d/B4B-ZR-SM4-TF_LF__SN_.stp

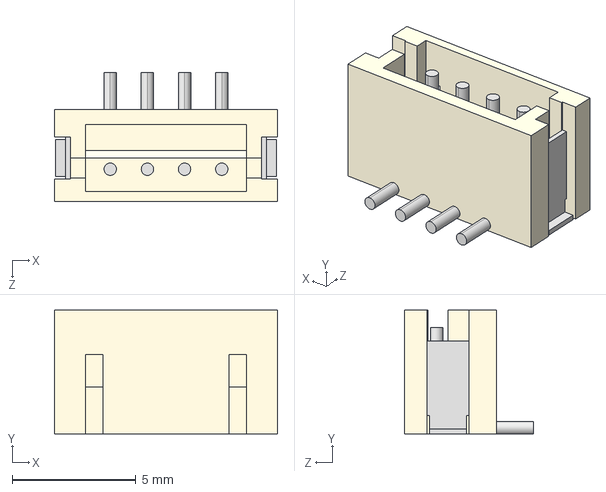
[picture p131: CAD file, 2025-04-15]
test_board/kicad-modules/shapes3d/B4B-ZR-SM4-TF_LF__SN_.stp
9.00 x 5.00 x 5.20 mm
