VerivoltDev/test_board/test_board/kicad-modules/shapes3d/DRY0006A.stp

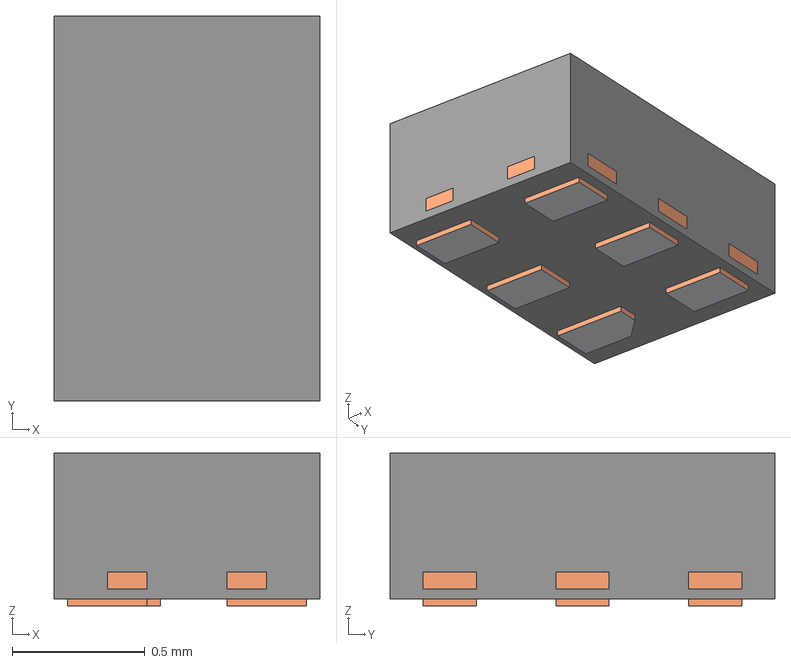
[picture p132: CAD file, 2025-04-15]
test_board/kicad-modules/shapes3d/DRY0006A.stp
1.00 x 1.45 x 0.575 mm
BODY-SON
FRAME-DRY0006A
PIN1-ID
