VerivoltDev/test_board/test_board/kicad-modules/shapes3d/WE-LHMI-4020_rev1.stp

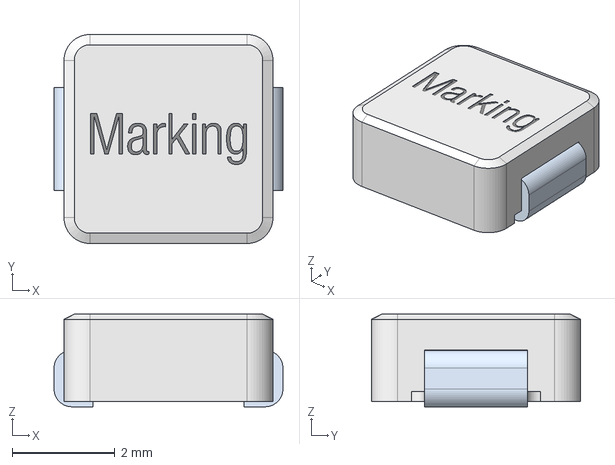
[picture p133: CAD file, 2025-04-15]
test_board/kicad-modules/shapes3d/WE-LHMI-4020_rev1.stp
4.45 x 4.06 x 1.80 mm
