VerivoltDev/test_board/test_board/kicad-modules/shapes3d/LDL212PVR.stp

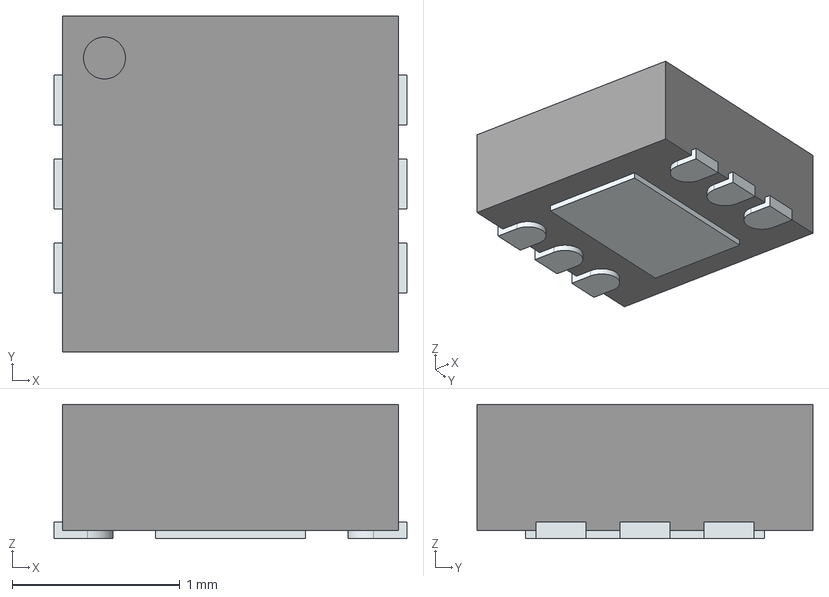
[picture p134: CAD file, 2025-04-15]
test_board/kicad-modules/shapes3d/LDL212PVR.stp
2.10 x 2.00 x 0.8 mm
ThermalPin
PinsArrayLR
