VerivoltDev/test_board/test_board/kicad-modules/shapes3d/2604-1103.stp

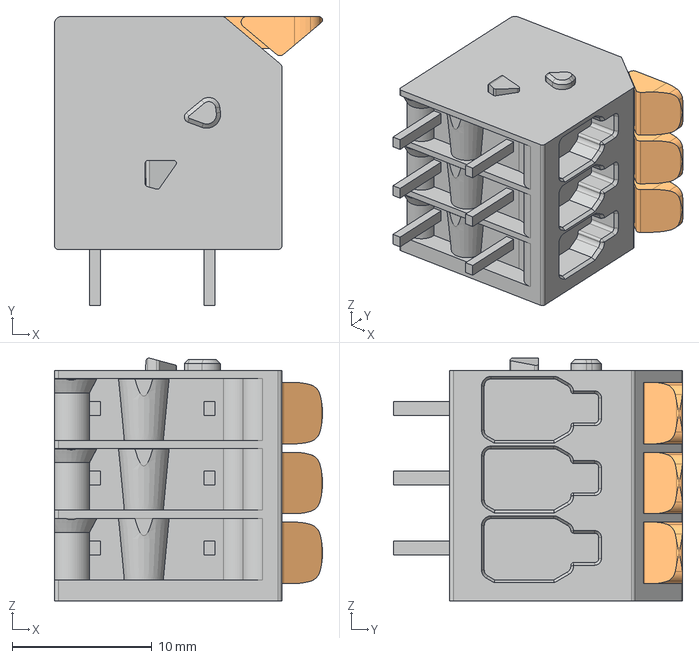
[picture p135: CAD file, 2025-04-15]
test_board/kicad-modules/shapes3d/2604-1103.stp
19.2 x 20.7 x 17.4 mm
