VerivoltDev/test_board/test_board/kicad-modules/shapes3d/USB4115-03-C_REVB2.step

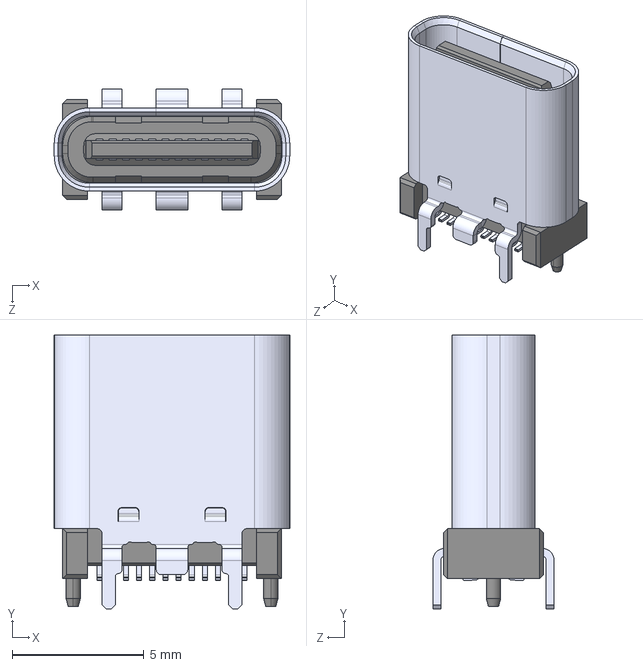
[picture p136: CAD file, 2025-04-15]
test_board/kicad-modules/shapes3d/USB4115-03-C_REVB2.step
8.94 x 10.4 x 4.60 mm
