VerivoltDev/test_board/test_board/kicad-modules/shapes3d/MAXM17632AME.step

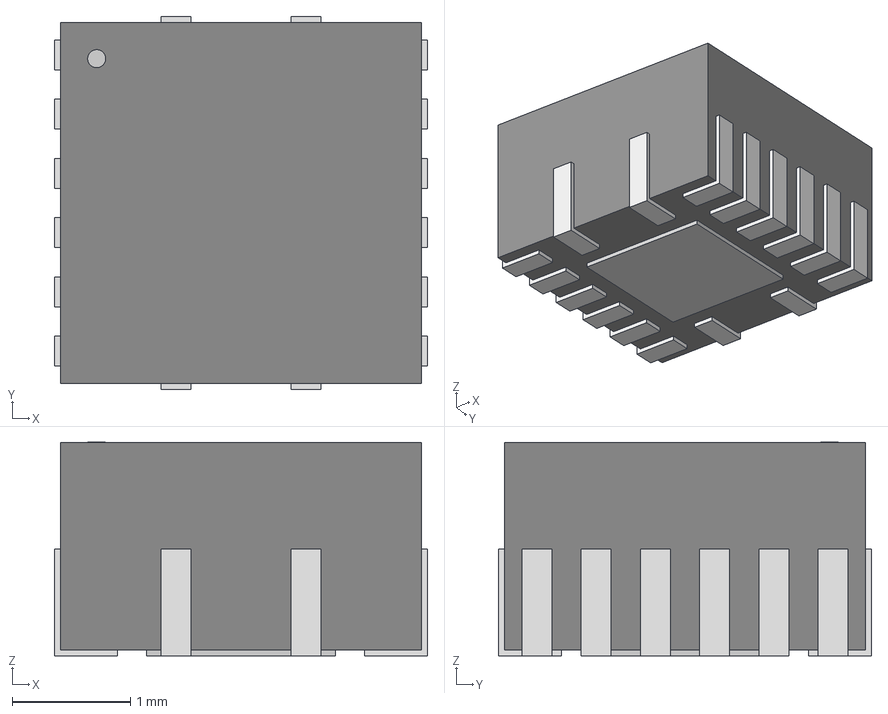
[picture p137: CAD file, 2025-04-15]
test_board/kicad-modules/shapes3d/MAXM17632AME.step
3.15 x 3.15 x 1.81 mm
