VerivoltDev/test_board/(list of files, cad)

Other CAD files:
test_board/kicad-modules/shapes3d/SOT23_NEX.step
test_board/kicad-modules/shapes3d/DFN-12_DD_LIT_LTC2953IDD-1-PBF.step
test_board/kicad-modules/shapes3d/CUI_PDQE15-Q24-S5-D.step
modules/footprint/10155435-00011LF--3DModel-STEP-510211.STEP
modules/footprint/10155435-00011LF.step
modules/footprint/104031-0811.stp
modules/footprint/1050570001.stp
modules/footprint/4341x30258x6.stp
modules/footprint/744231091.stp
modules/footprint/VLS201612CX-1R5M-1.stp
modules/footprint/VLS201612ET-100M.stp
modules/footprint/VLS201612HBX-1R0M-1.stp
test_board/kicad-modules/modules/10128793-001RLF.step
test_board/kicad-modules/shapes3d/10155435-00011LF.step
test_board/kicad-modules/shapes3d/1149867.stp
test_board/kicad-modules/shapes3d/1707719-1748435.step
test_board/kicad-modules/shapes3d/1821229-1821520.step
test_board/kicad-modules/shapes3d/1PS79SB30,115.STEP
test_board/kicad-modules/shapes3d/21-0057F_MXM.step
test_board/kicad-modules/shapes3d/2604-1102.stp
test_board/kicad-modules/shapes3d/4341x30258x6.stp
test_board/kicad-modules/shapes3d/473092651.stp
test_board/kicad-modules/shapes3d/476SML100M.stp
test_board/kicad-modules/shapes3d/48406-0003.stp
test_board/kicad-modules/shapes3d/484090003.stp
test_board/kicad-modules/shapes3d/55323-5.stp
test_board/kicad-modules/shapes3d/744231091--3DModel-STEP-56544.STEP
test_board/kicad-modules/shapes3d/744231091.stp
test_board/kicad-modules/shapes3d/744273102_WE-SL5-HC_rev1.stp
test_board/kicad-modules/shapes3d/75869-302LF--3DModel-STEP-533217.STEP
test_board/kicad-modules/shapes3d/8000078315.stp
test_board/kicad-modules/shapes3d/8000078317.stp
test_board/kicad-modules/shapes3d/8000078354.stp
test_board/kicad-modules/shapes3d/8000078356.stp
test_board/kicad-modules/shapes3d/830081609.stp
test_board/kicad-modules/shapes3d/865080645012.stp
test_board/kicad-modules/shapes3d/9774010151R (rev1).stp
test_board/kicad-modules/shapes3d/9774025151R.stp
test_board/kicad-modules/shapes3d/9774080951R (rev1).stp
test_board/kicad-modules/shapes3d/ALT3232M-151-T001.step
test_board/kicad-modules/shapes3d/B2B-EH-A.step
test_board/kicad-modules/shapes3d/BIVAR__INC_VLP-600-F.step
test_board/kicad-modules/shapes3d/BM04B-SRSS-TB_LF__SN_.stp
test_board/kicad-modules/shapes3d/BTH-070-02-L-D-A.step
test_board/kicad-modules/shapes3d/CAP_PEVPFV_10X10P5_RUB.step
test_board/kicad-modules/shapes3d/CUI_DEVICES_TBP02R1W-381-02BE.step
test_board/kicad-modules/shapes3d/CUI_DEVICES_UJ32-C-V-G-SMT-TR.step
test_board/kicad-modules/shapes3d/DF13-4P-1.25V.stp
test_board/kicad-modules/shapes3d/DFE252012PD-R47M_P2.step
test_board/kicad-modules/shapes3d/DLM0QSN900HY2D.step
test_board/kicad-modules/shapes3d/DMN1260UFA-7B.step
test_board/kicad-modules/shapes3d/DQJ0008A_CSD18534Q5A.stp
test_board/kicad-modules/shapes3d/DSG0008A.stp
test_board/kicad-modules/shapes3d/EAST1410RGBW02.step
test_board/kicad-modules/shapes3d/EXB-2HVR000V.stp
test_board/kicad-modules/shapes3d/GSB412137CHR.step
test_board/kicad-modules/shapes3d/KDB0305HA3-00C1J.stp
test_board/kicad-modules/shapes3d/M50-1920005_asm.stp
test_board/kicad-modules/shapes3d/M55-6004042R.stp
test_board/kicad-modules/shapes3d/M55-6024042_asm.stp
test_board/kicad-modules/shapes3d/M55-7004042_asm.stp
test_board/kicad-modules/shapes3d/M55-7005042R.stp
test_board/kicad-modules/shapes3d/M55-7025042_asm.stp
test_board/kicad-modules/shapes3d/MDT420M01001--3DModel-STEP-56544.STEP
test_board/kicad-modules/shapes3d/PD70210AILD-TR.stp
test_board/kicad-modules/shapes3d/PD70224ILQ-TR.step
test_board/kicad-modules/shapes3d/QTH-060-03-F-D-DP-A.stp
test_board/kicad-modules/shapes3d/RDA0015A.stp
test_board/kicad-modules/shapes3d/RJ_6_ADI.step
test_board/kicad-modules/shapes3d/SMB-2_4P60X3P95_ONS.step
test_board/kicad-modules/shapes3d/SOIC8W.stp
test_board/kicad-modules/shapes3d/STEP/RDA0015A.stp
test_board/kicad-modules/shapes3d/TBP02R1W-381-02BE.step
test_board/kicad-modules/shapes3d/TL7702BIDR.STEP
test_board/kicad-modules/shapes3d/TLV62084DSGR.STEP
test_board/kicad-modules/shapes3d/TPS22962DNYR.step
test_board/kicad-modules/shapes3d/TPS22963CYZPR.STEP
test_board/kicad-modules/shapes3d/TPS22963CYZPR.step
test_board/kicad-modules/shapes3d/TPS22963CYZPR.stp
test_board/kicad-modules/shapes3d/TPS26600RHFR.stp
test_board/kicad-modules/shapes3d/TPS51206DSQR.step
test_board/kicad-modules/shapes3d/TPS7A3001DRBR.stp
test_board/kicad-modules/shapes3d/TXU0204RUTR.STEP
test_board/kicad-modules/shapes3d/W958D8NBYA5I_TR.stp
test_board/kicad-modules/shapes3d/X2SON-8.stp
test_board/kicad-modules/shapes3d/m55-6015042.stp
test_board/kicad-modules/shapes3d/pxc_1149871_00_00_CUC-SP-J1ST-S-R4LT-THR-LED_3D.stp
test_board/kicad-modules/shapes3d/spacer_for_m2-5_hs-4-8.stp
