VerivoltDev/test_board/test-code/esp32c3/README.md

# Software by esp32

```bash
.
├── ESP32_GENERIC_C3-20241129-v1.24.1.bin
├── gpio-echo.py
├── main.py
├── Makefile
├── README.md
├── rs485full.py
└── test-board.ps
```
