VerivoltDev/test_board/test-code/powerwatch/rs422-echo/README.md

# Instrucciones

1. Ejecutar el bash para activar los gpios del modo rs422

```bash
bash rs422-echo.bash init # Ejecutar una única vez, sino, genera error
bash rs422-echo.bash set
```

2. Ejecutar la aplicación para pruebas del rs422 `./rs422-echo` 

```bash
./rs422-echo # podrá ver los ejemplos de uso
```

```
