VerivoltDev/test_board/test-code/powerwatch/spi-bin/README.md

```bash
rm /lib/firmware/am64-main-r5f0_0-fw
# Copy and paste file
cp ./SPIFlash.out /lib/firmware/am64-main-r5f0_0-fw

```
