VerivoltDev/test_board/test-code/powerwatch/gpio-sysfs-test.md

devmem2 0x000F40A8
devmem2 0x000F40A8 w 0x00050007
echo 466 > /sys/class/gpio/export
