VerivoltDev/test_board/test_board/test_board.png

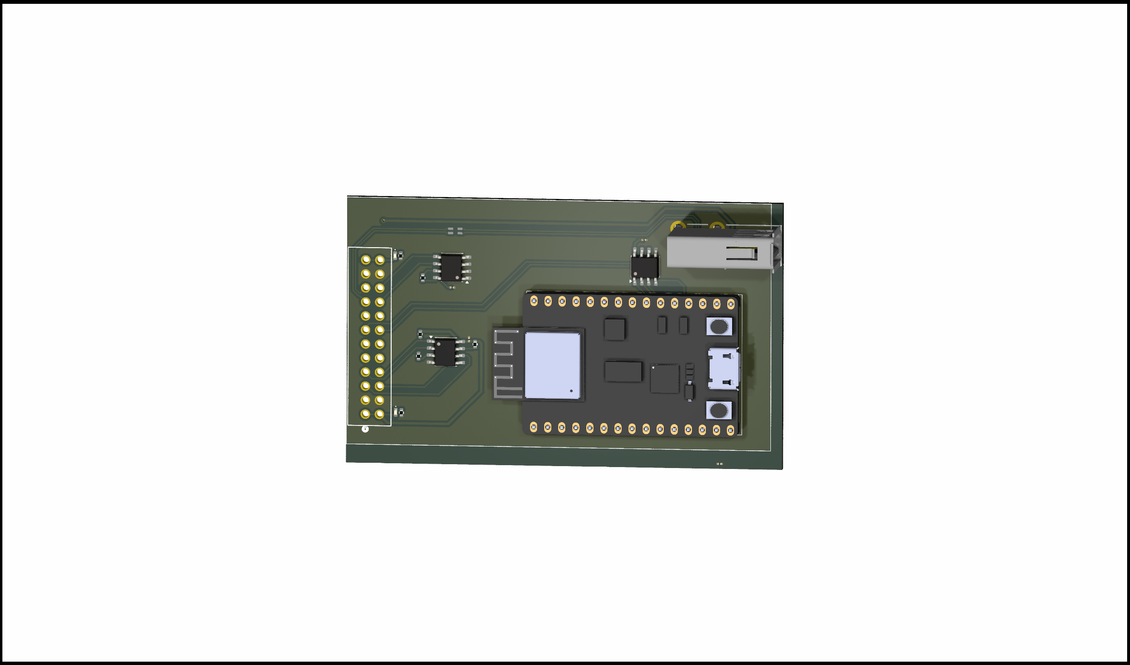
test_board/test_board.png
