VerivoltDev/test_board/test_board/test_board.pdf

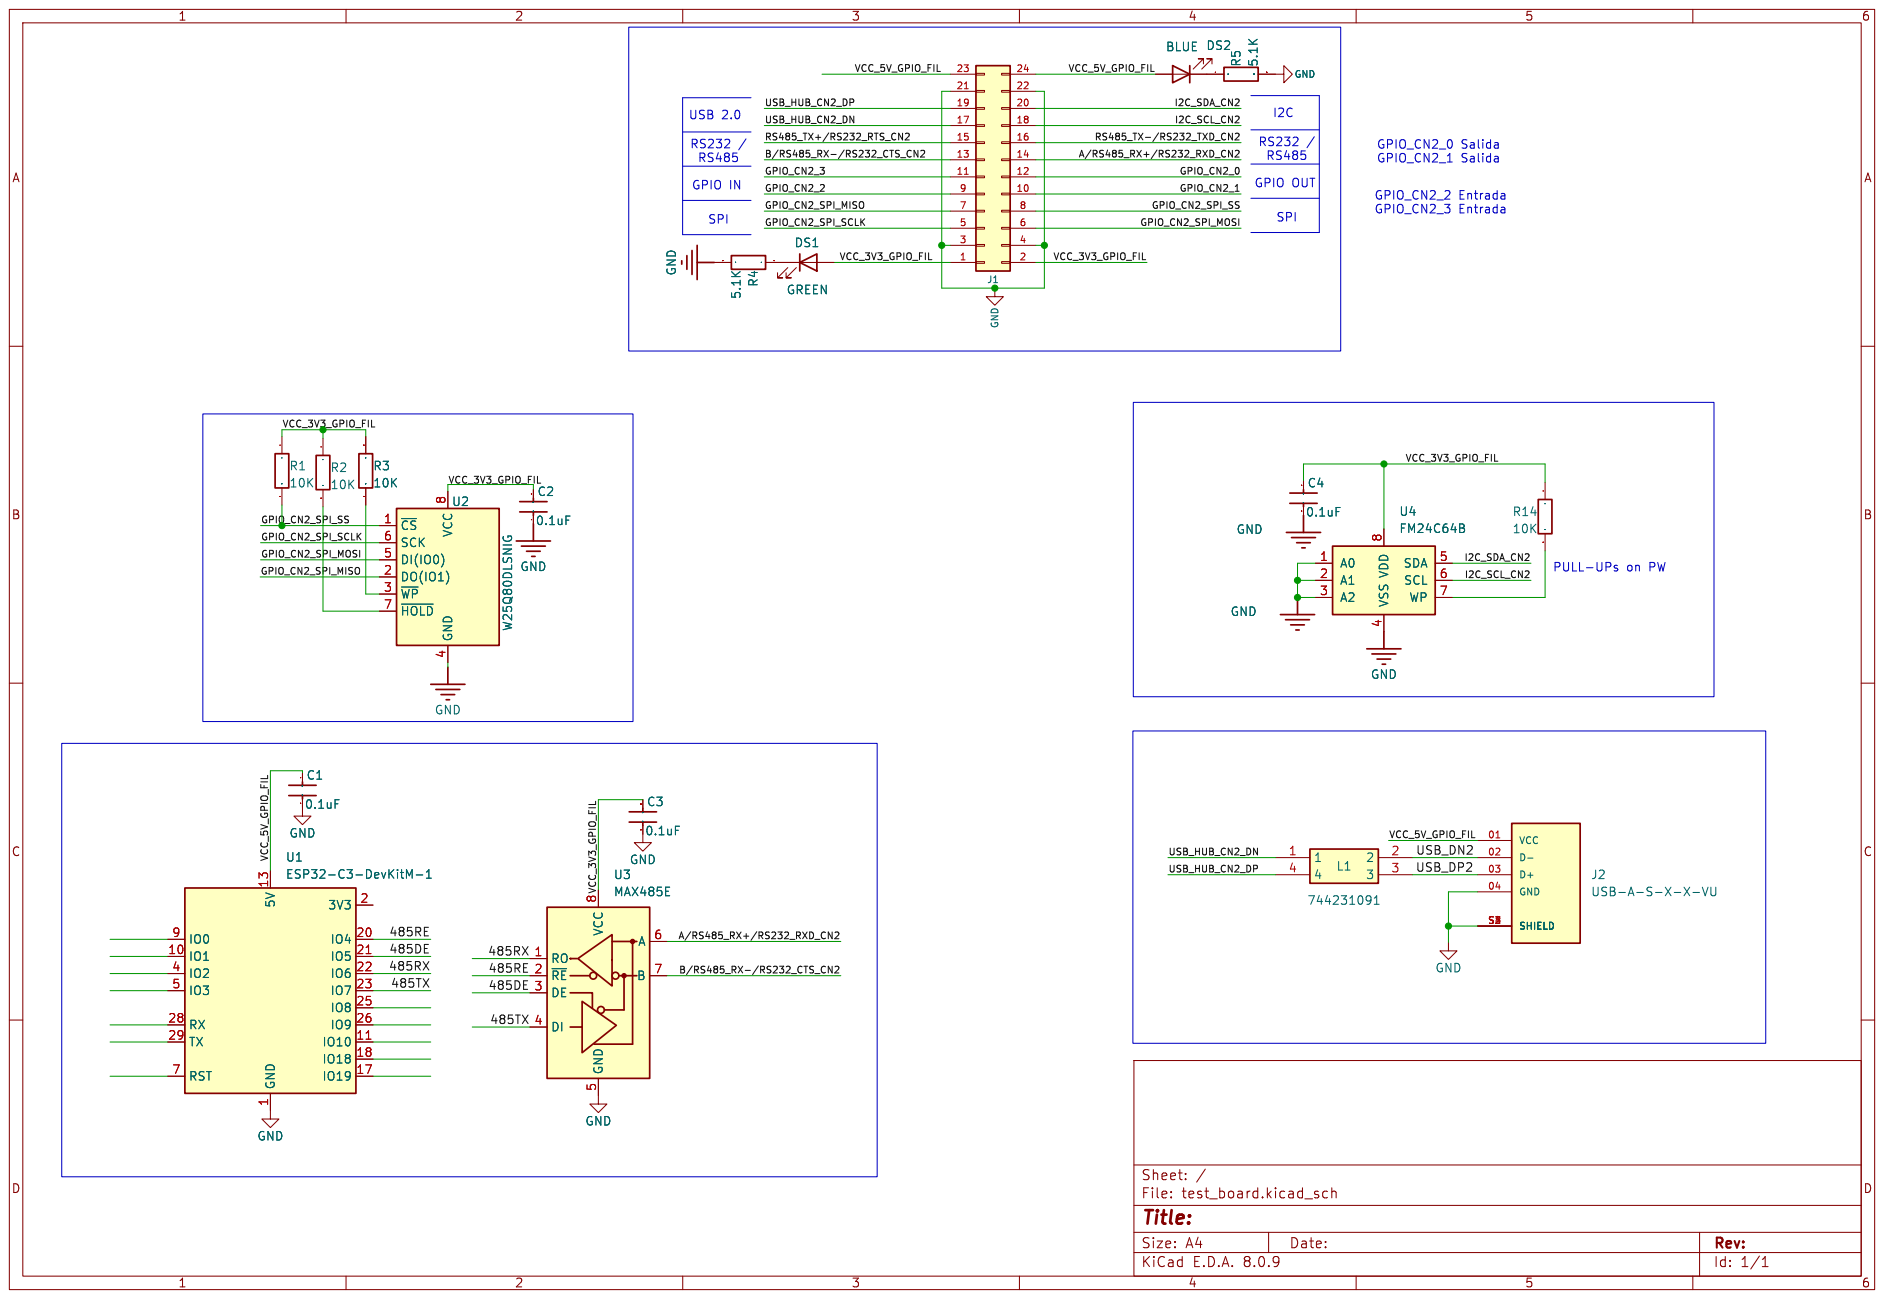
[picture p139: page 1]

I2C GND
I2C_SCL_CN2 GPIO_CN2_1 SPI RS232 / RS485 USB 2.0 GPIO IN

4 DI(IO0) 5 SCK 6 ~{HOLD} 7 VCC

4 SDA 5 SCL 6 WP 7 VDD

2 U3 MAX485E RO 1 ~{RE} 2 DE 3 DI 4 GND
