VerivoltDev/test_board/(list of files, drawings)

Other design files:
modules/footprint/oshw-logo.pcb
