VerivoltDev/test_board/(commit log)

2025-04-15 Burning test board
    [070-6052 (rev1).STEP, 0826-1K1T-43-F.stp, 10128793-001RLF.step, 10155435-00011LF--3DModel-STEP-510211.STEP, 10155435-00011LF.step, 104031-0811.stp, 1149867.stp, 1206SFF800F&slash_24-2.step]
2025-04-15 add test-code for esp32 and powerwatch
    [test_board-B_Cu.gbr, test_board-B_Mask.gbr, test_board-B_Paste.gbr, test_board-B_Silkscreen.gbr, test_board-Edge_Cuts.gbr, test_board-F_Cu.gbr, test_board-F_Mask.gbr, test_board-F_Paste.gbr]
2025-04-16 Changing USB and SPI memory footprint to adapt to existent devices
    [test_board-B_Cu.gbr, test_board-B_Mask.gbr, test_board-B_Paste.gbr, test_board-B_Silkscreen.gbr, test_board-Edge_Cuts.gbr, test_board-F_Cu.gbr, test_board-F_Mask.gbr, test_board-F_Paste.gbr]
2025-04-20 Routing, adding 3D models
    [1050570001.stp, ESP32C3_super_mini.step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]
2025-04-21 Configuring both max485 to a single mode of operation
    [test_board-B_Cu.gbr, test_board-B_Mask.gbr, test_board-B_Paste.gbr, test_board-B_Silkscreen.gbr, test_board-Edge_Cuts.gbr, test_board-F_Cu.gbr, test_board-F_Mask.gbr, test_board-F_Paste.gbr]
2025-04-23 mounting holes
    [test_board.kicad_pcb, test_board.kicad_sch]
2025-04-23 FAB Files
    [test_board-B_Cu.gbr, test_board-B_Mask.gbr, test_board-B_Paste.gbr, test_board-B_Silkscreen.gbr, test_board-Edge_Cuts.gbr, test_board-F_Cu.gbr, test_board-F_Mask.gbr, test_board-F_Paste.gbr]
2025-04-24 bom mouser update
    [bom.csv, test_board.kicad_sch]
2025-04-24 jlcpart map
    [BOM-test_board.csv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]
2025-04-24 usb part
    [BOM-test_board.csv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]
2025-05-08 Renamed gpio in esp32
    [test_board.kicad_sch]
2025-05-19 Fixing WP resistor y
    [test_board-B_Cu.gbr, test_board-B_Mask.gbr, test_board-B_Paste.gbr, test_board-B_Silkscreen.gbr, test_board-Edge_Cuts.gbr, test_board-F_Cu.gbr, test_board-F_Mask.gbr, test_board-F_Paste.gbr]
