VerivoltDev/test_board/(notices)

Notices in the files:
test_board/kicad-modules/shapes3d/Texas_S-PVSON-N8.step:
Copyright (C) 2017, kicad StepUp
This program is free software: you can redistribute it and/or modify
it under the terms of the GNU General Public License as published by
the Free Software Foundation, either version 3 of the License, or
any later version.
itself might be covered by the GNU General Public License.
test-code/powerwatch/devmem2.c:
the Free Software Foundation; either version 2 of the License, or
(at your option) any later version.
test_board/kicad-modules/shapes3d/QTH-040-04-X-D-DP-A.step:
author */ ('License CC BY-ND 4.0'),
